ShellAlbert/PoFDualCAM/1-POF-PSU-C2/Schematic/SCH-PSU-C2.pdf

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
Here Vnormal=3.3V, Vcutoff=1.8V, t=10 seconds, I=100mA. C=[(Vnormal+Vcutoff)*I*t] / [(Vnormal^2-Vcutoff^2)] C=[(3.3+1.8)*0.1*10] / [3.3^2-1.8^2]=0.667F

## Farad Capacitor

The output voltage can be adjusted between 1.6V and 5.25V. Vout=1.004V*(R1/R2+1)=1.004V*(1M/270K+1)=4.72V

### LTC3105 400mA Step-Up DC/DC Converter Auxiliary 6mA LDO Regulator

Photovoltaic Cell

Photovoltaic Cell

VIN PIN
When used with high impedance sources such as photovoltaic cells, this pin should have a 10uF or larger decoupling capacitor.

MPPC PIN
Connect a resistor from MPPC to GND to program the activation point for MPPC loop. To disable the MPPC circuit, connect MPPC directly to GND.
VMPPC=10uA*RMPPC
=10uA*200K
=0.01mA*200K
=0.01A*200
=2V

THIS RESISTOR IS USED TO BYPASS AMP.

P5V0

### Vout=1.2V*(1+R2/R1) =1.2V*(1+1M/309K)

=5.08V

LTC3539
2A 1MHz Synchronous Step-Up DC/DC Converters VIN=0.7V~5V

## GAIN=1

ADA4051-1
1.8V,Micropower,Zero-Drift,
Rail-to-Rail Input/Output Op Amps 1/2Vcc | Input Independance >> 1M 1/3Vcc ADJ

## VCMP

# Open-Drain

## VCMP

OR

## OR Y=A|B

## AND Y=A&B

BIAS

Make sure IO is in tri-state during power up.

### MODE = High: Burst Mode operation at light loads, >=0.88V MODE = Low: Fixed frequency PWM Mode, <0.3V

CAUTION: No Polarity Protection Circuit Designed ! DIODES OR MOSFETS WILL CAUSE VOLTAGE DROP.

# IVC AMP

# BYPASS NOT

# CMP

LDO 2.2V/6mA
LDO22-1: UNIT GAIN AMP, HYSTERESIS VOLTAGE COMPARATOR, AND GATE LDO22-2: HYSTERESIS VOLTAGE COMPARATOR+OR GATE, OR GATE

OR

### AND

LED turns on at
I=(5.0-2.2)/56K=50uA

Vin_rise=Vref*(R1+R2)/R2
=1.0V*(160+300)/300
=1.53V

Vin_fall=(Vref*(R1+R2+Rpullup)-Vsupply*R1)/(R2+Rpullup) =(1.0v*(160+300+10000)-(2.2V*160))/(300+10000) =0.98

Since there's a 1/3 voltage divider before input,
the realistic action voltage are as follow ing Vin_rise=1.53V*3=4.59V
Vin_fall=0.98V*3=2.94V

Vin_rise=Vref*(R1+R2)/R2
=1.0V*(1000+5100)/5100
=1.2V

Vin_fall=(Vref*(R1+R2+Rpullup)-Vsupply*R1)/(R2+Rpullup) =(1.0v*(1000+5100+20000)-(2.2V*1000))/(5100+20000) =0.95V

Since there's a 1/2 voltage divider before input,
the realistic action voltage as follow ing Vin_rise=1.2V*2=2.4V
Vin_fall=0.95V*2=1.9V

# 1.9V(FALL) 2.4V(RISE)

# 2.94V(FALL) 4.59V(RISE)

L=Vout*(1-D)*T/(CR*Iout)
=5.0*(1-50%)*1uS/(30%*200mA) =4.2uH

Vfd=1.23V

Ve

R2

R1

R4

R3

Re

Rin

Appropriate Parameters
Case 1: R1=R2=R3=510, R4=560, Re=51, Rin=5.1K Case 2: R1=R2=R3=1K, R4=1.2K, Re=62, Rin=8.2K

CDONE,
Open-drain Output Configuration Done output. With weak pullup resistor to VCCIO_X.

# 1.8V IO

# SPI PROGRAMMING INTERFACE

# sysCONFIG Port / Pins

Horizontal-Short to Program Flash Vertical-Short to Program iCE

# OPEN-DRAIN PULL-UP

The sysCONFIG pins are dual function,
meaning they can be recovered as user I/O after configuration is complete.

# BUFFERING Octal RAM

2.0V

# ECL DRIVER

# CONNECT TO TMR/DPU POWER TO DPU

# RECEIVE: IVC->AMP->CMP->NOT

# OFFSET=1/2VCC

# NOT

VTH SETTING

The maximum source/sink current of IOs are 4mA.

## (1.8V IO)

## (1.8V IO)

## (1.8V IO)

EXCLUSIVE
LD_PWR_EN FOR TMR
LD_PWR_EN_EXT FOR DPU

EXCLUSIVE
PSU_UART_TX FOR TMR
DPU_UART_TX FOR DPU

EXCLUSIVE
PSU_UART_RX FOR TMR
DPU_UART_RX FOR DPU

TMR SENSOR NEEDS 3.3 V POWER SUPPLY. DROP DOWN TO 2.8V IF IT'S COMPATIBLE.

Inductor peak current automatic adjusting to maximize efficiency 100mA at light load, 500mA at heavy load,
100mA to 500mA at intermediate loads.
This function is overridden by MPPC function.
Theoretically, maximum power output of photovoltaic cell is 250mW.
If we set VMPPC to maintain 2V, the peak inductor current is 250mW/2=125mA.

The MPPC circuit dynamically regulates the average inductor current to prevent the input voltage from dropping below the MPPC threshold. When Vin is greater than the MPPC voltage, the inductor current is increased until Vin is pulled down to the MPPC set point.
If Vin is less than the MPPC voltage, the inductor current is reduced until Vin rises to the MPPC set point.

LC LOW PASS FILTER
f-cutoff=1/(2*pi*sqrt(L*C)) =1/(2*3.1415*sqrt(10uH*22uF)=1073Hz

0R

0R

Jumpers used to cut off power supply of FPGA if it’s useless in realistic application.

# LTC3539 BOOST

P5V0

# MAX38650 BUCK

P1V8

# LTC3542 BUCK

# LTC3542 BUCK

# LASER DIODE TX&RX (ADJ)

# SENSOR(5V0) TMR(3V3) ULTRASONIC(3V3)

# iCE40UP5K FPGA

P2V8

# MAX38650 BUCK

P2V8

P1V8

### CONNECT TO VCAP

TO GET HIGHER EFFICIENCY.

P1V2

Estimate the maximum output current is 30mA, and the ripple current is 0.4*30mA=12mA, then L=Vout/(f*Delta IL)*(1-Vout/Vin(max))=2.8/(2.25*0.012)*(1-2.8/5)=45.6uH
L=Vout/(f*Delta IL)*(1-Vout/Vin(max))=3.3/(2.25*0.012)*(1-3.3/5)=41.6uH

## Vfd=2.2V

P5033

LED turns on at
I=(2.8-2.2)/12K=50uA

Vout=0.6V*(1+R2/R1)
=0.6V*(1+150K/33.2K)
=3.3V

# MAX38650 BUCK

P1V2

# P2V9ADJ

Vout=0.6V*(1+R2/R1)
=0.6V*(1+150K/39K)
=2.9V

LTC3542 Maximum Output Current is 500mA
A reasonable starting point for setting ripple current is Deal_IL=0.4*Iout(Max)=0.4*500=200mA The largest ripple current occurs at the maximum input voltage.
L=Vout/(f*Delta IL)*(1-Vout/Vin(max))
=1.8/(2.25*0.2)*(1-1.8/5)
=2.56uH
Actually we estimate the maximum output current is 30mA, and the ripple current is 0.4*30mA=12mA, then L=Vout/(f*Delta IL)*(1-Vout/Vin(max)) =1.8/(2.25*0.012)*(1-1.8/5)
=42.6uH RUN PIN
>1.5V: Enabled.
<0.3V: Disabled.

Enable Bypass Resistor to distribute P5V0.

P5033

# P2V9ADJ

# LOAD SWITCH

VFD=0.37V@20mA

RATING POWER OF DIFFERENT FOOTPRINTS 0402 : 1/16W (0.0625w)
0603 : 1/10W (0.1W)
0805 : 1/8W (0.125W)

H/C Type
Compatible
2F/5.5V

H/C Type
Compatible
2F/5.5V

### REMOVE R17 TO CUT OFF

ICE40 POWER SUPPLY.

# FRONT PANEL LED

UV_SHDN determines how low voltage the Farad capacitor can discharge. In heavy load application like cameras, slow down trigger voltage threshold. Present State:
UV_SHDN=1, Vin_rise=1.2V, Magnification Factor=2, 1.2V*2=2.4V, Vin>2.4V UV_SHDN=0, Vin_fall=0.95V, Magnification Factor=2, 0.95V*2=1.9V, Vin<1.9V Optimization:
My motivation is to slow down magnification factor from 2 to 1.1
Change Magnification Factor=1.1
Vin_rise=1.2V, 1.2V*1.1=1.32V
Vin_fall=0.95V, 0.95V*1.1=1.04V
For magnification factor=2, ½, R2/(R1+R2)=1/2, we choose R1=R2=1M-OHMS. For magnification factor=1.1, 1/1.1, R2/(R1+R2)=1.1, we choose R2=1M, get R1=? 1M/(R1+1M)=1.1, 1M/1.1=R1+1M, R1+1M=909090.90, R1=-90909.10
R1 is negative value !!!!!!
So the only way is to replace ADCMP380-1(1.0V VREF) with ADCMP3890-2(0.5V VREF). Vin_rise=Vref*(R1+R2)/R2=0.5V*(1000+5100)/5100=0.6V Vin_fall=(Vref*(R1+R2+Rpullup)-Vsupply*R1)/(R2+Rpullup) =(0.5*(1000+5100+20000)-(2.2*1000))/(5100+20000)
=0.432V
If the magnification factor of front stage is still 2, the trigger voltages are Vin_rise_action=0.6V*2=1.2V
Vin_fall_action=0.432V*2=0.864V
But the second boost converter LTC3539 can only work over 0.7V, this should grab our attention.

# CHARGING INDICATOR

# ADCMP380-1ACBZ-RL7, VRef=1.0V ADCMP380-2ACBZ-RL7, VRef=0.5V

LDO22-1

LDO22-2 VCAP

LDO22-2 VCAP

LDO22-2

LDO22-2

LDO22-2

LDO22-2 | LDO22-1
LDO22-1 | P1V8_RX

P1V8_RX

P1V8_RX

P1V8_RX

P1V8_RX

LDO22-1

VCAP

P1V20 | SPI_VCCIO1 P1V80 | P1V80 P1V20 | P1V80 P2V8 | P1V80 P1V80 VCCIO_0 P1V80 | P1V80 VCCIO_2 | P1V80 P1V80 | P1V80 | P1V80 P5V0

P2V8

P5V0 | P5V0 | P5033
P1V8 | P1V80 P1V2 | P1V20 P1V20
LDO22-1 | P¹V⁸_RX

P1V8_RX

P5V0

VCAP1 VCAP2 | P5V0 | P2V8 P1V8 P5V0 P5V0 P5V0 | P1V2 | P5033 P5V0 | P5033_PRE
P5V0 | P2V9ADJ P1V8ADJ_PRE

P2V9ADJ

P1V8 P2V9ADJ | P1V8_RX

VCAP

P5V0 VCAP

LDO22-2 | Title Size | Document Number | Rev Date: | Sheet | of PoF TINY DUAL CAMERA PROJECT | C2 PART ONE - POWER SUPPLY UNIT SCHEMATIC
A2 | Thursday, June 12, 2025 | 1 | 1 Title Size | Document Number | Rev Date: | Sheet | of PoF TINY DUAL CAMERA PROJECT | C2 PART ONE - POWER SUPPLY UNIT SCHEMATIC
A2 | Thursday, June 12, 2025 | 1 | 1 Title Size | Document Number | Rev Date: | Sheet | of PoF TINY DUAL CAMERA PROJECT | C2 PART ONE - POWER SUPPLY UNIT SCHEMATIC
A2 | Thursday, June 12, 2025 | 1 | 1
R116 10K C59 | 0.1uF | R⁵ 20K

R119 0

R88

0

R1
20K

C52

10uF U15 LTC3105EDD#PBF

FB

1

LDO

### 2 FBLDO

### 3 SHDN

### 4 MPPC

# 5 VIN

### 6 SW

### 7 PGOOD

### 8 VOUT

### 9 AUX

10 | 11 GND | R¹²⁶ 0
R6 | 1K R54 | 1K | R19 | DNP
R76 DNI | TP8

L8

2.2uH

C73

22uF | R¹² 6.8K

C30

10uF

# J1 CONN-1X8

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
### 9 U3 APS25608N-OBR-BD

RST A4 | CE
A3 | | | | | | | | | CLK
B2 | A/DQ0 D3 | A/DQ1 D2 | A/DQ2 C4 | A/DQ3 D4 | A/DQ4 D5 | A/DQ5 E3 | A/DQ6 E2 | A/DQ7 E1 | DQS/SM
C3 | VDD
D1 VSS | C1 VDD

# E4 VSS

E5 NC.A2 | A2 NC.A5 | A5 NC.B1 | B1 NC.B3 | B3 NC.B4 | B4 NC.B5 | B5 RFU
C2 NC.C5 | C5 R118 DNP

C72

22uF

C68
0.1uF
L4 | 2.2uH/200mA | C76 | 0.1uF
D6 GREEN LED C130723 | R⁴ 20K

FB4 BLM15PX121SN1D

R63 | 0
R10 | 0 | R121 | 0 TP21
R18 | 10K
R109 | 0

R66 DNI C29

1uF | R¹⁴ 6.8K

C62

33pF C44

10uF | R³ 20K
R100 DNP | C35

0.1uF R113 DNP

L7 2.2uH

D5 GREEN LED

C130723

U22 | SN74LVC1G32DBVR

C10096 1 A

### 2 B

### 3 GND

### 4 Y

### 5 VCC

C51

0.1uF C43 0.1uF

C45

10nF C21

0.1uF | R41 100R
U8 | MAX38650AANT+ A²
IN | LX A1 | OUT B2 EN
B1 | RSEL | B3 A³ GND | R¹³ 6.8K
TP16 | R60
20K | R114 0

R38

200K

L2 | 2.2uH/200mA
C75 | DNP

TP20

U5 W25Q64JWSSIQ
CS
1 | DO(IO1) 2 | WP(IO2) 3 | GND
DI(IO0) | 4

### 5 CLK

6 | HLD/RST(IO3) 7 | VCC
8 R90 | 0 C64
10uFR72 | 160

SW1

1 2

D9 GREEN LED

C130723 | R2 | 0

C23

10uF

L6 | 10uH/1A C177242

C54

10uF R91 | 0 TP10 | R7 | 1K | C46

0.1uF

D7

1N5819WT | iCE40UP5K - SG48 | Bank1 Bank0 | Bank2

iCE40UP5K- SG48

U4

C2678152 | IOB_0A

46

IOB_2A

47
IOB_3B_G6

44

IOB_4A

48
IOB_5B

45

IOB_6A

2

IOB_8A

4
IOB_9B

# 3 CRESET_B

### 8 CDONE

7

IOB_13B

6

IOB_16A

9

IOB_18A

### 10 IOB_20A

11

IOB_22A

12
IOB_23B

21
IOB_24A

13
IOB_25B_G3

20
IOB_29B

19
IOB_31B

18

IOB_32A_SPI_SO

### 14 IOB_33B_SPI_SI 17 IOB_34A_SPI_SCK

### 15 IOB_35B_SPI_SS

### 16 VCCPLL

29

IOT_36B

### 25 IOT_37A

23

IOT_38B

### 27 IOT_39A

26

IOT_41A

28

IOT_42B

### 31 IOT_43A

32

IOT_44B

### 34 IOT_45A_G1

37

IOT_46B_G0

35

IOT_48B

### 36 IOT_49A

43

IOT_50B

### 38 IOT_51A

### 42 RGB0

### 39 RGB1 40 RGB2

# 41 GND 49 VCC

### 5 VCC

# 30 VCCIO_0

### 33 SPI_VCCIO1

# 22 VCCIO_2

### 1 VPP_2V5

24 U2 | MAX38650AANT+ A²
IN | LX A1 | OUT B2 EN
B1 | RSEL | B3 A³ GND
R42 | 1K | Q6 MMBT2222ALT1G

TP9

C8 0.47uF

R106 0 TP4

TP2

C39

0.1uF

R92 10K

C31

10uF

R35
510
R59 | 0
R25 | DNP
R67 | 3.3K R79

300

R15 | DNP
D8 | GREEN LED C130723
R95 | 2K C5 CEN5R5205HF-ZG

1 2

3 4

C57
0.1uF R32

51

C32

1uF | C56
0.1uF | R¹⁷ 0 R87 DNI C28

22pF

C71 0.1uF

R39
1M

REF

+

- U16 | ADCMP380-(1/2)ACBZ-RL7 A¹ VCC GND A² B1 EN | GND B²

IN

C1 | OUT C2 C42 | 2.2uF | R97 | 0

C22

0.1uF R56
1M

L12 0R

R16 DNI

R82
10K
R89 DNI | U21 LTC3539EDCB-2#TRPBF SW

### 1 PGND

### 2 GND

# 3 VIN

### 4 SHDN

### 5 FB

### 6 MODE

### 7 VOUT

### 8 EPAD

9

R93 | 10K | R29

510

C6 CEN5R5205HF-ZG

1 2

3 4

U12 OPA320AIDBVROUT

### 1 V⁻ 2

IN+

3

IN- 4 V⁺

5

Q7 MMBT2222ALT1G

R52
5.1K | C49 | 22pF R36

39K

C2710uF | R80 | 150K

TP22

C24

10nF R44

2M

D4GREEN LED

## FB1BLM¹⁵PX¹²¹SN¹D

C65
0.1uF

TP14 Solar Cell V-

U10

LMV7291MGX/NOPB VOUT

1 | V⁻ 2 | +IN

3

| | -IN

### 4 V⁺

5

C3

10uF

LD1 LaserDiode
LD+

1
LD- 2 | PD- | 3 PD+

4

C67

22uF | C63

0.1uF

TP12 Solar Cell V+ | C40.1uF R61
200K | R¹⁰⁸ DNI
R70 | 0
R75 | 12K R73 | 0 | D3GREEN LED
C1 | 0.1uF | C58
10uF | D2GREEN LED
R71 | 3.3K

TP6

C9

10nF

C70 0.1uF CONN-24P J3

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
0.1uF

## FB2BLM¹⁵PX¹²¹SN¹D

U13 | ADA4051-2ARMZ C160715

### 1 OUT A -IN A

2 +IN A
3

### 4 V-8 V+ OUT B 7

-IN B

6 +IN B

5 | C55 | 0.1uF | R123 | DNP
TP18 | R⁹⁶
| 0
L11 47uH/100mA | R⁵⁷ 4.7K
R22 | 0 CONN-24P J2

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
### 13 R⁵⁵ 4.7K

TP3

# TP1 R⁶⁸ 10K

R31
510

C33

22pF

L1 47uH/200mA

C25

0.1uF C61

0.1uF

REF

+

- U18 | ADCMP380-(1/2)ACBZ-RL7 A¹ VCC GND A² B1 EN | GND B²

IN

C1 | OUT C2 C48 | 2.2uF | R101 DNP

C10

0.1uF

# J4 CONN-1X8

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
### 9 C16

47uF U1
LTC3542ES6 VIN

### 1 GND

### 2 VFB

### 3 RUN

### 4 MODE/SYNC

### 5 SW

### 6 TP19

L10 | 4.7uH/200mA

TP11 Solar Cell V-

Q1

BFR93AWH6327 | B1

### 3 C

2E

## C120.1uF

R48
1M

R128 1K

R62
270K

R104 6.8K

U17

SN74LVC1G32DBVR 1 | C10096 A

### 2 B

### 3 GND

### 4 Y

### 5 VCC

R117 | DNP | R⁴⁵ 10K | R111 | 10K R33

510

R58 40.2K

R124 DNP

C26

10nF

C69

0.1uF

C53

22uF

R53 | 100K | C17
| | 47uF

TP15

FB3

BLM15PX121SN1D C6010uF | U6 | MAX38650AANT+ A²
IN | LX A1 | OUT B2 EN
B1 | RSEL | B3 A³ GND
R84 | 20K

C18

10uF

Q2

BFR93AWH6327 1B

### 3 C

2E

R120 100K | R²⁷ DNP

C11
0.1uF
C37 | 0.1uF | R⁷⁷ 10K

C34

22uF R⁴⁶ DNI | R115 DNP
R86 | 2.2K R83 | 100K
L3 | 2.2uH/200mA

U9 SN74LVC1G14DBVR
NC

### 1 A 2 GND 3 Y

### 4 VCC

5

R49
270K

R11
51
R112 11.8K R37 | 150K | Q5 | MMBT2222ALT1G

R103
100K

R64 DNP

## PD1Photodiode

1 2

R127 20K

U19
LTC3542ES6 VIN

### 1 GND

### 2 VFB

### 3 RUN

### 4 MODE/SYNC

### 5 SW

6

L5 | 10uH/1A C177242 | C50
0.1uF | C41

0.1uF U14 LTC3105EDD#PBF

FB

1

LDO

### 2 FBLDO

### 3 SHDN

### 4 MPPC

# 5 VIN

### 6 SW

### 7 PGOOD

### 8 VOUT

### 9 AUX

10 11 GND

R8 | 1K
R78 | 0 TP13 Solar Cell V+ | R⁵¹ 10K
R102 1K | C66 | 1.5pF

## FB5BLM¹⁵PX¹²¹SN¹D

C19 | 22pF
L9 | 2.2uH
Q4 | MMBT2222ALT1G
R47 | 0 | C70.1uF | R122 DNP R34 | 0 R³⁰ DNI
C4710uF R¹²⁵ 0 | R107 0 | C13

0.1uF

R65 | 0 | C36

10nF

R26 | 0 | Q3 MMBT2222ALT1G

C14

47uF | R24 | DNP R23 | DNP

R69 0 R74 0 R43

1M

R81

33.2K C38 | 0.1uF
R50 | 510

R9
20K

U7 TPS22995HQDDCRQ1 VIN

### 2 VBIAS 1 ON 3 GND

RT 4

### 6 VOUT

### 5 C15

0.1uF

C20

10uF | R99 | 0 | R²⁰ DNP

D1 GREEN LED

C130723 | U11 OPA320AIDBVR OUT

### 1 V⁻ 2

IN+

3

IN- 4 V⁺

### 5 TP7 R98

309K

TP5

R105

1M

C40

10nF

R28 | DNP R21 | 0

TP17 U20

SN74AUP1G08DBVR

C139409 VCC

### 5 GND

### 3 A

### 1 B

### 2 Y

### 4 R40

1M

R85 | DNP | C74
47uF R94 | DNP | R110 10K

UV_SHDN

CHG_FULL | 1ST_EN

IO_P5V0_SHDN

LOCK_EN

FP2_SO | FL2_MOSI FL2_MISO | FP2_SI FF2_SS | FF2_SS
FF2_SCK | | FF2_SCK
FP2_SI | FL2_MOSI FP2_SO | FL2_MISO
| | FL2_WP
FP2_RST | | FL2_RST
FP2_DONE

IO3 SPI1_NSS

IO2 SPI2_NSS

IO7
IO1 | DONE2_LED
IO4
IO_P5V0_SHDN
IAM_ALIVE
SPI2_MISO | PSU_UART_RX
FP2_SI SPI1_MISO

FF2_SS

SPI2_SCK

FF2_SCK

SPI1_SCK

FP2_SO

IO6 SPI1_MOSI RAM_RST

IO5 RAM_ADQ1 | | | | PSU_UART_TX LD_PWR_EN
RAM_ADQ2 | RAM_ADQ6 RAM_DQS | RAM_ADQ3 SPI2_MOSI | RAM_ADQ5 RAM_CLK | RAM_ADQ4 RAM_ADQ0 RAM_ADQ7

LED0
LED1
LED2 | RAM_RST RAM_CE RAM_CLK RAM_ADQ0 RAM_ADQ1 RAM_ADQ2 RAM_ADQ3 RAM_ADQ4 RAM_ADQ5 RAM_ADQ6 RAM_ADQ7 RAM_DQS

LED0

LED1

LED2

DPU_UART_RX | IO5 DPU_UART_TX | IO6 SPI2_MOSI | SPI1_MOSI SPI2_SCK | SPI1_SCK
SPI2_MISO | SPI1_MISO
SPI2_NSS | SPI1_NSS
IO1
IO2 | IO3 LD_PWR_EN_EXT
IO_P5V0_SHDN_EXT | IAM_ALIVE_EXT

IAM_ALIVE

IAM_ALIVE_EXT | SIG_ALIVE

RAM_CE

IO_P5V0_SHDN_EXT

FP2_RST

FF2_SS
FP2_SI

PSU_UART_TX DPU_UART_TX

PSU_UART_RX DPU_UART_RX

LD_PWR_EN

LD_PWR_EN_EXT | RX_PWR_EN

RX_PWR_EN

IO4

IO7

1ST_EN
LOCK_EN

LED1
LED0
