ShellAlbert/PoFDualCAM/IR_VL_UV_Image_Sensor/IR_Communication_Protocol_Desc.docx

本设备工作于半双工模式，采用串行通信协议，周期性的上传图像和测温数据。由于本设备需要充满电才能触发工作一次，所以两次数据上传间隔不低于2分钟。

通信双方按照以下规约进行数据接收：

波特率为4Mbps，起始位（1 bit），数据位（8bits），奇偶校验无，停止位（1 bit）。

单行数据格式：

每一行数据包括引导头和数据区，其中引导头固定是16个字节，数据区域分为像素区域和温度区域，都是256*2=512字节。单行数据共计1040个字节。从引导头可以判断出当前数据属于哪一行。像素数据格式为YCbCr，亮度Y为8bits的灰度值，色度Cb和Cr都为8bits。对于温度区，Temp[7:0]表示温度数据的低8位，Temp[15:8]表示温度数据的高8位，温度的有效数据位为低14位，高两位补0。

| 标识 | 数据内容 | 占用字节数
第x行引导头 | EAV | FF XX XX XX | 4
| SAV | FF XX XX XX | 4
| EAV | FF 00 00 9D | 4
| SAV | FF 00 00 80 | 4
第x行数据区 | 像素区域 | Cb Y Cr Y | 256*2
| 温度区域 | Temp [7:0]+Temp[15:8] | 256*2

单帧数据格式：

整个红外图像的分辨率是256*192，每一个像素点同时对应一个温度值，数据输出采用逐行扫描的方式。单帧数据包括192行和CRC32校验值。单帧数据的总数据量是192*1024+4=196612字节。

注意只有第0行（帧开始）的引导头是特殊的，固定为 FF 00 00 B6 FF 00 00 AB FF 00 00 9D FF 00 00 00 80，这是因为FPGA匹配到了图像传感器输出数据的序列。从第1行开始，引导头的第一个4 字节固定为FF FF FF FF，第二个4字节固定为00 00 00 01，这里的01表示这是第1行，第三个4 字节固定为FF 00 00 9D，最后一个4字节固定为FF 00 00 80。

行序号 | 数据 | 字节数 | 说明
第0行引导头 | FF 00 00 B6 FF 00 00 AB FF 00 00 9D FF 00 00 80 | 16 | 标识新的一帧数据的开始。
第0行数据区 | xx xx xx xx .. .. .. .. xx xx xx xx | 1024 | 前256*2是像素数据， 后256*2是温度数据。
第1行引导头 | FF FF FF FF 00 00 00 01 FF 00 00 9D FF 00 00 80 | 16 | 其中 00 00 00 01 表示这是第1行数据。
第1行数据区 | xx xx xx xx .. .. .. .. xx xx xx xx | 1024 | 前256*2是像素数据， 后256*2是温度数据。
第2行引导头 第2行数据区 … … … … 第190行引导头 第190行数据区 | … | … | …
第191行引导头 | FF FF FF FF 00 00 00 BF FF 00 00 9D FF 00 00 80 | 16 | 0xBF=191
第191行数据区 | xx xx xx xx .. .. .. .. xx xx xx xx | 1024 | 前256*2是像素数据， 后256*2是温度数据。
数据校验区 | XX XX XX XX | 4 | CRC32校验值，校验区域包括从第0行引导头到第191行数据区。
