ShellAlbert/PoFDualCAM/1310nm_Laser_Diode_Datasheet/IMG_20250507_083224.jpg

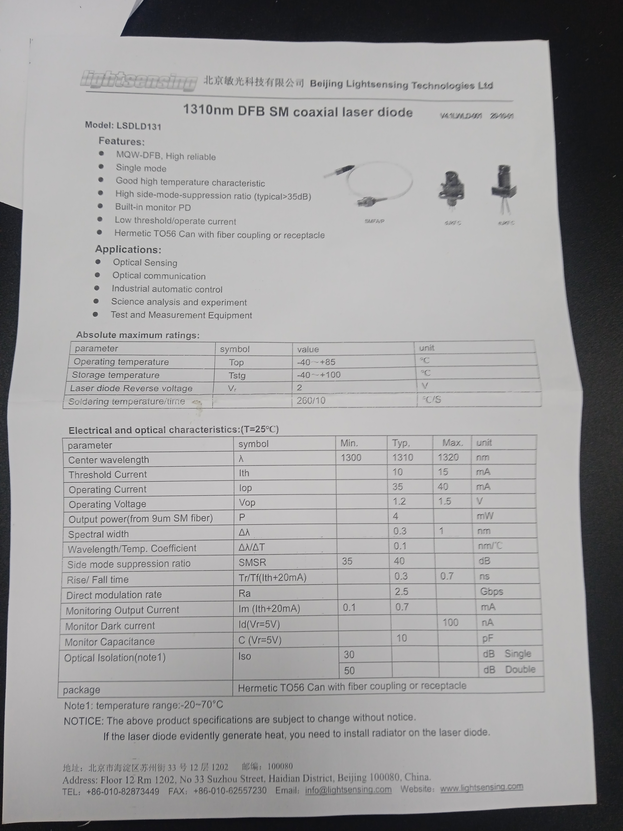
1310nm_Laser_Diode_Datasheet/IMG_20250507_083224.jpg
