ShellAlbert/PoFDualCAM/1310nm_Laser_Diode_Datasheet/IMG_20250507_083319_1.jpg

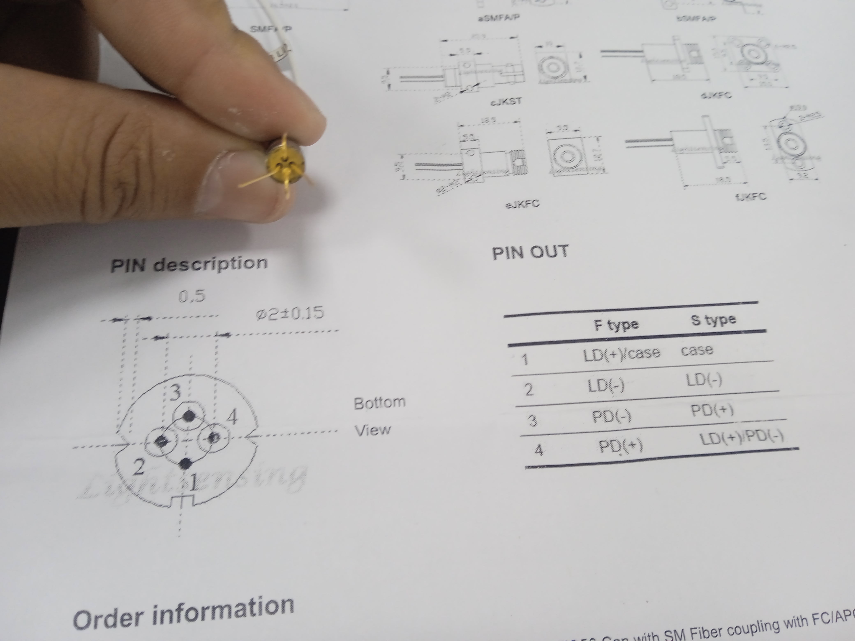
1310nm_Laser_Diode_Datasheet/IMG_20250507_083319_1.jpg
