ShellAlbert/PoFDualCAM/IR_VL_UV_Image_Sensor/1752816617756.jpg

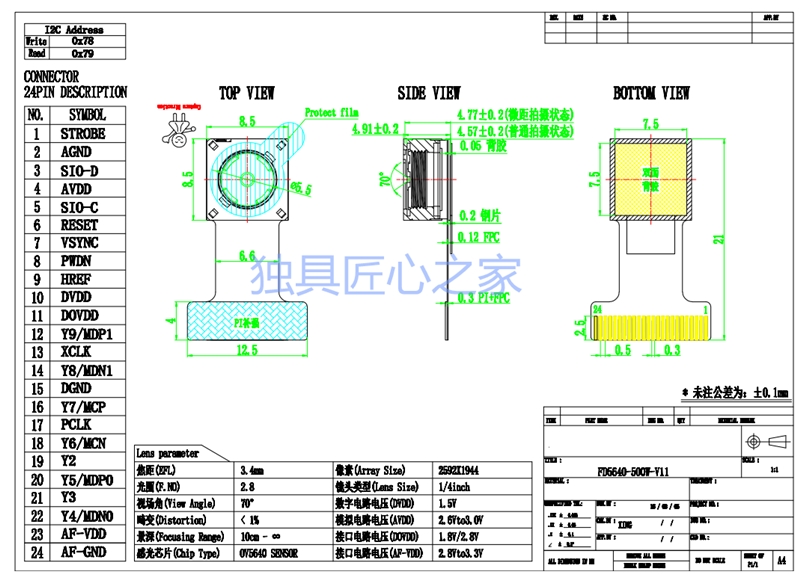
IR_VL_UV_Image_Sensor/1752816617756.jpg
