ShellAlbert/PoFDualCAM/IR_VL_UV_Image_Sensor/clock.jpg

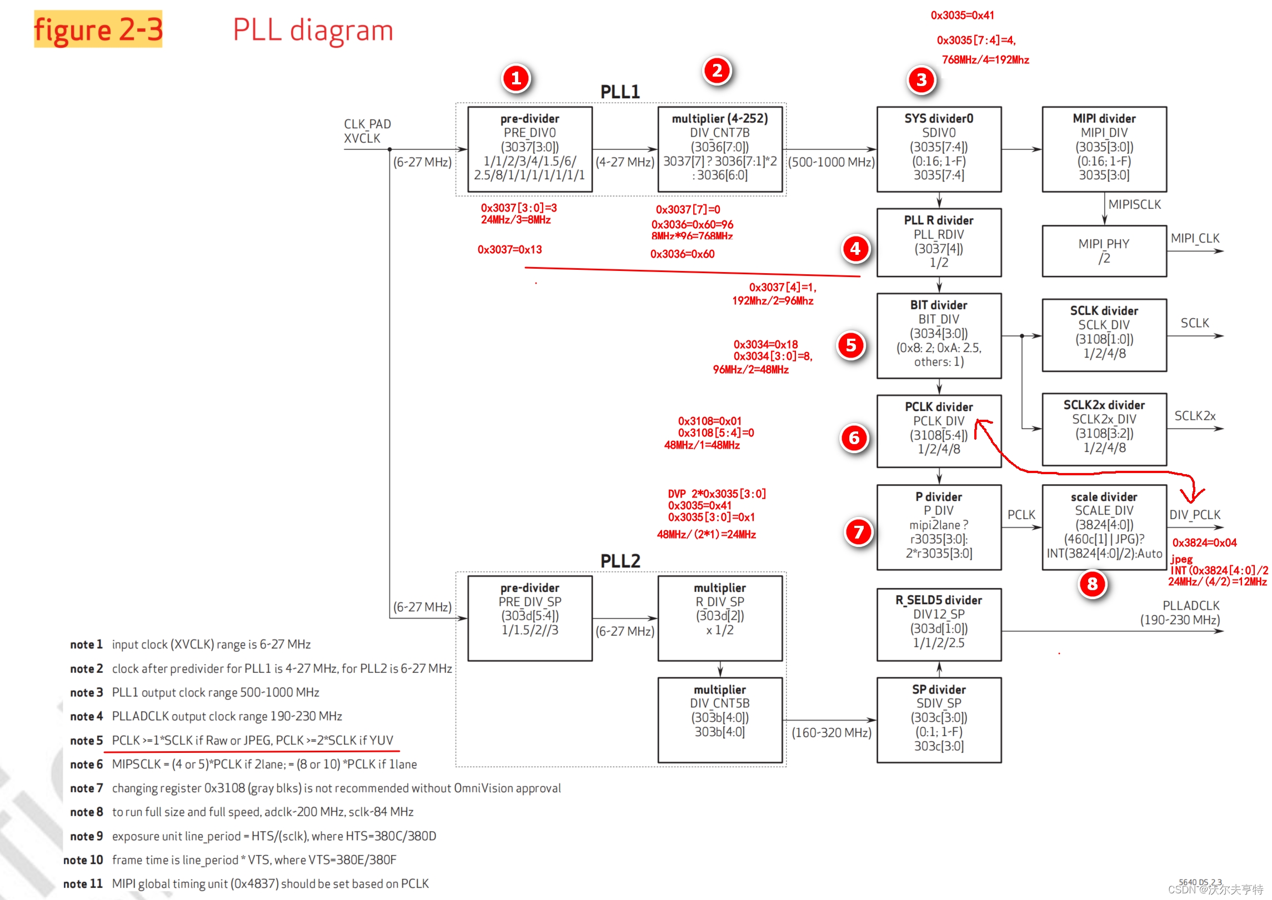
IR_VL_UV_Image_Sensor/clock.jpg
