ShellAlbert/PoFDualCAM/IR_VL_UV_Image_Sensor/OV5640_Pinout_Comparison.jpg

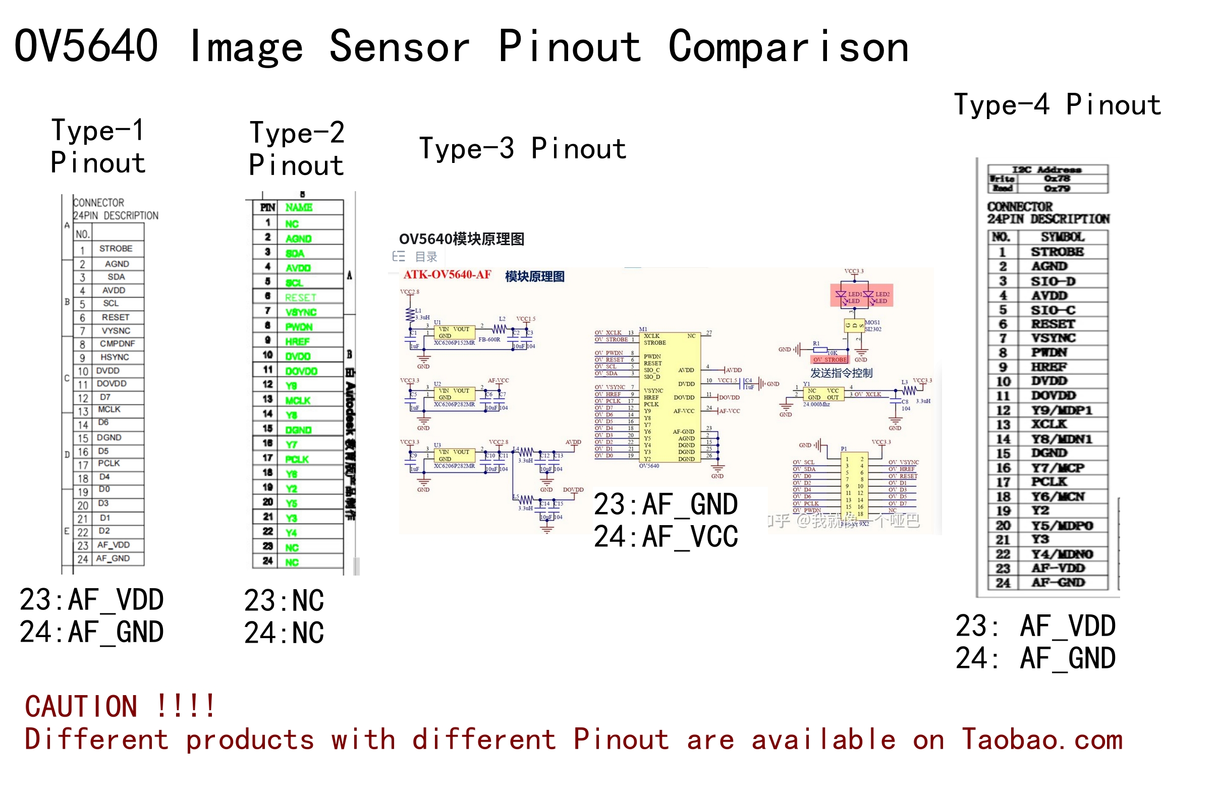
IR_VL_UV_Image_Sensor/OV5640_Pinout_Comparison.jpg
