ShellAlbert/PoFDualCAM/IR_VL_UV_Image_Sensor/sccb_read.png

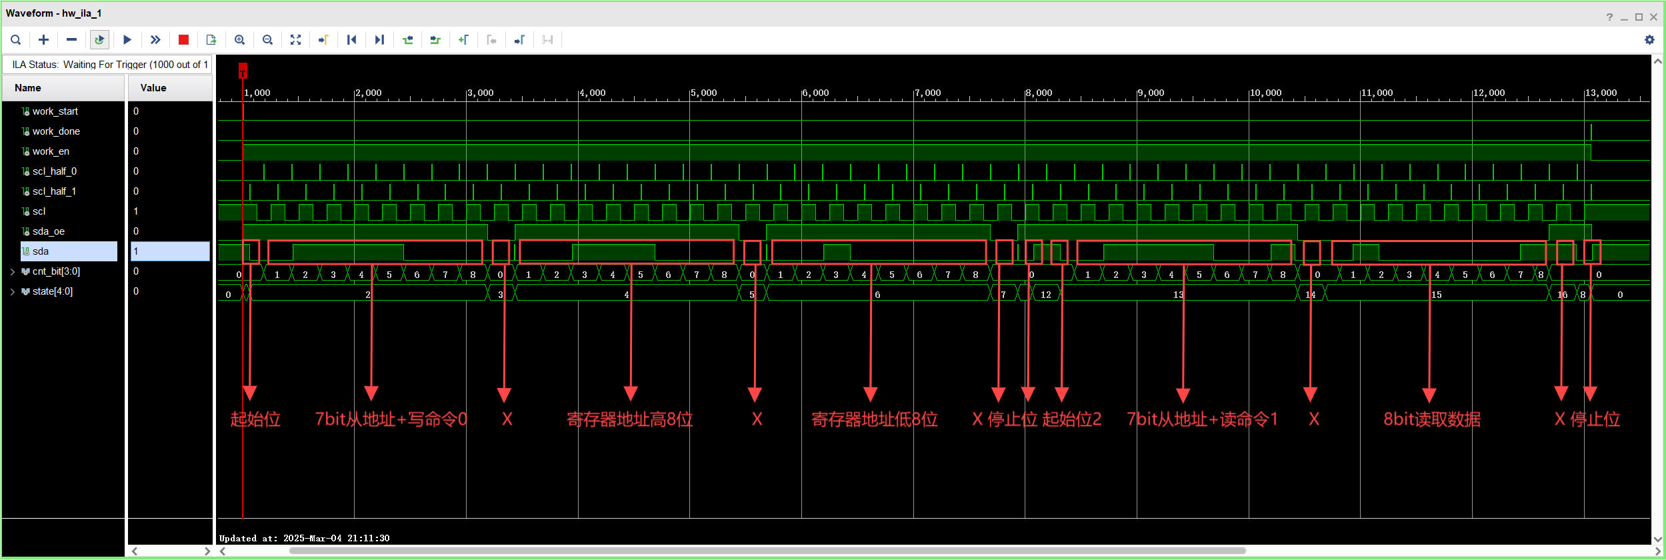
IR_VL_UV_Image_Sensor/sccb_read.png
