ShellAlbert/PoFDualCAM/IR_VL_UV_Image_Sensor/sccb_write.png

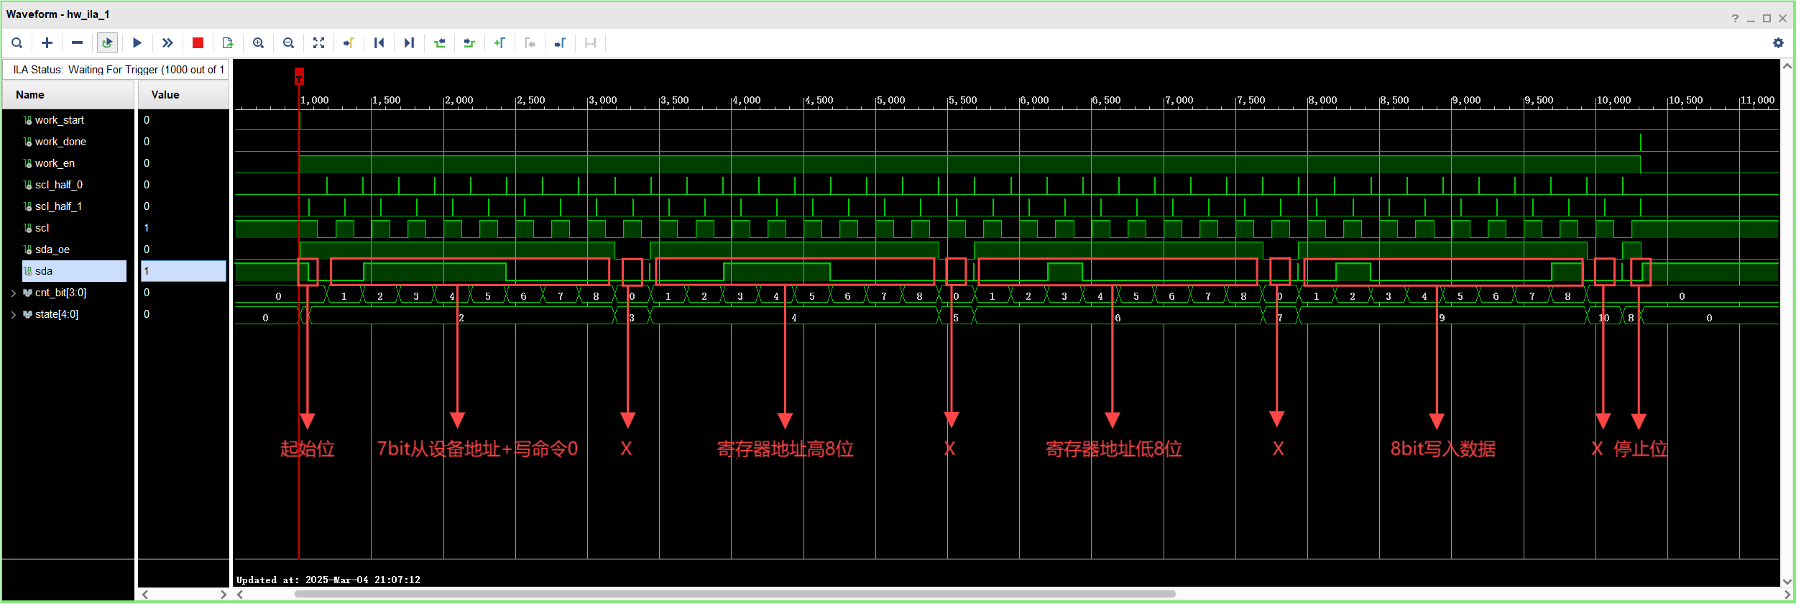
IR_VL_UV_Image_Sensor/sccb_write.png
