ShellAlbert/PoFDualCAM/2-DPU_HyperRAM_Version/Code/CAT25512_IP_MANUAL_V0.0.1.pdf

EEPROM CAT5512 IP Manual V0.0.1

### 1. Block Diagram & Pinout

iClk | IN | 100MHz Clock Input.
iRstN | IN | Acve Low.
iEn | IN | Keeps HIGH during operaon period unl oOpDone becomes HIGH.

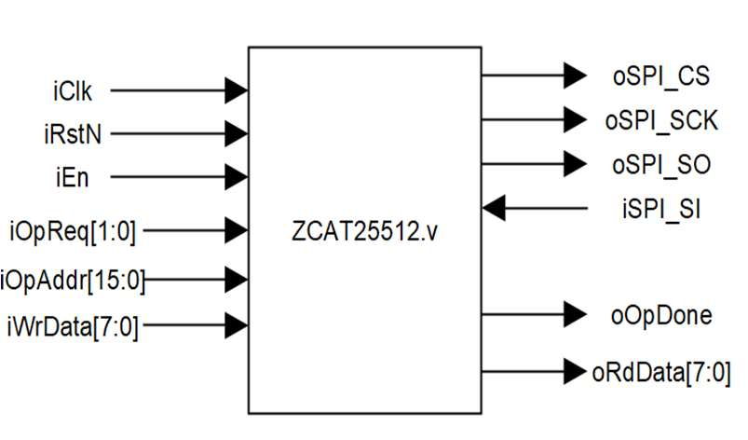
[picture p44: figure]

iOpReq[1:0] | IN | 2’b00: Write Request. 2’b01: Read Request.
iOpAddr[15:0] | IN | Write or read address, Range: 0x0~0xFFFF-1
iWrData[7:0] | IN | Data write into specific address.
oRdData[7:0] | OUT | Data read from specific address.
oOpDone | OUT | Operaon done signal.
oSPI_CS | OUT | Route to Top Layer, connect to physical IC.
oSPI_SCK | OUT
oSPI_SO | OUT
iSPI_SI | IN

### 2. Timing

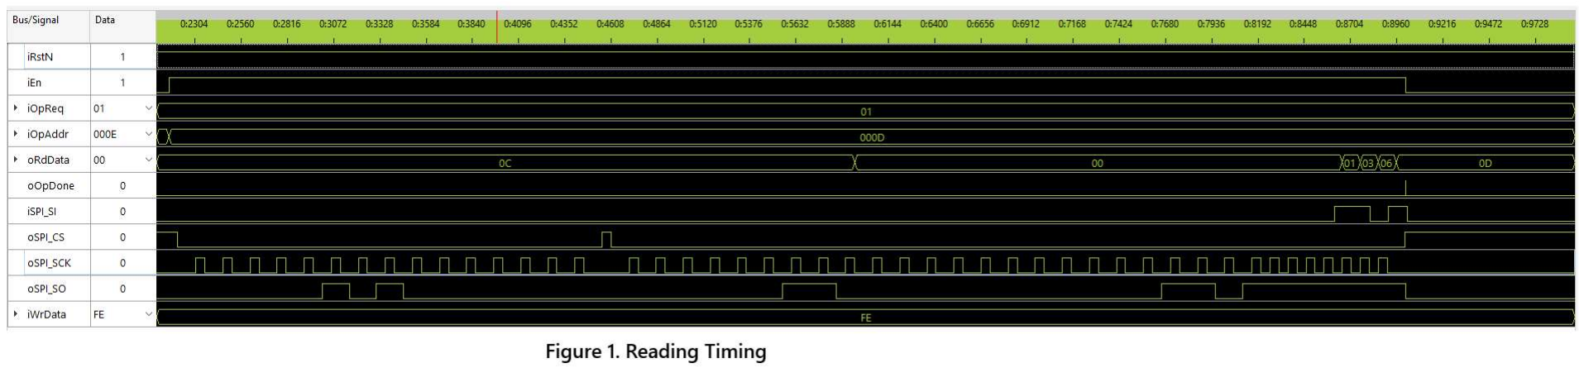
[picture p45: figure]
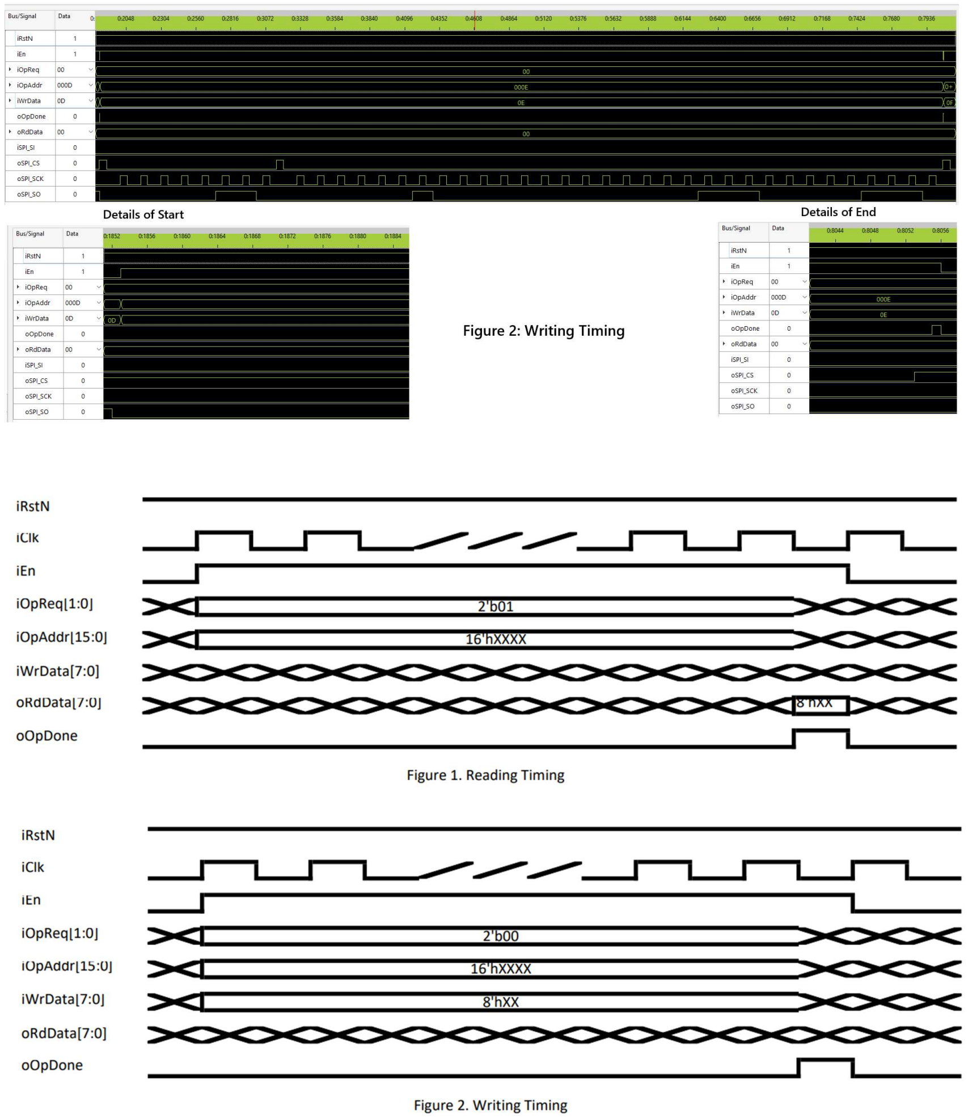
[picture p46: page 2]

### 3. Module Working Principle Brief Descripon

This module supports SPI compable EEPROM operang, includes reading and wring. All signals must meet the requirement in Timing diagram. iEn must stays in HIGH during operang period unl oOpDone becomes HIGH. Only byte read/write are supported in this version. Burst operaon will be provided in next upgrade. Make all input signals ready before pulling up iEn, and keeps them steady during operaon. Pull up iEn to start, oOpDone will be pulled up for only single pulse to indicate operaon finishes. Once oOpDone is HIGH, pull down iEn immediately.
Since the maximum clock frequency of SPI clock is 5MHz, this module divides the input clock by 50, the ulmate operaon frequency is 2MHz.

### 4. Pin Constraint Contents

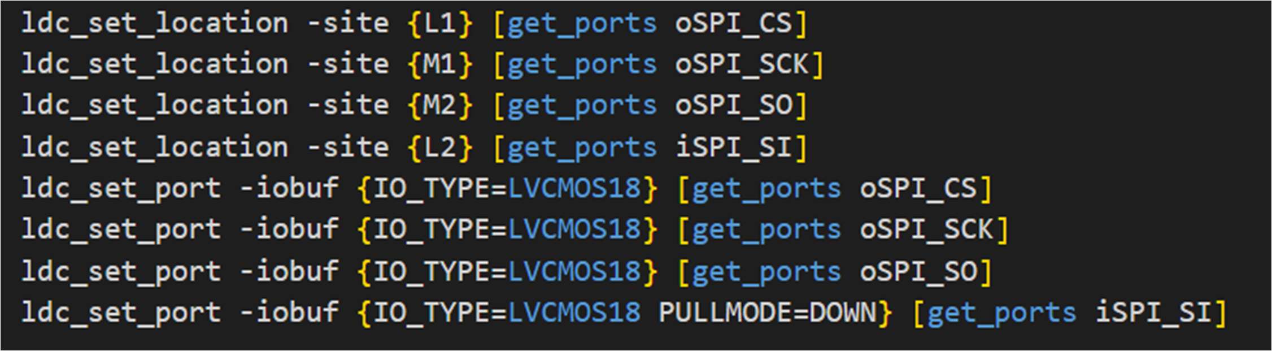
[picture p47: figure]

## CAUTION!!!

Official specificaon shows CAT25512 chip only has 1,000,000 Program/Erase Cycles !!! Connuously Wring the same address will cause cells damaged permanently !!! Balanced Wring Strategy can be used in top design to extend chips lifecycle.
