ShellAlbert/PoFDualCAM/PoE_W5500/PoE_Test_Snapshots/PoE-10_100BASE_T-snapshot-1.png

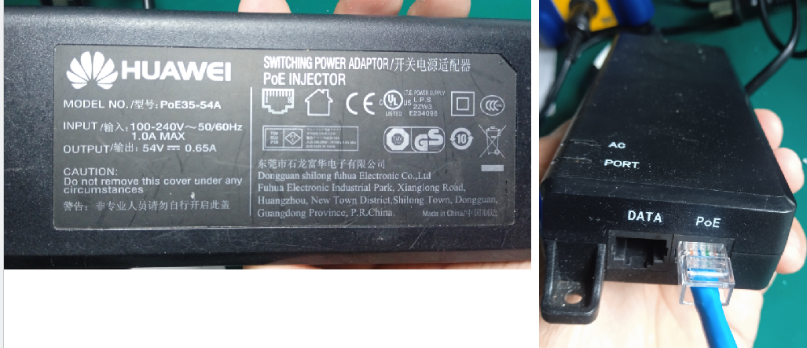
PoE_W5500/PoE_Test_Snapshots/PoE-10_100BASE_T-snapshot-1.png
