ShellAlbert/PoFDualCAM/PoE_W5500/PoE_Test_Snapshots/PoE-10_100BASE_T_snapshot-2.jpg

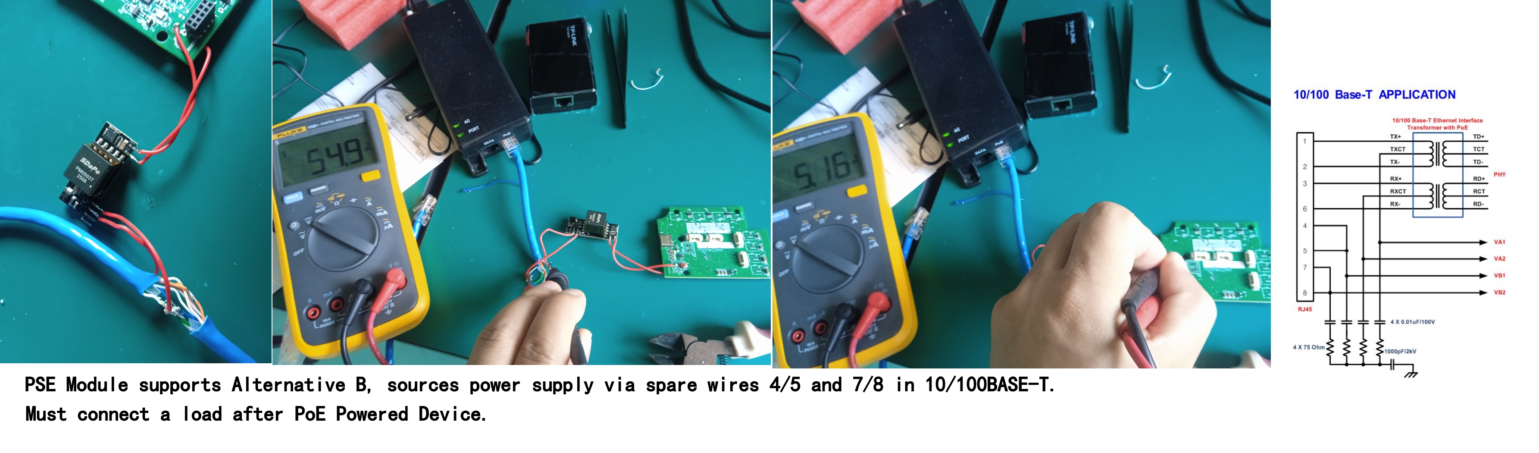
PoE_W5500/PoE_Test_Snapshots/PoE-10_100BASE_T_snapshot-2.jpg
