ShellAlbert/PoFDualCAM/PoE_W5500/PoE_Test_Snapshots/PoE_1000BASE_T_Snapshot.jpg

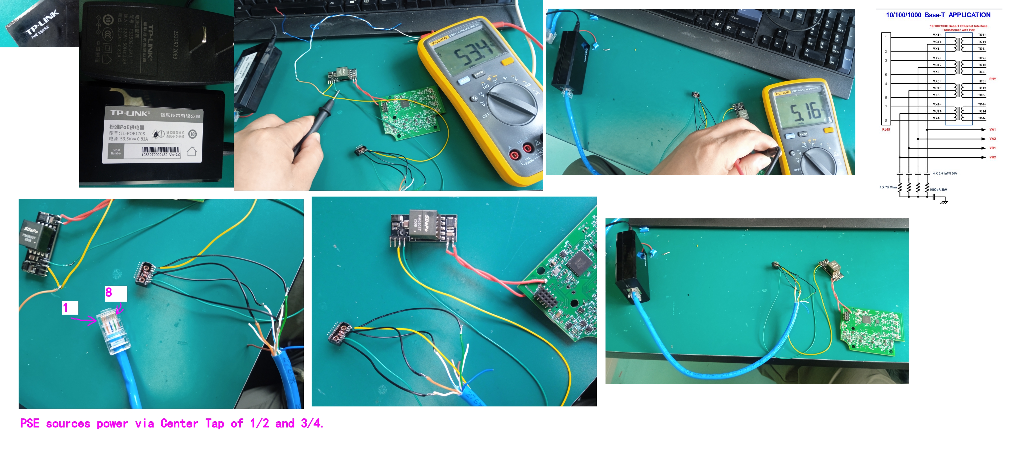
PoE_W5500/PoE_Test_Snapshots/PoE_1000BASE_T_Snapshot.jpg
