ShellAlbert/PoFDualCAM/PoE_W5500/PoE_Test_Snapshots/Read_Registers.jpg

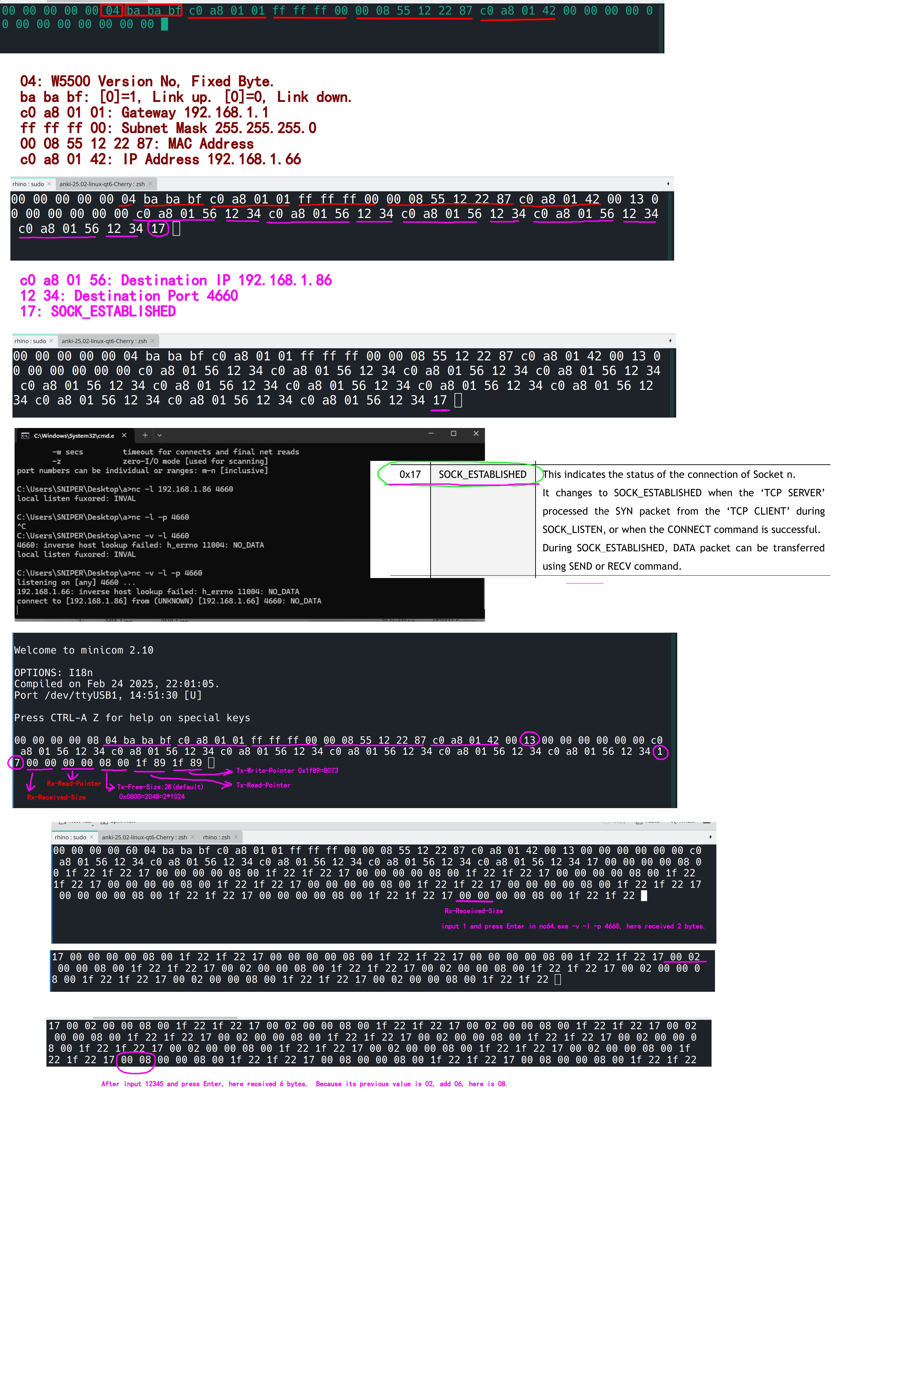
PoE_W5500/PoE_Test_Snapshots/Read_Registers.jpg
