ShellAlbert/PoFDualCAM/2-DPU_HyperRAM_Version/Debug_Documents/SubLVDS_1V8.pdf

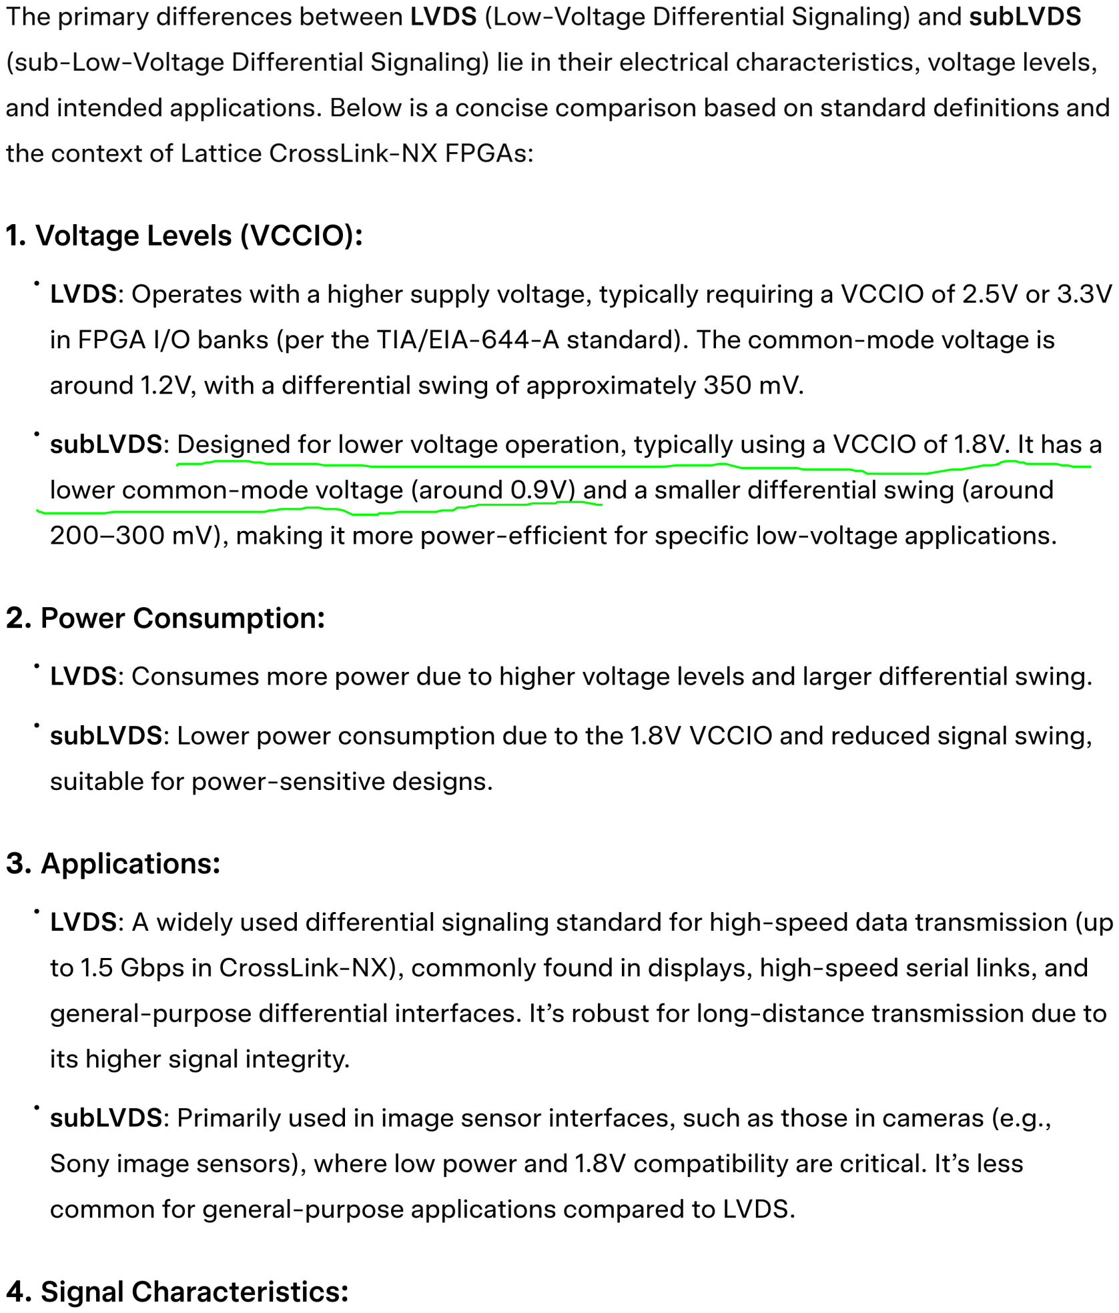
[picture p52: page 1]
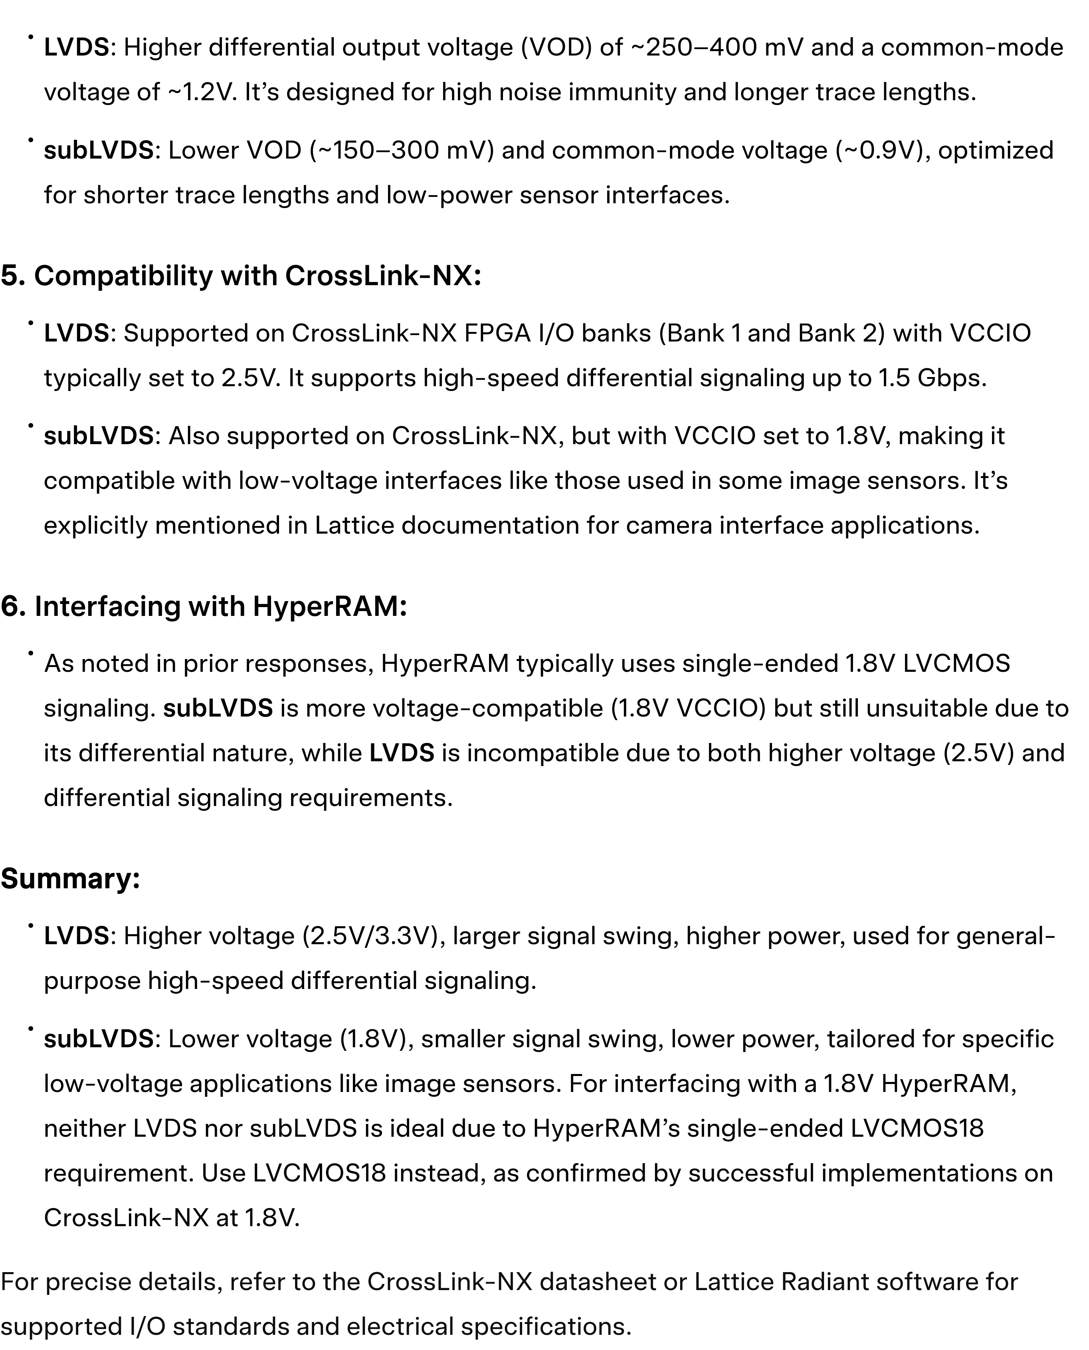
[picture p53: page 2]
