ShellAlbert/PoFDualCAM/2-DPU_HyperRAM_Version/Debug_Documents/SubLVDS_SubLVDS-Emulation.pdf

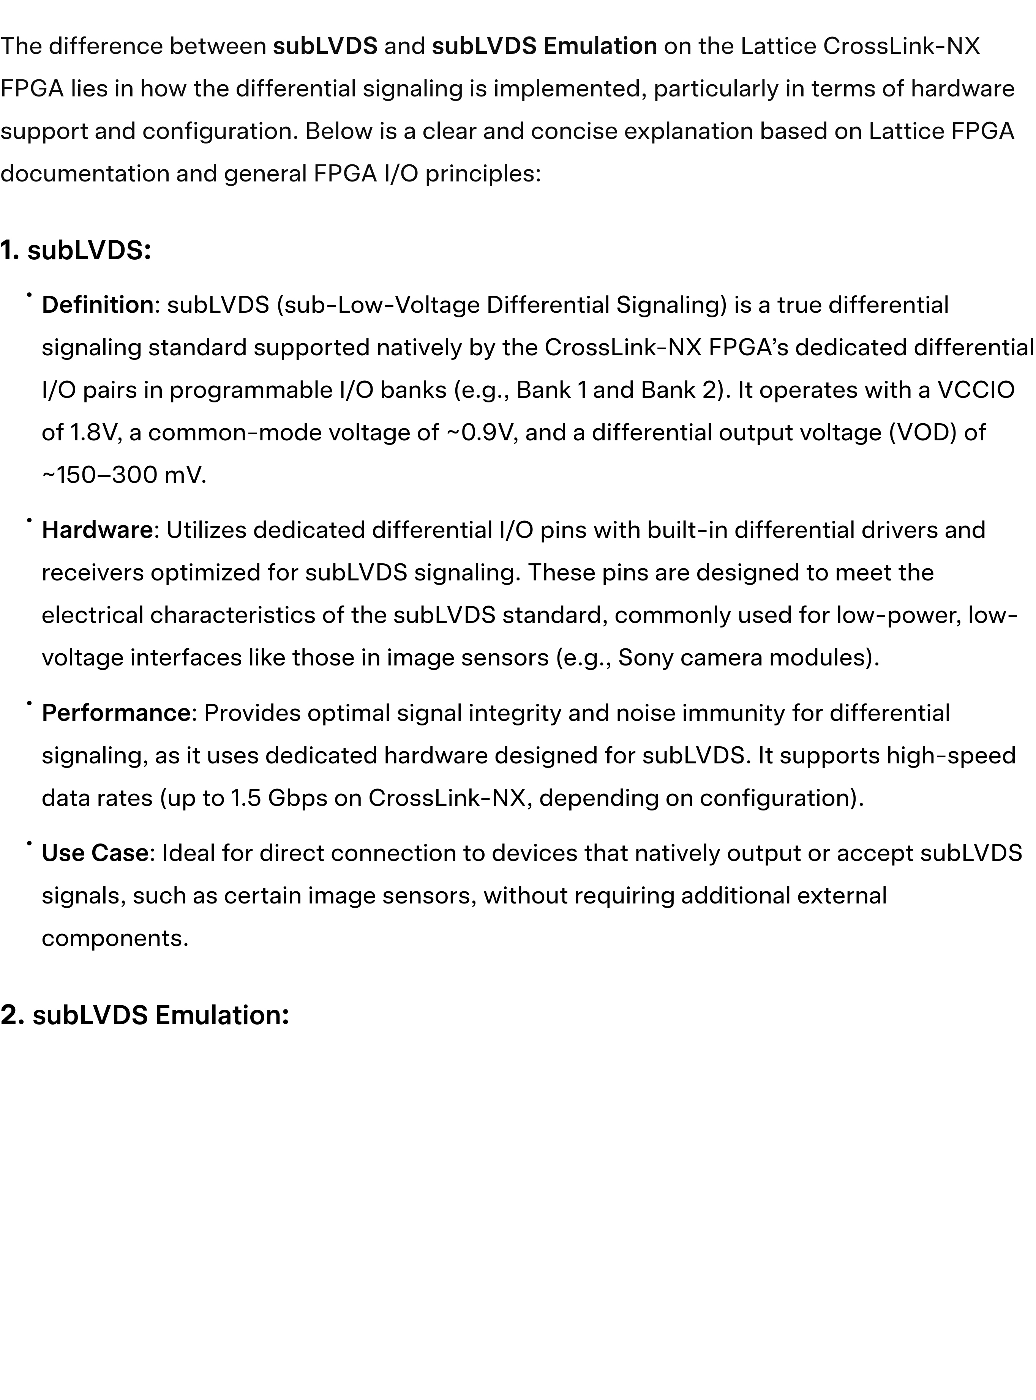
[picture p54: page 1]
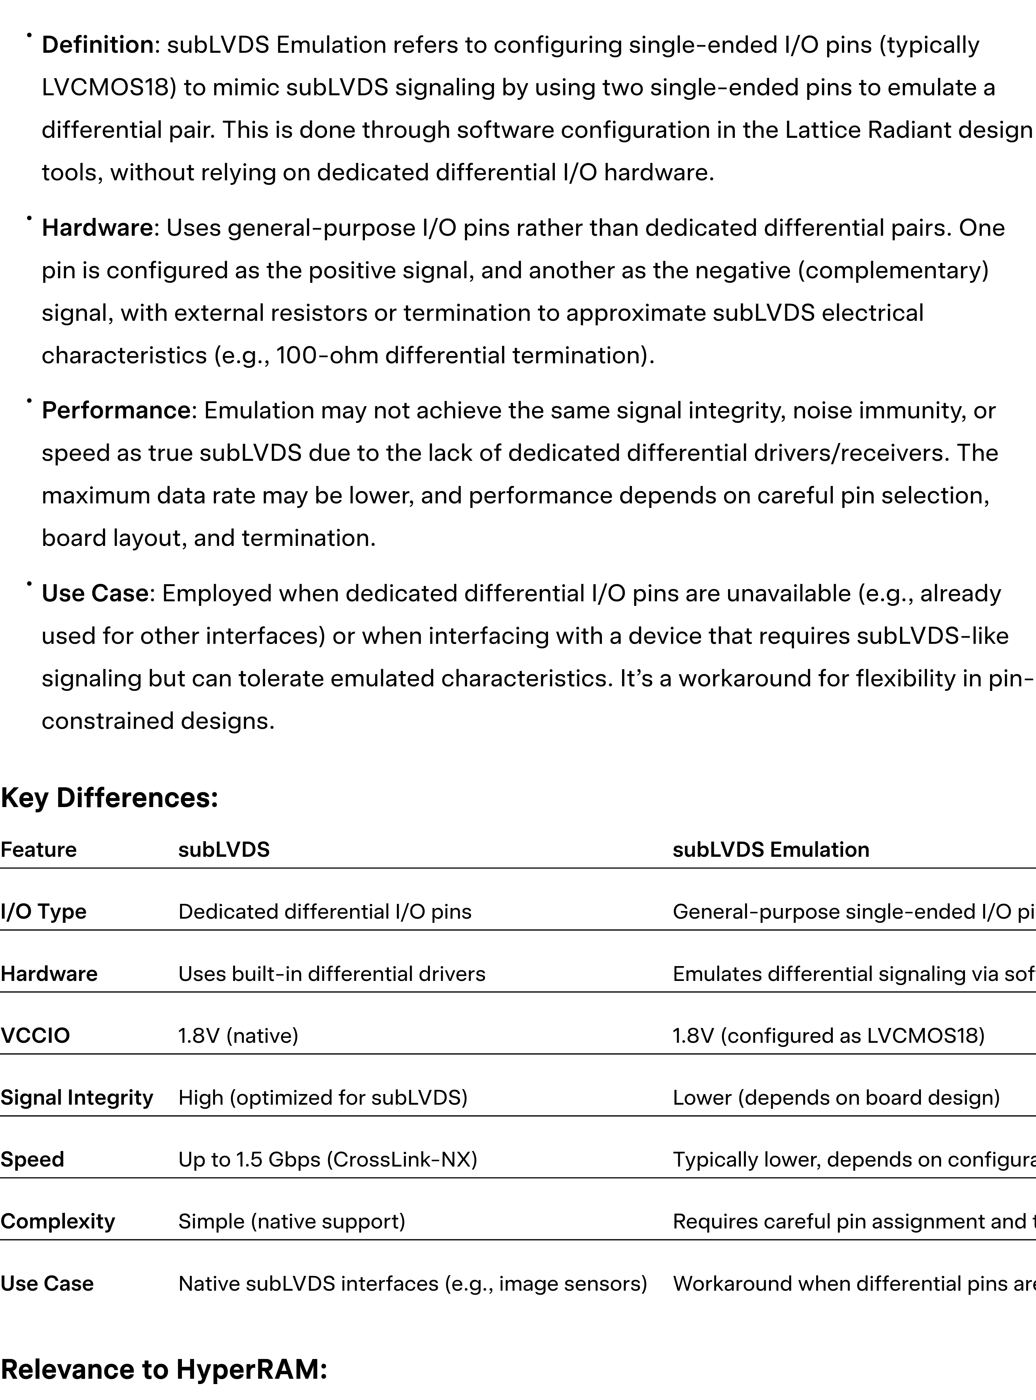
[picture p55: page 2]

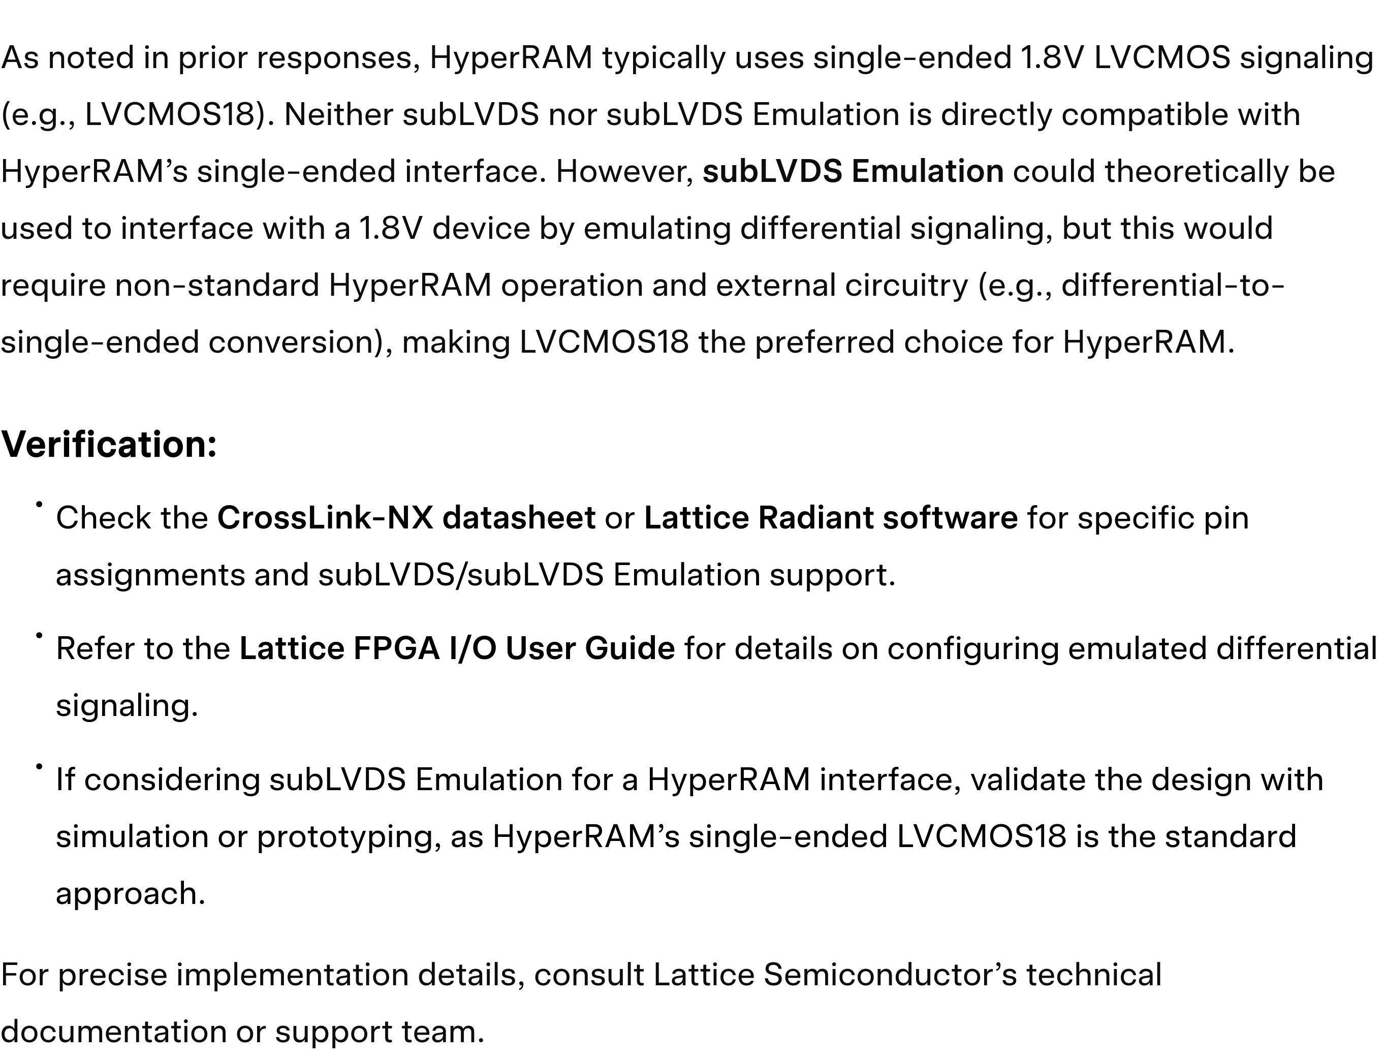
[picture p56: figure]
