ShellAlbert/PoFDualCAM/1-POF-PSU-C2/Debug_Record/CRAM_Programming_Configure/CRAM_Programming.png

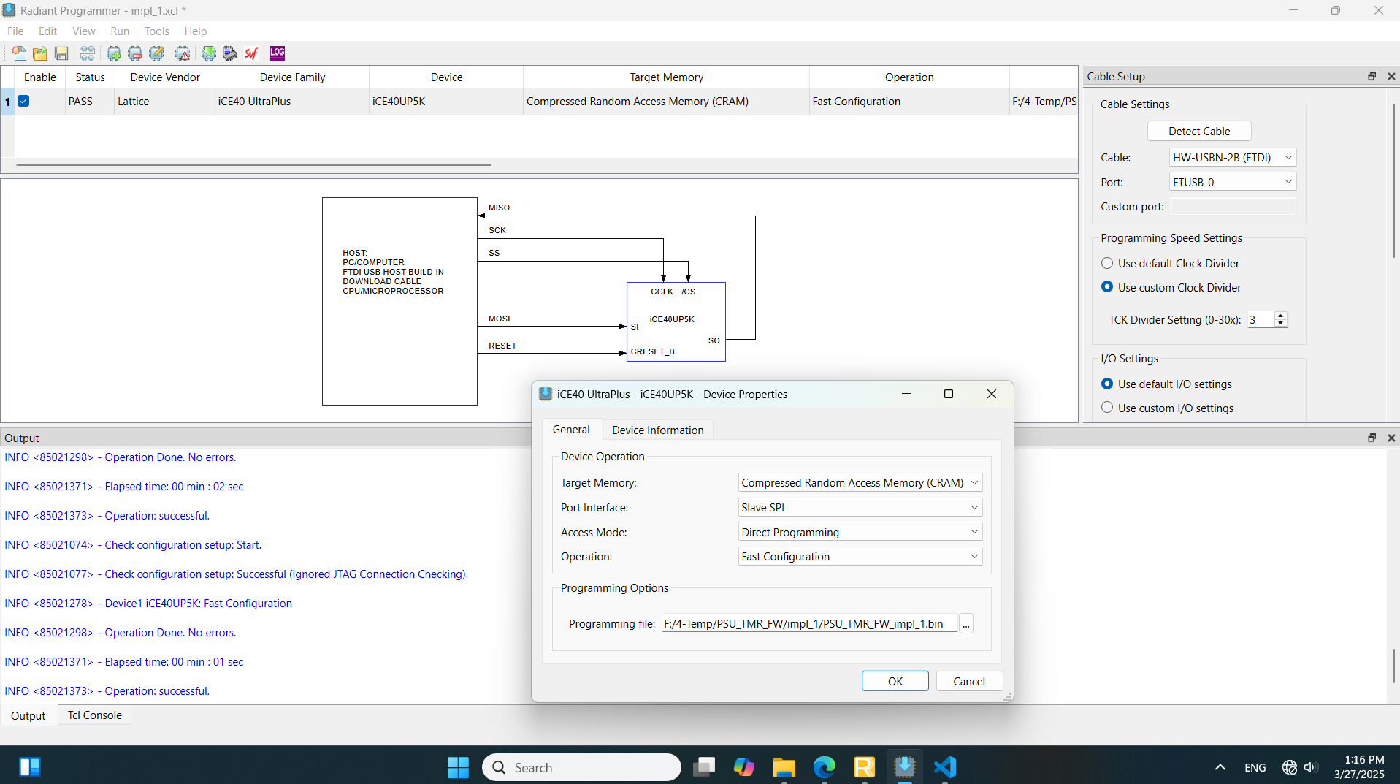
1-POF-PSU-C2/Debug_Record/CRAM_Programming_Configure/CRAM_Programming.png
