ShellAlbert/PoFDualCAM/1-POF-PSU-C2/Debug_Record/CRAM_Programming_Configure/IMG_20250327_131534_1.jpg

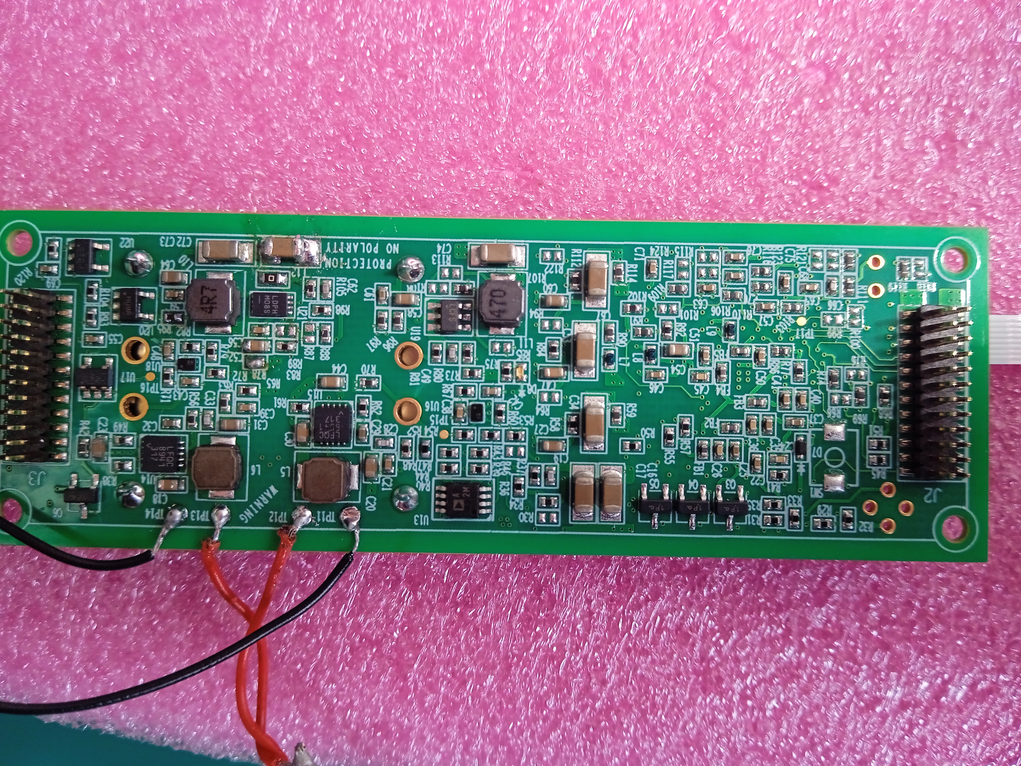
1-POF-PSU-C2/Debug_Record/CRAM_Programming_Configure/IMG_20250327_131534_1.jpg
