ShellAlbert/PoFDualCAM/1-POF-PSU-C2/Debug_Record/CRAM_Programming_Configure/IMG_20250327_132040.jpg

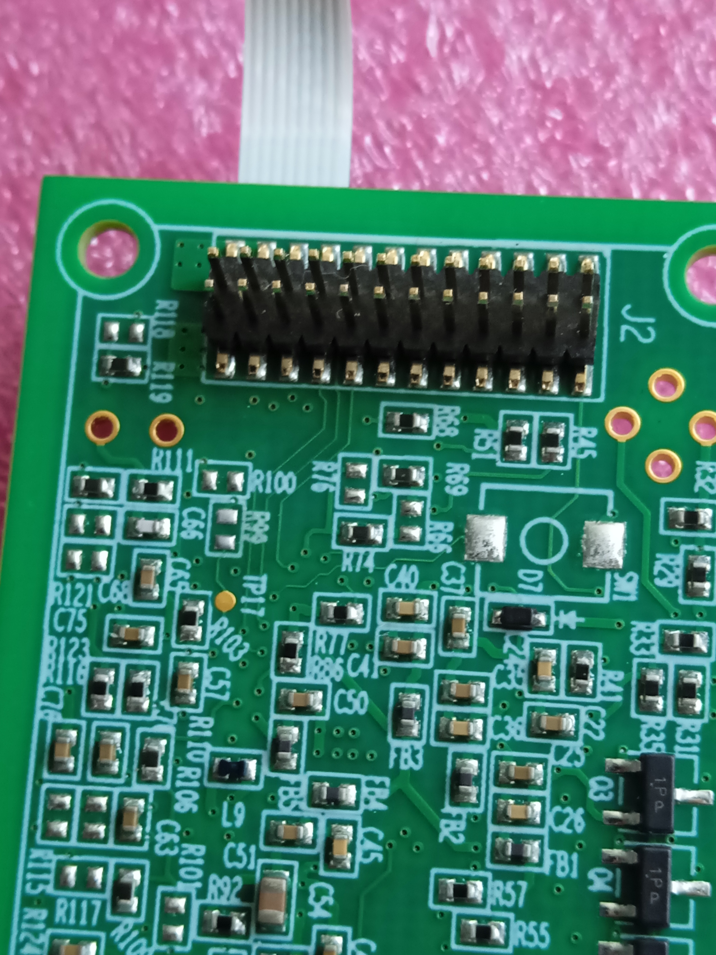
1-POF-PSU-C2/Debug_Record/CRAM_Programming_Configure/IMG_20250327_132040.jpg
