ShellAlbert/PoFDualCAM/1-POF-PSU-C2/Debug_Record/HW_Bug_Fixed/bug-1.png

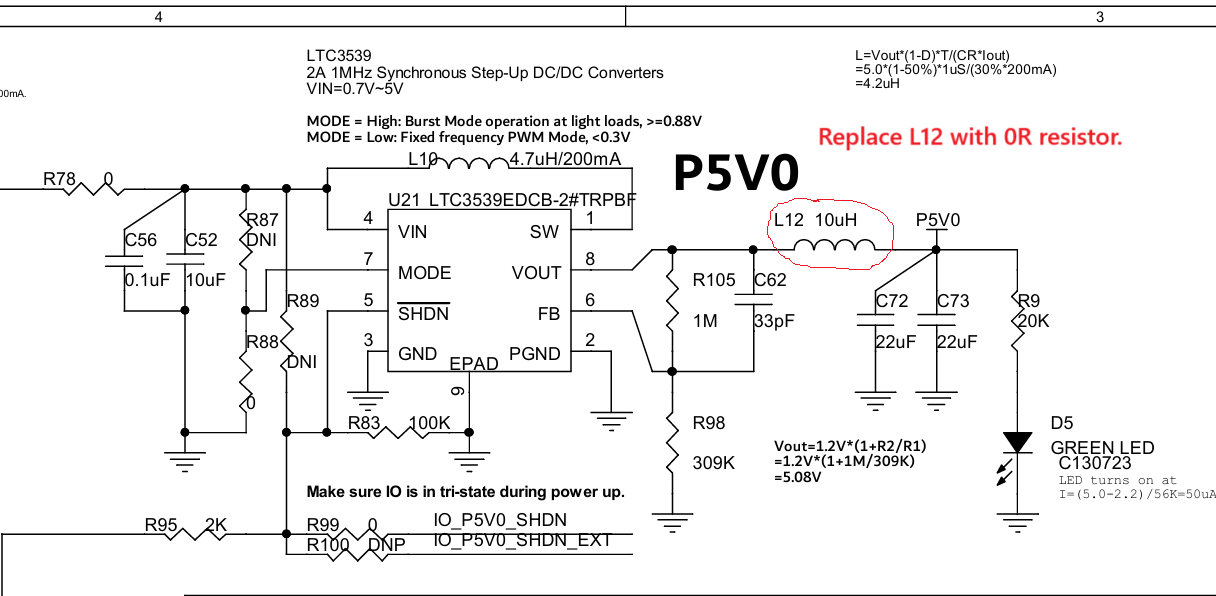
1-POF-PSU-C2/Debug_Record/HW_Bug_Fixed/bug-1.png
