ShellAlbert/PoFDualCAM/1-POF-PSU-C2/Debug_Record/SPI_Programming_Configure/IMG_20250327_142328_1.jpg

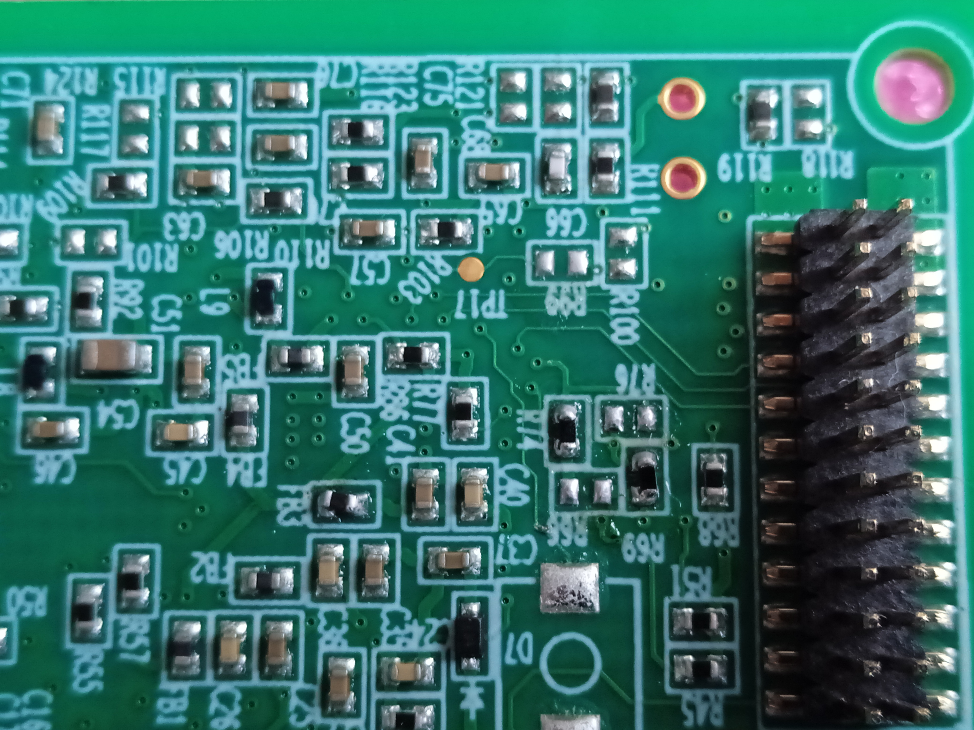
1-POF-PSU-C2/Debug_Record/SPI_Programming_Configure/IMG_20250327_142328_1.jpg
