ShellAlbert/PoFDualCAM/1-POF-PSU-C2/Debug_Record/SPI_Programming_Configure/Screenshot 2025-03-27 141418.png

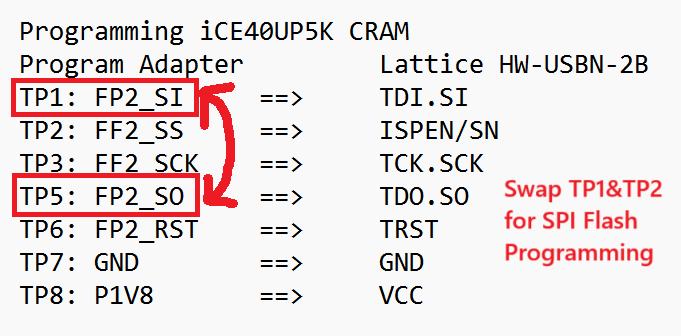
1-POF-PSU-C2/Debug_Record/SPI_Programming_Configure/Screenshot 2025-03-27 141418.png
