ShellAlbert/PoFDualCAM/1-PSU/Debug_Record/4Mbps_Success_4CH_Engineer_Li/IMG_20250507_180742.jpg

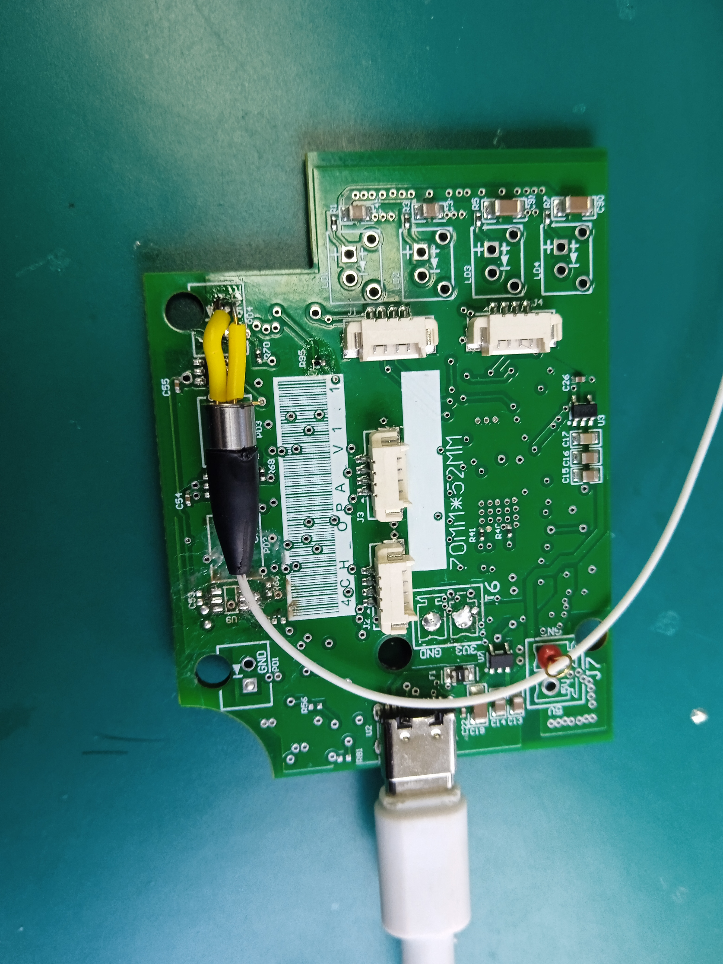
1-PSU/Debug_Record/4Mbps_Success_4CH_Engineer_Li/IMG_20250507_180742.jpg
