ShellAlbert/PoFDualCAM/1-PSU/Debug_Record/4Mbps_Success_4CH_Engineer_Li/Screenshot 2025-05-07 180137.png

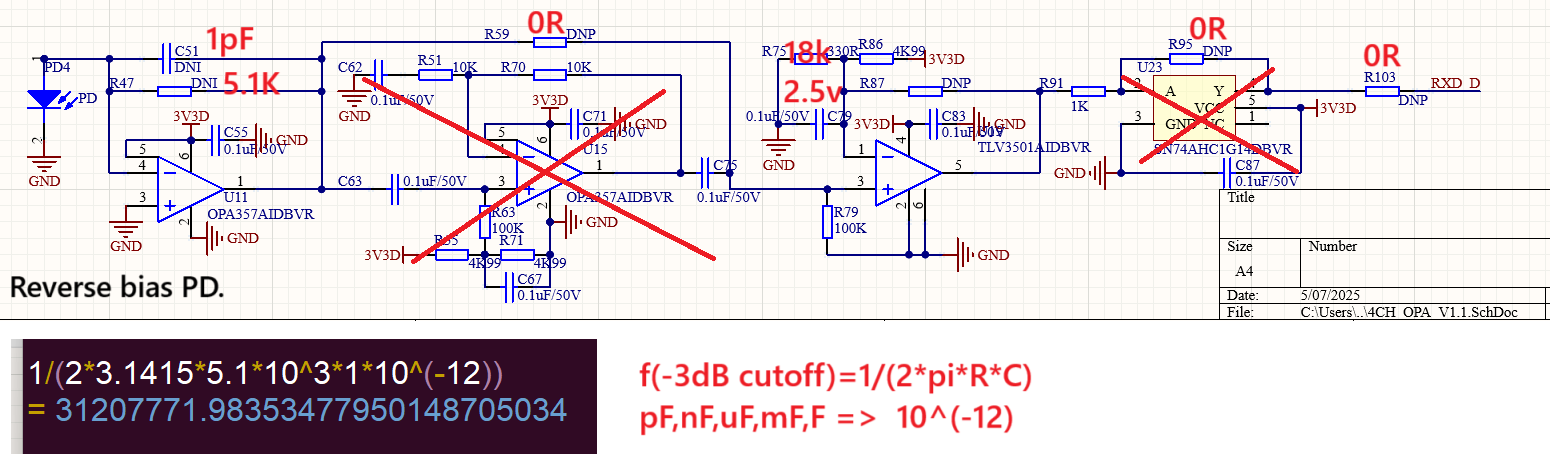
1-PSU/Debug_Record/4Mbps_Success_4CH_Engineer_Li/Screenshot 2025-05-07 180137.png
