ShellAlbert/PoFDualCAM/1-PSU/Debug_Record/ECL_Tx_4Mbps_Success/IMG_20250429_140056.jpg

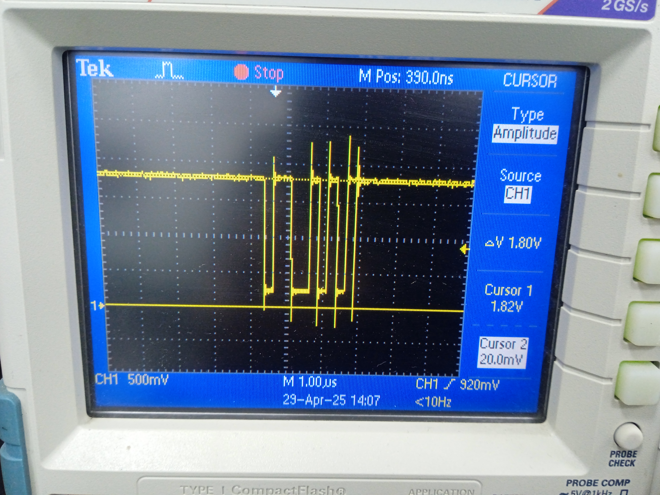
1-PSU/Debug_Record/ECL_Tx_4Mbps_Success/IMG_20250429_140056.jpg
