ShellAlbert/PoFDualCAM/1-PSU/Debug_Record/ECL_Tx_4Mbps_Success/IMG_20250430_110924_1.jpg

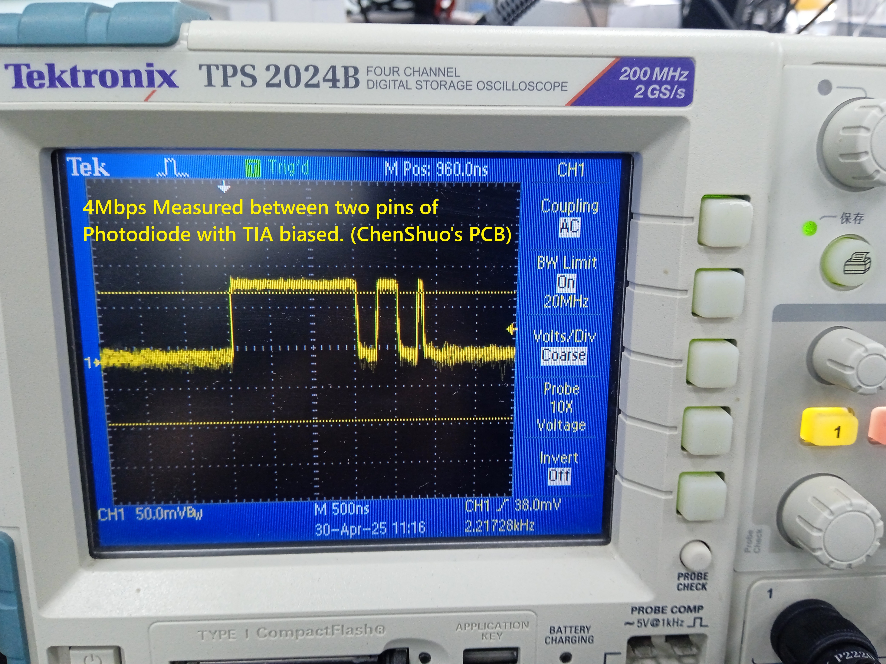
1-PSU/Debug_Record/ECL_Tx_4Mbps_Success/IMG_20250430_110924_1.jpg
