ShellAlbert/PoFDualCAM/1-PSU/Debug_Record/ECL_Tx_4Mbps_Success/PSU_UART_TXD.jpg

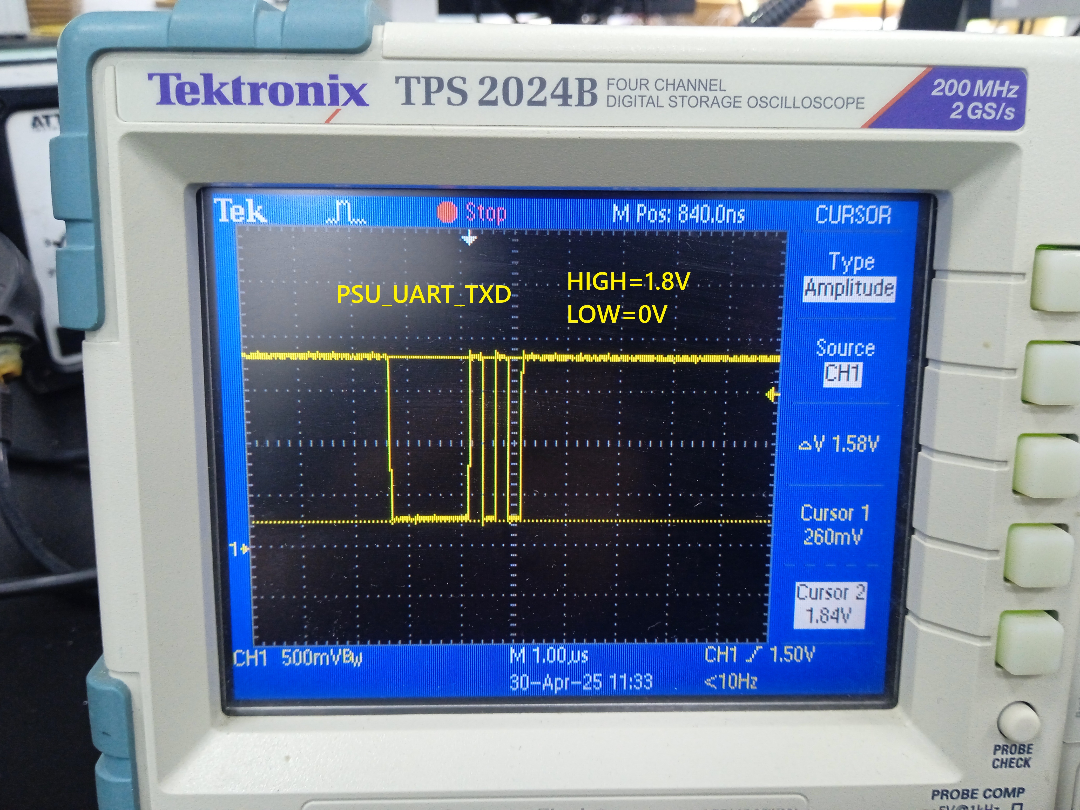
1-PSU/Debug_Record/ECL_Tx_4Mbps_Success/PSU_UART_TXD.jpg
