ShellAlbert/PoFDualCAM/1-PSU/Debug_Record/ECL_Tx_4Mbps_Success/Q1_Vb1.jpg

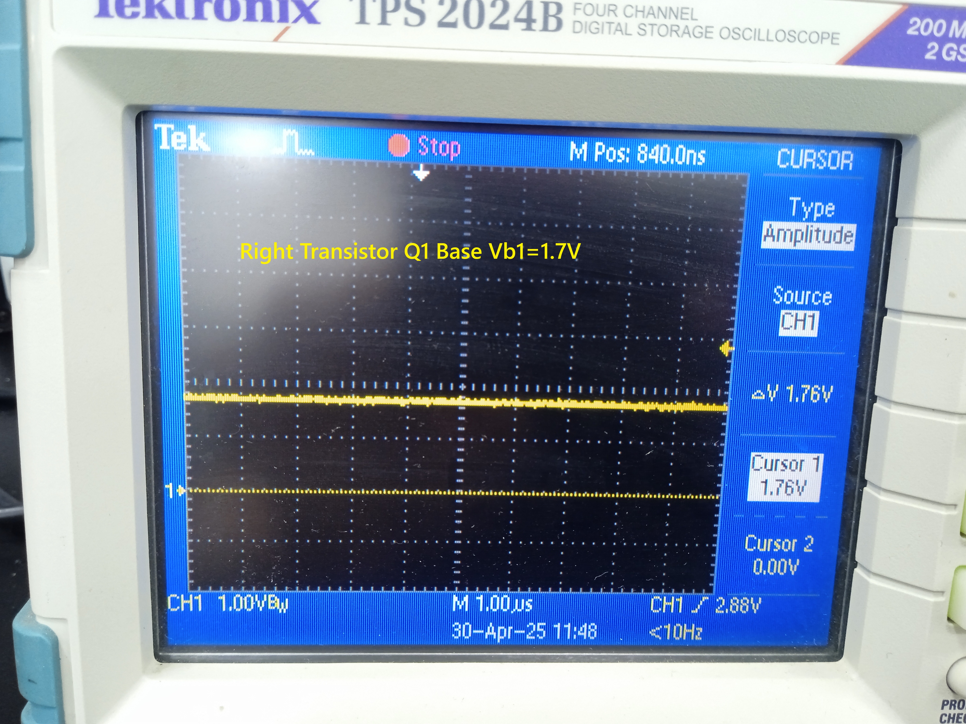
1-PSU/Debug_Record/ECL_Tx_4Mbps_Success/Q1_Vb1.jpg
