ShellAlbert/PoFDualCAM/1-PSU/Debug_Record/ECL_Tx_4Mbps_Success/Q2_Vc_DC.jpg

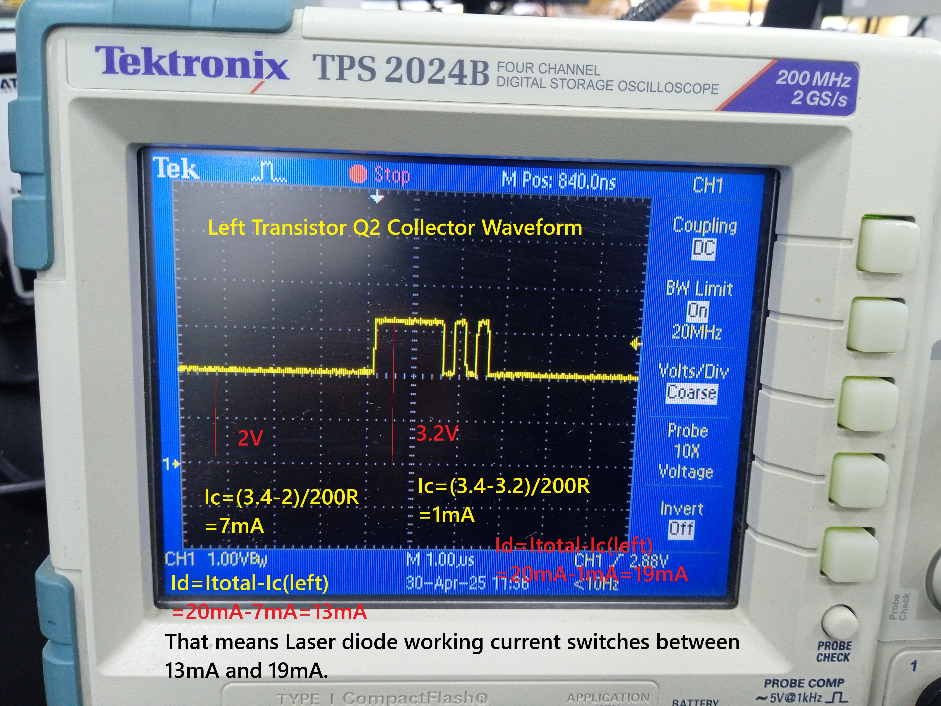
1-PSU/Debug_Record/ECL_Tx_4Mbps_Success/Q2_Vc_DC.jpg
