ShellAlbert/PoFDualCAM/1-PSU/Debug_Record/ECL_Tx_4Mbps_Success/Screenshot 2025-04-30 113334.png

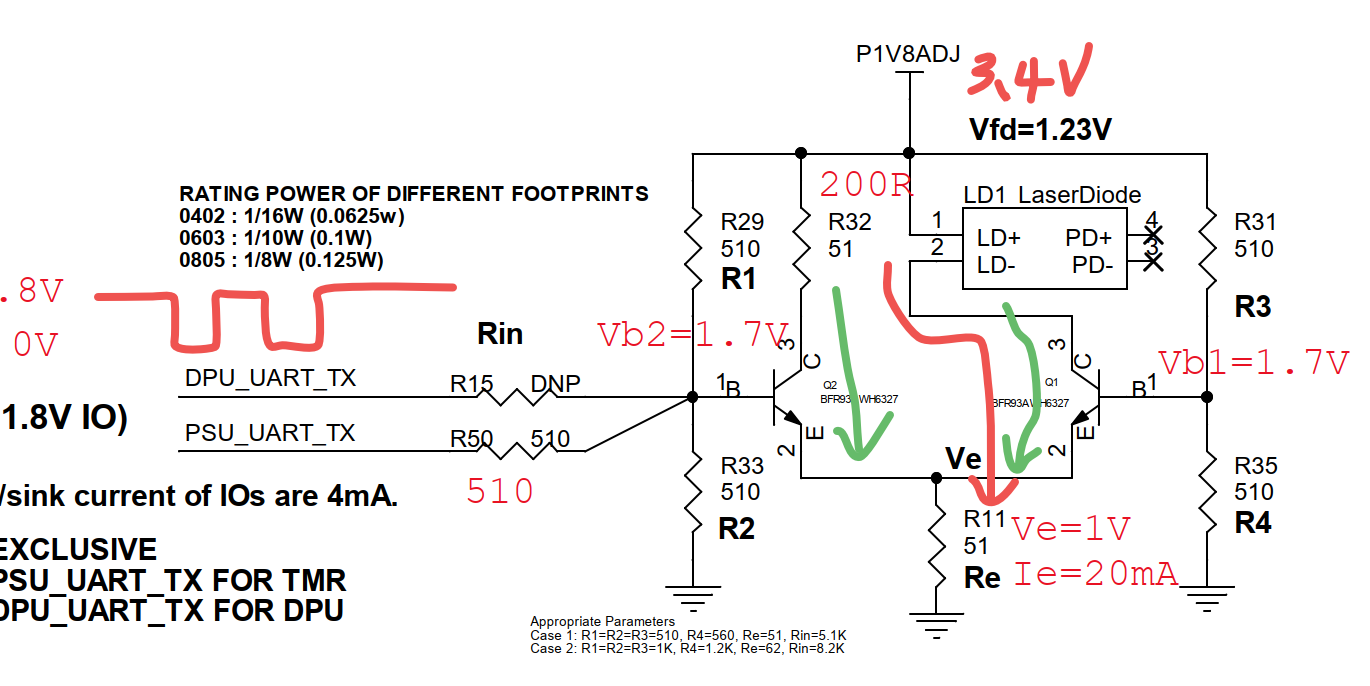
1-PSU/Debug_Record/ECL_Tx_4Mbps_Success/Screenshot 2025-04-30 113334.png
