ShellAlbert/PoFDualCAM/1-PSU/Debug_Record/ECL_Tx_4Mbps_Success/Ve_AC.jpg

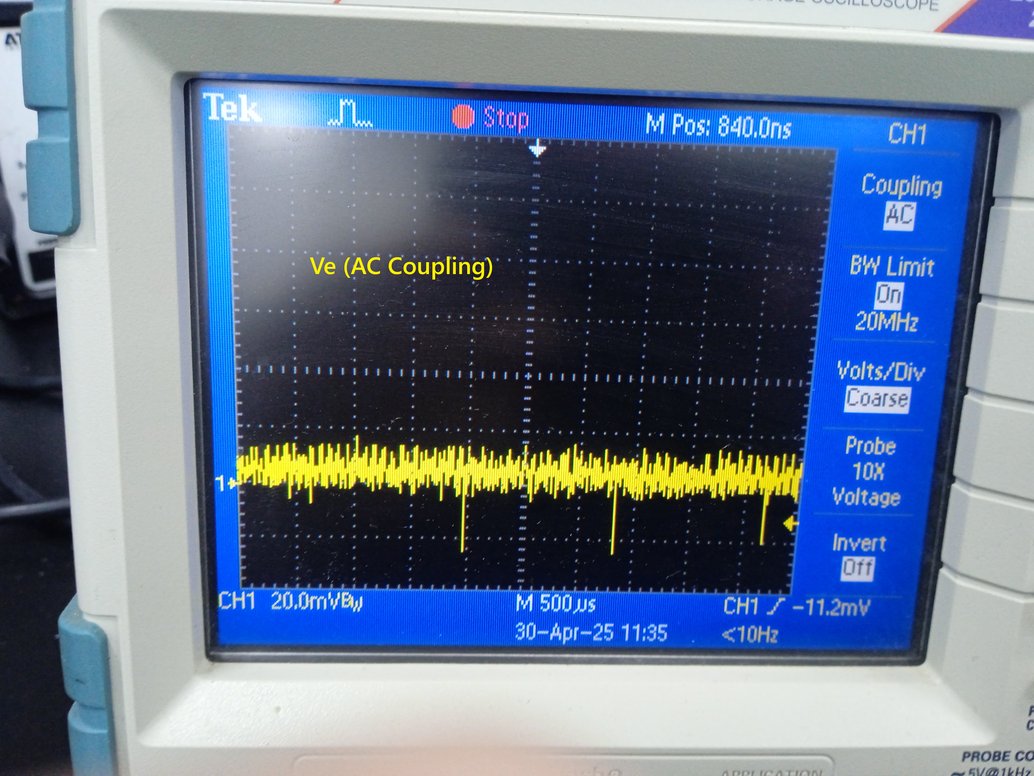
1-PSU/Debug_Record/ECL_Tx_4Mbps_Success/Ve_AC.jpg
