ShellAlbert/PoFDualCAM/2-DPU_HyperRAM_Version/Debug_Documents/Radiant_LVDS.png

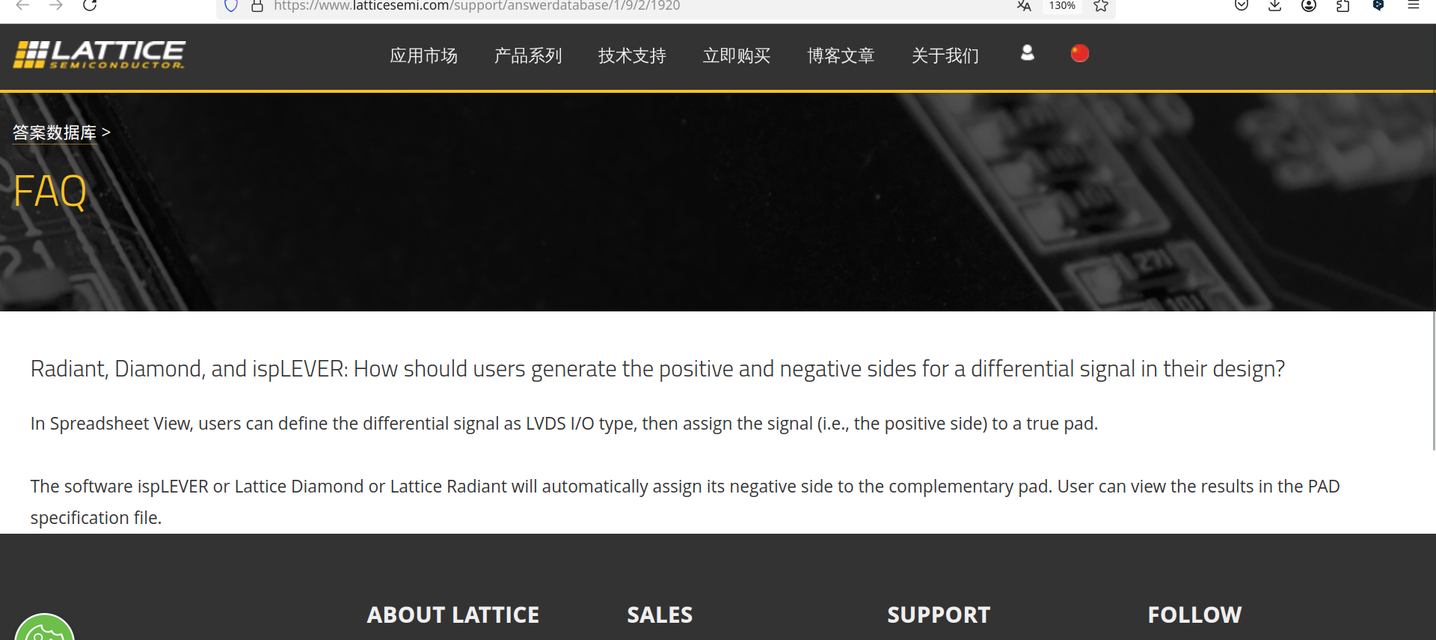
2-DPU_HyperRAM_Version/Debug_Documents/Radiant_LVDS.png
