ShellAlbert/PoFDualCAM/2-DPU_HyperRAM_Version/Debug_Documents/Screenshot_20250626_220256.png

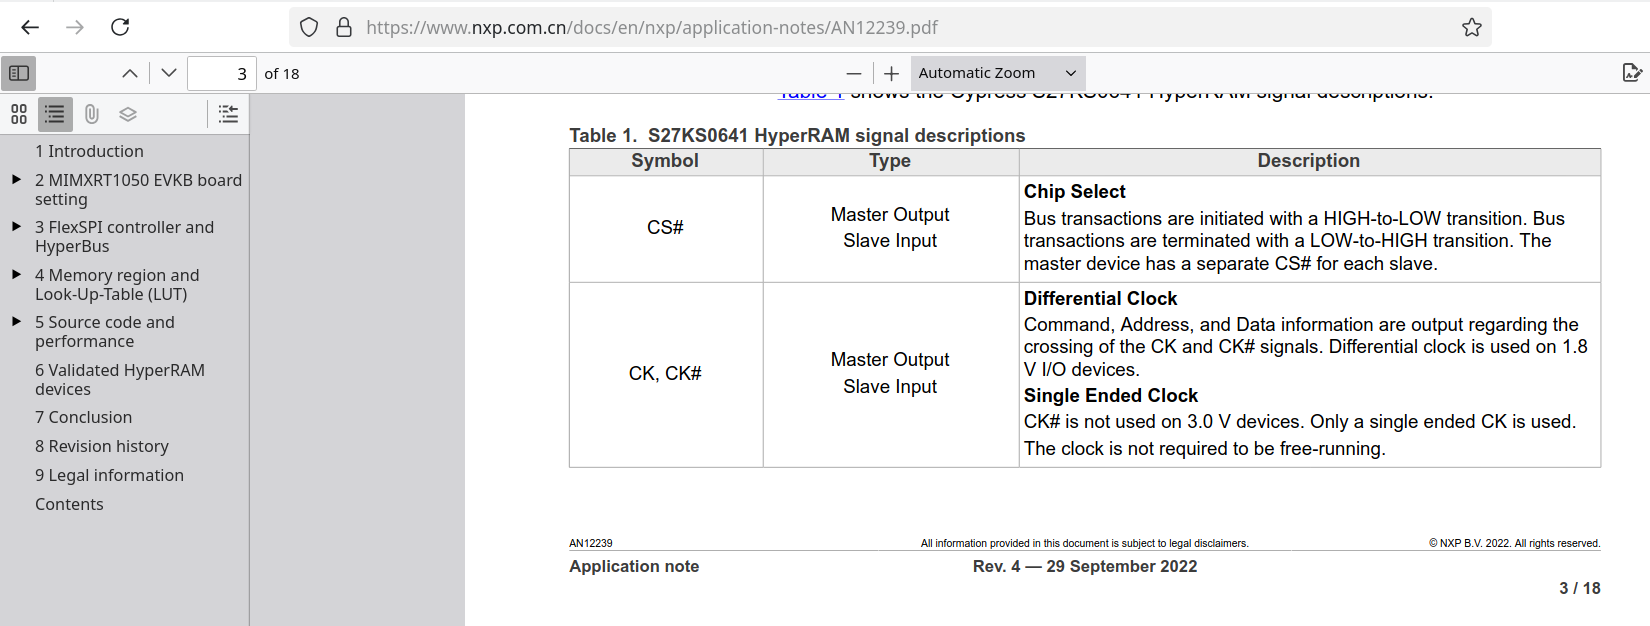
2-DPU_HyperRAM_Version/Debug_Documents/Screenshot_20250626_220256.png
