ShellAlbert/PoFDualCAM/LIFCL-40-7BG256I_REF_Documents/Reference_Schematic/FPGA_Core_FX3_schematic.pdf

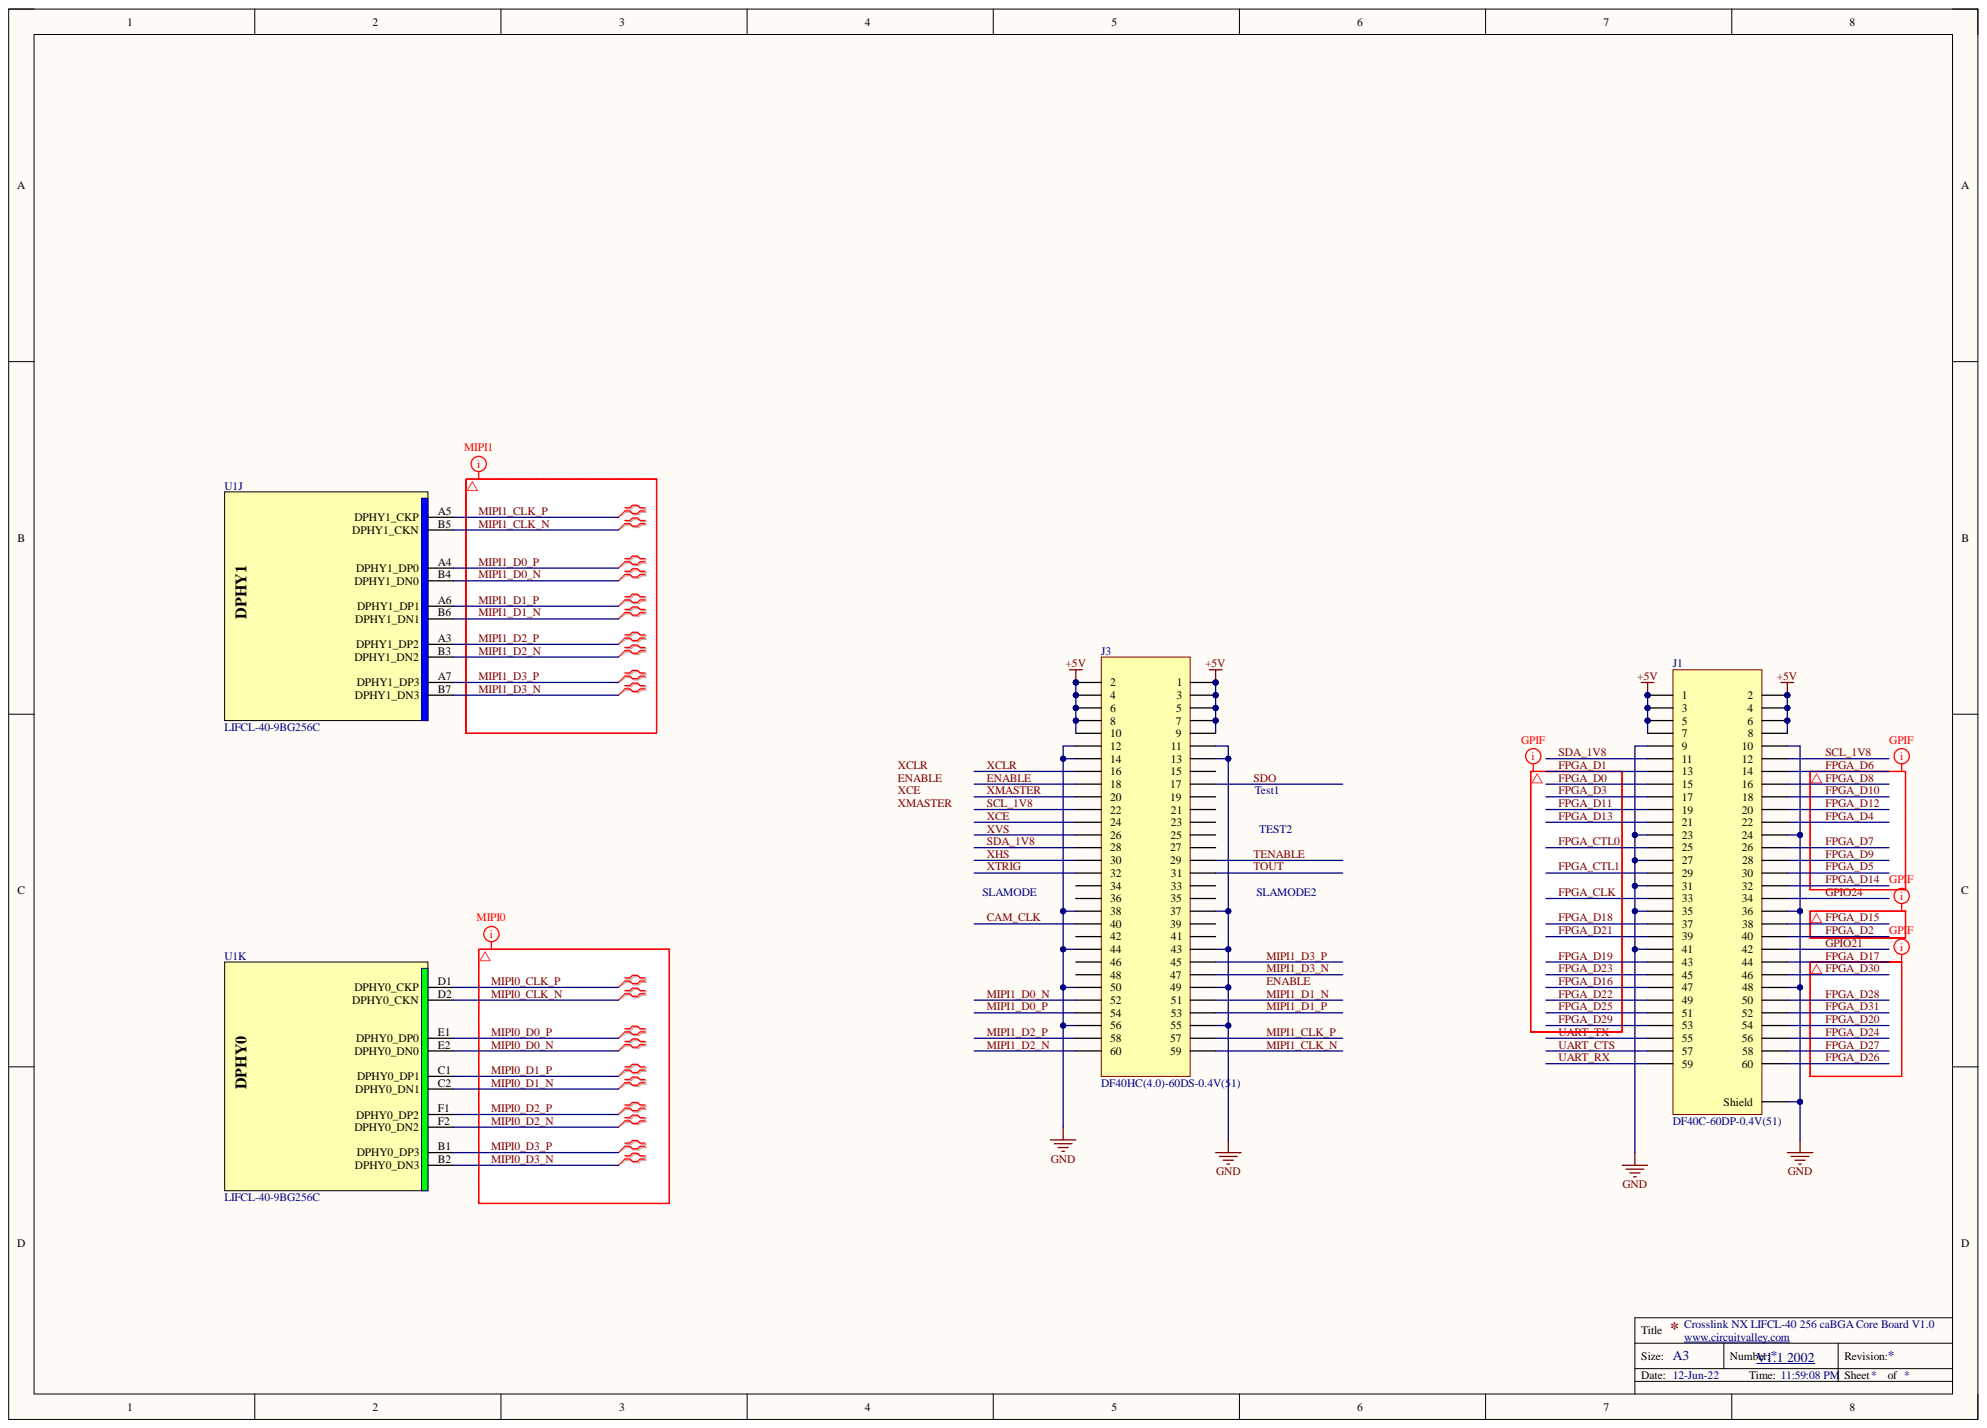
[picture p93: page 1]

Si ze: A | Number: V 1.1 2 | Rev isi on:

Date: 12-Jun-22 T i me: 11:59:08 PM | | Shee t * o f

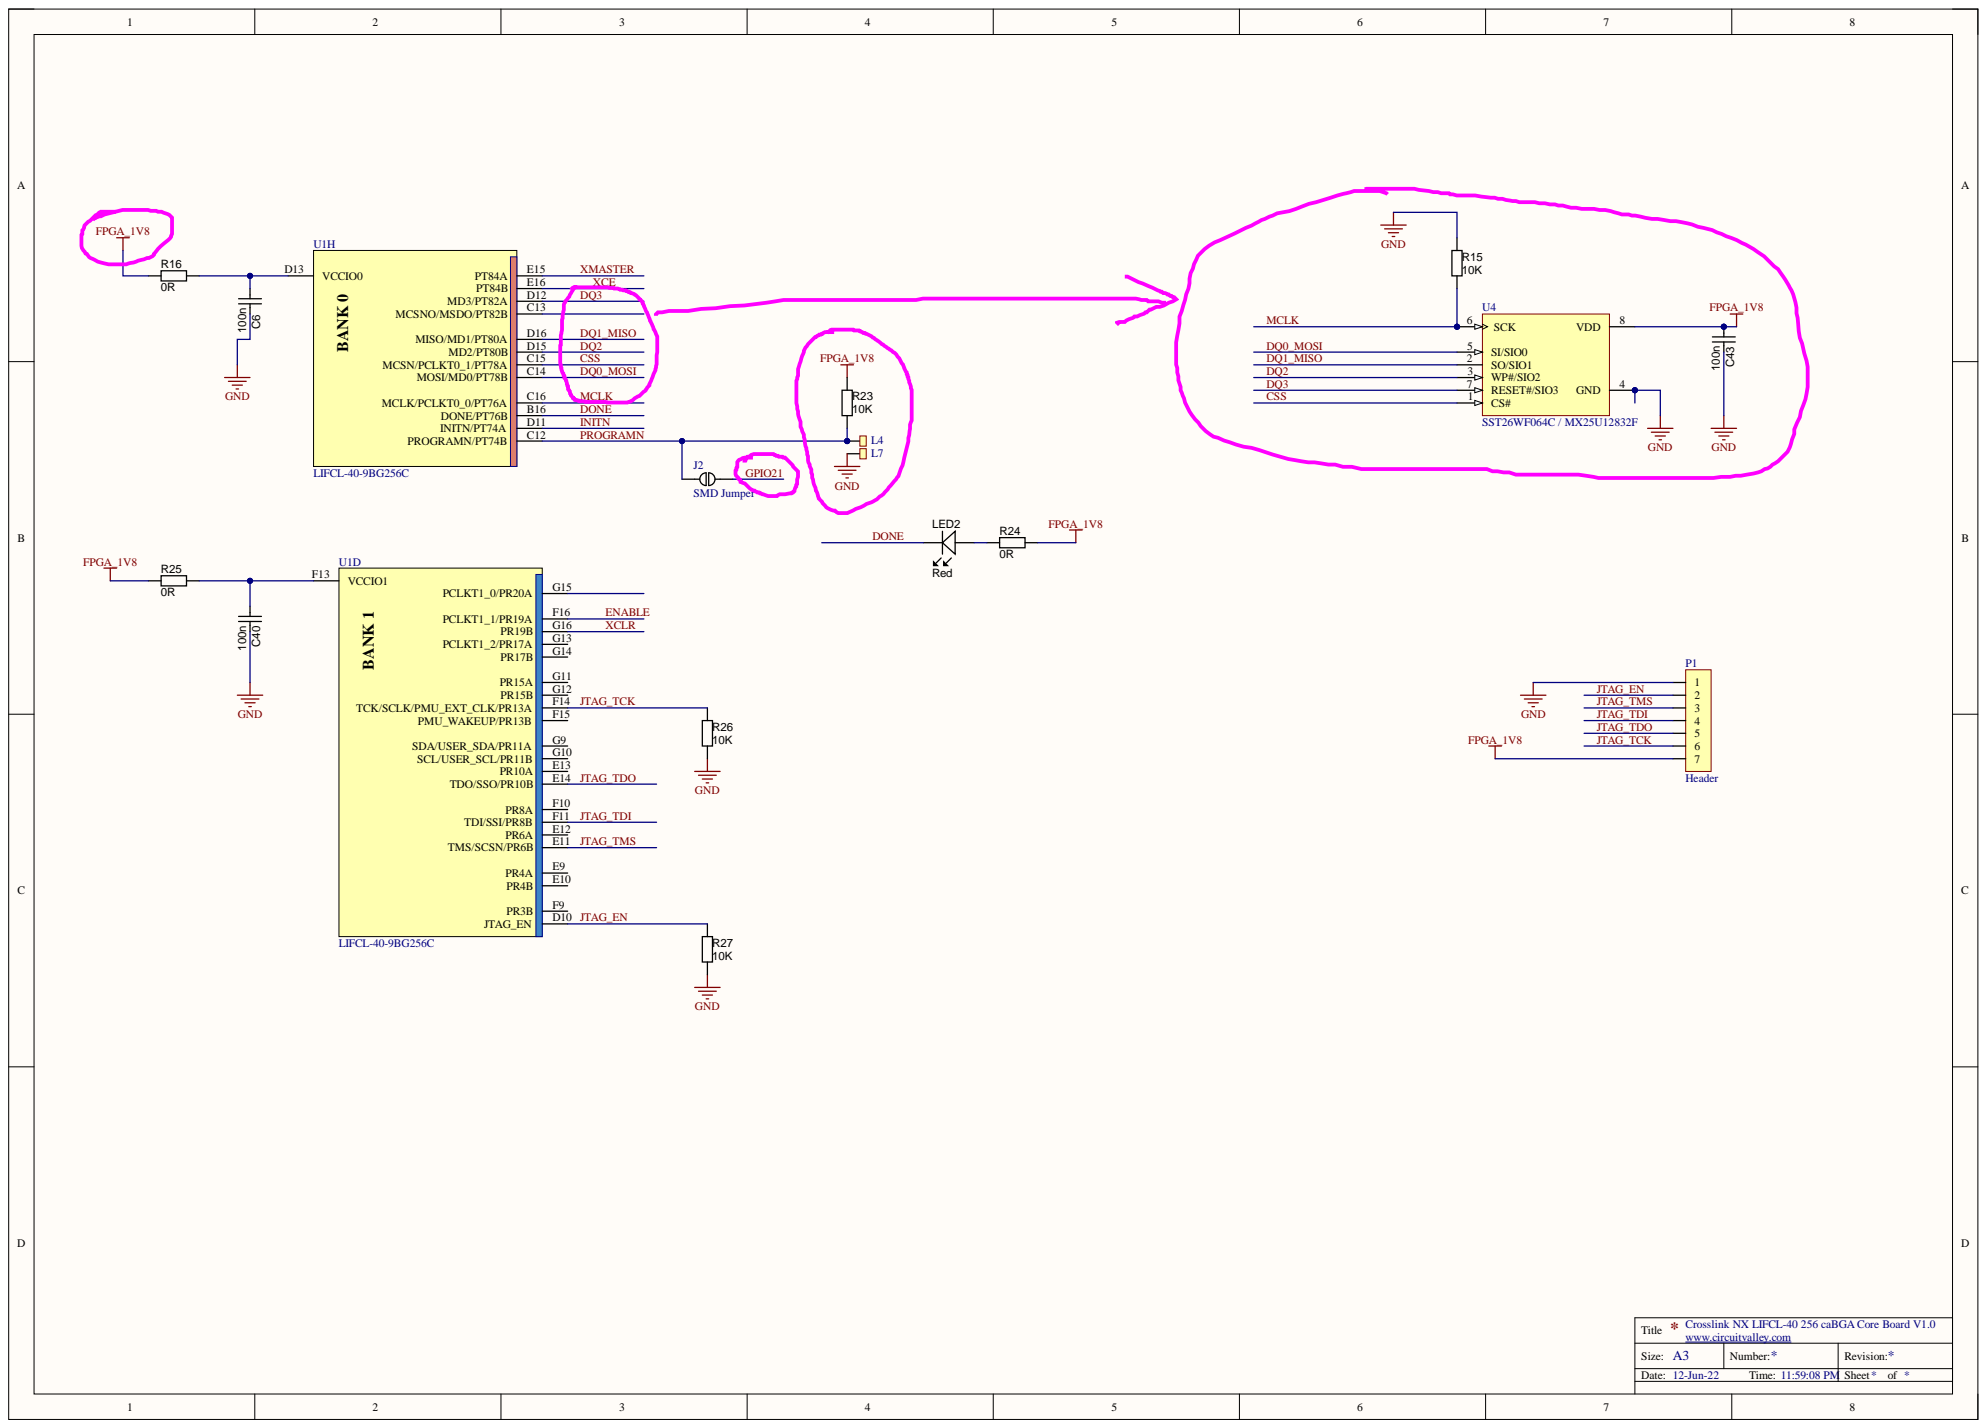
[picture p94: page 2]

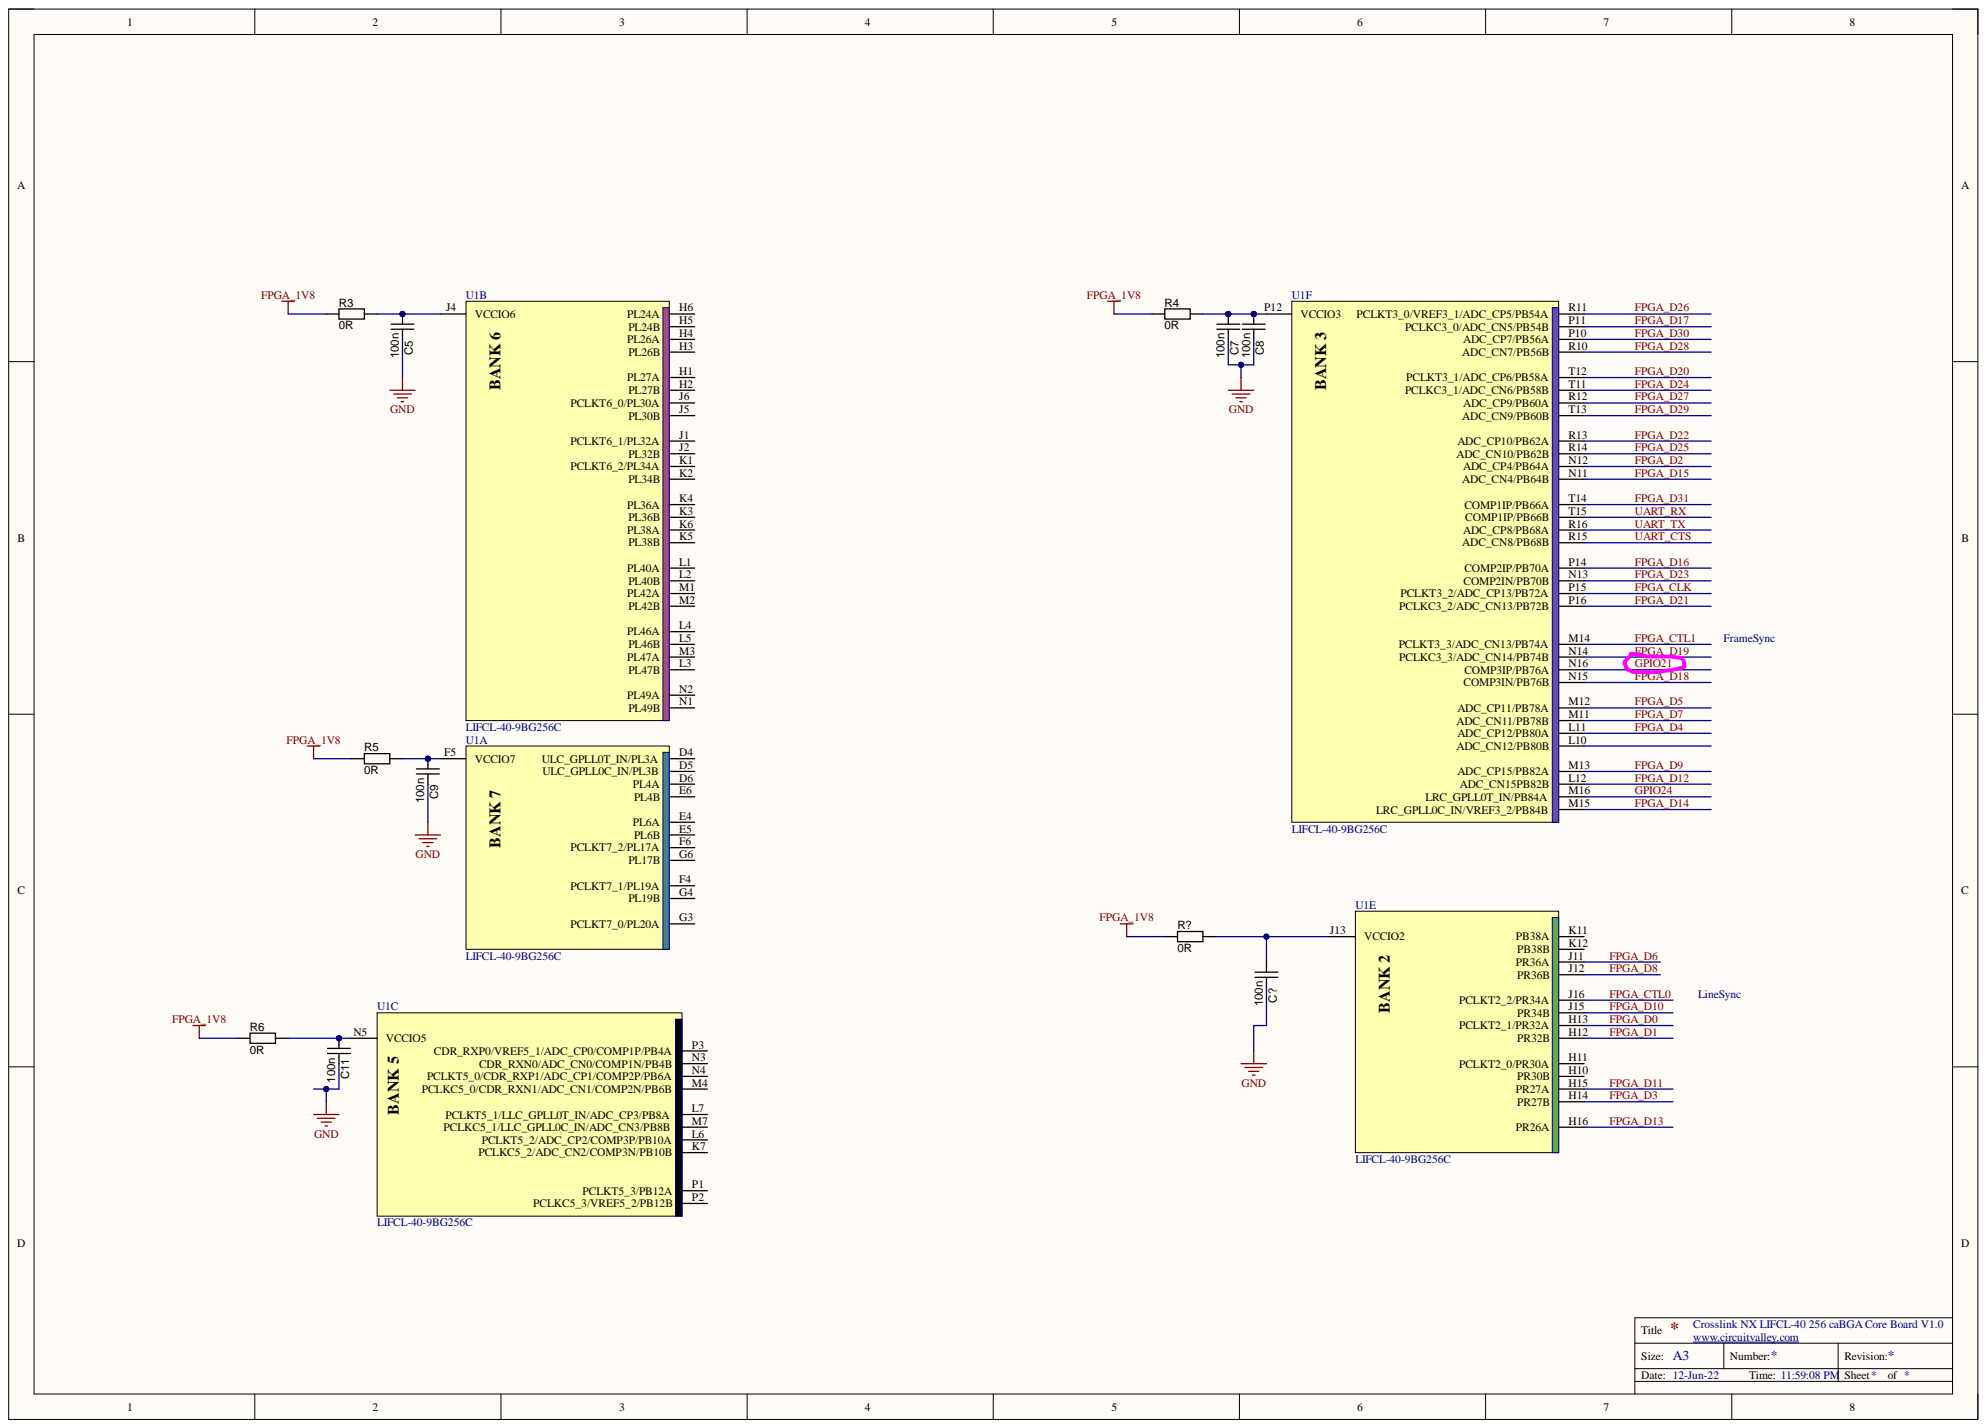
[picture p95: page 3]

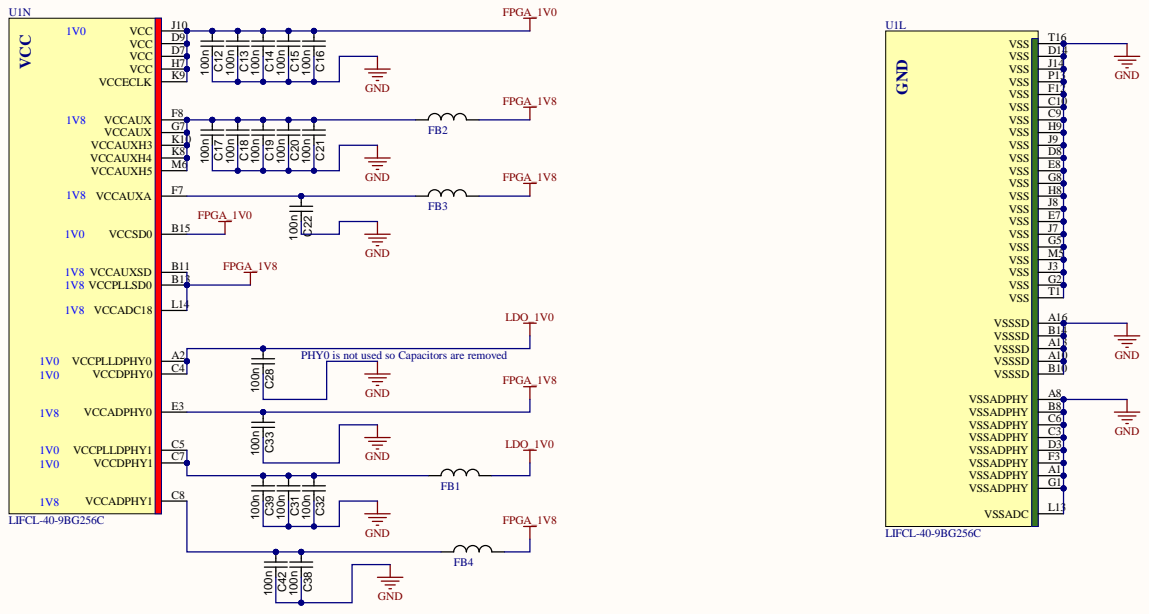
[picture p96: page 4]

PHY0 is not used so Capacitors are removed

Crosslink NX LIFCL-40 256 caBGA Core Board V1.0
Title

Size: A3 | Number: * | Revision: *

12-Jun-22 Time: 11:59:08 PM | | Sheet * of *

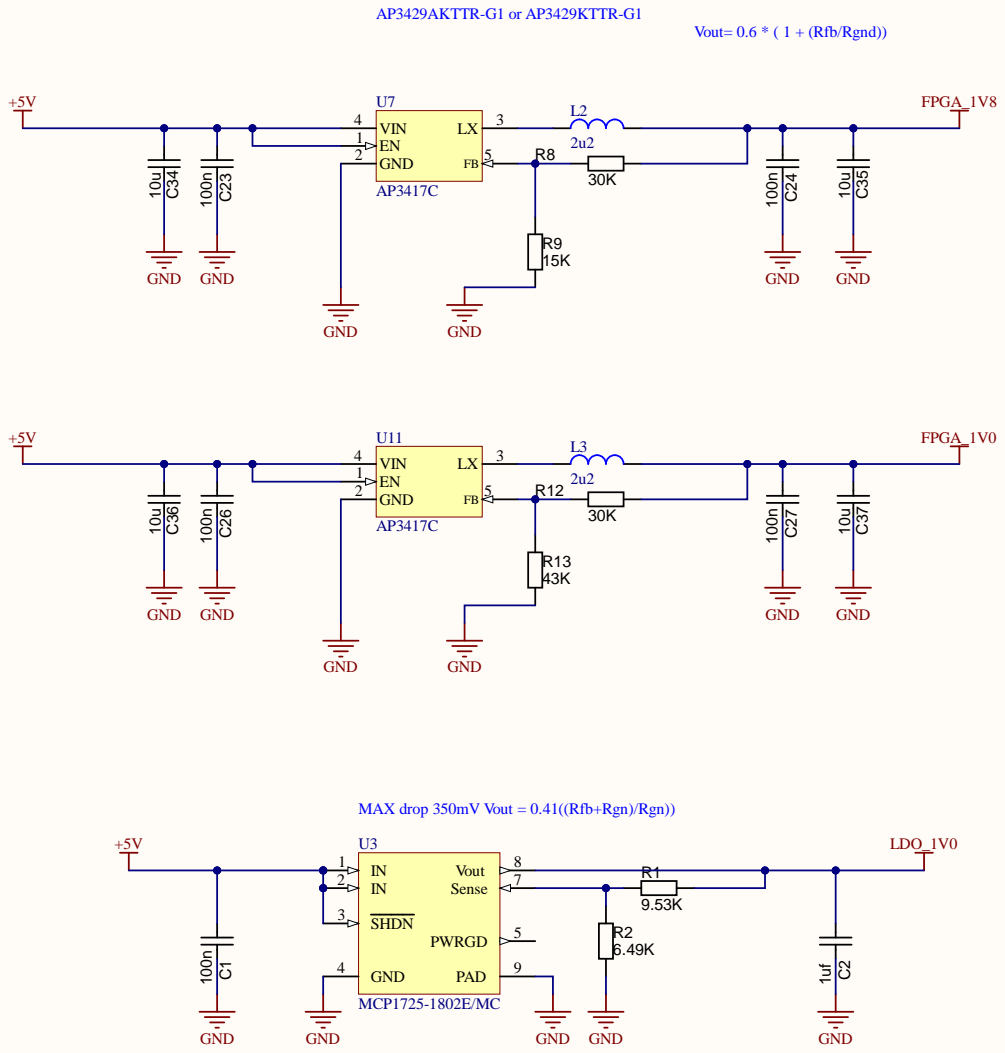
[picture p97: page 5]

MAX drop 350mV Vout = 0.41((Rfb+Rgn)/Rgn))

Crosslink NX LIFCL-40 256 caBGA Core Board V1.0
Title

Size: A3 | Number: * | Revision: *

12-Jun-22 Time: 11:59:08 PM | | Sheet * of *

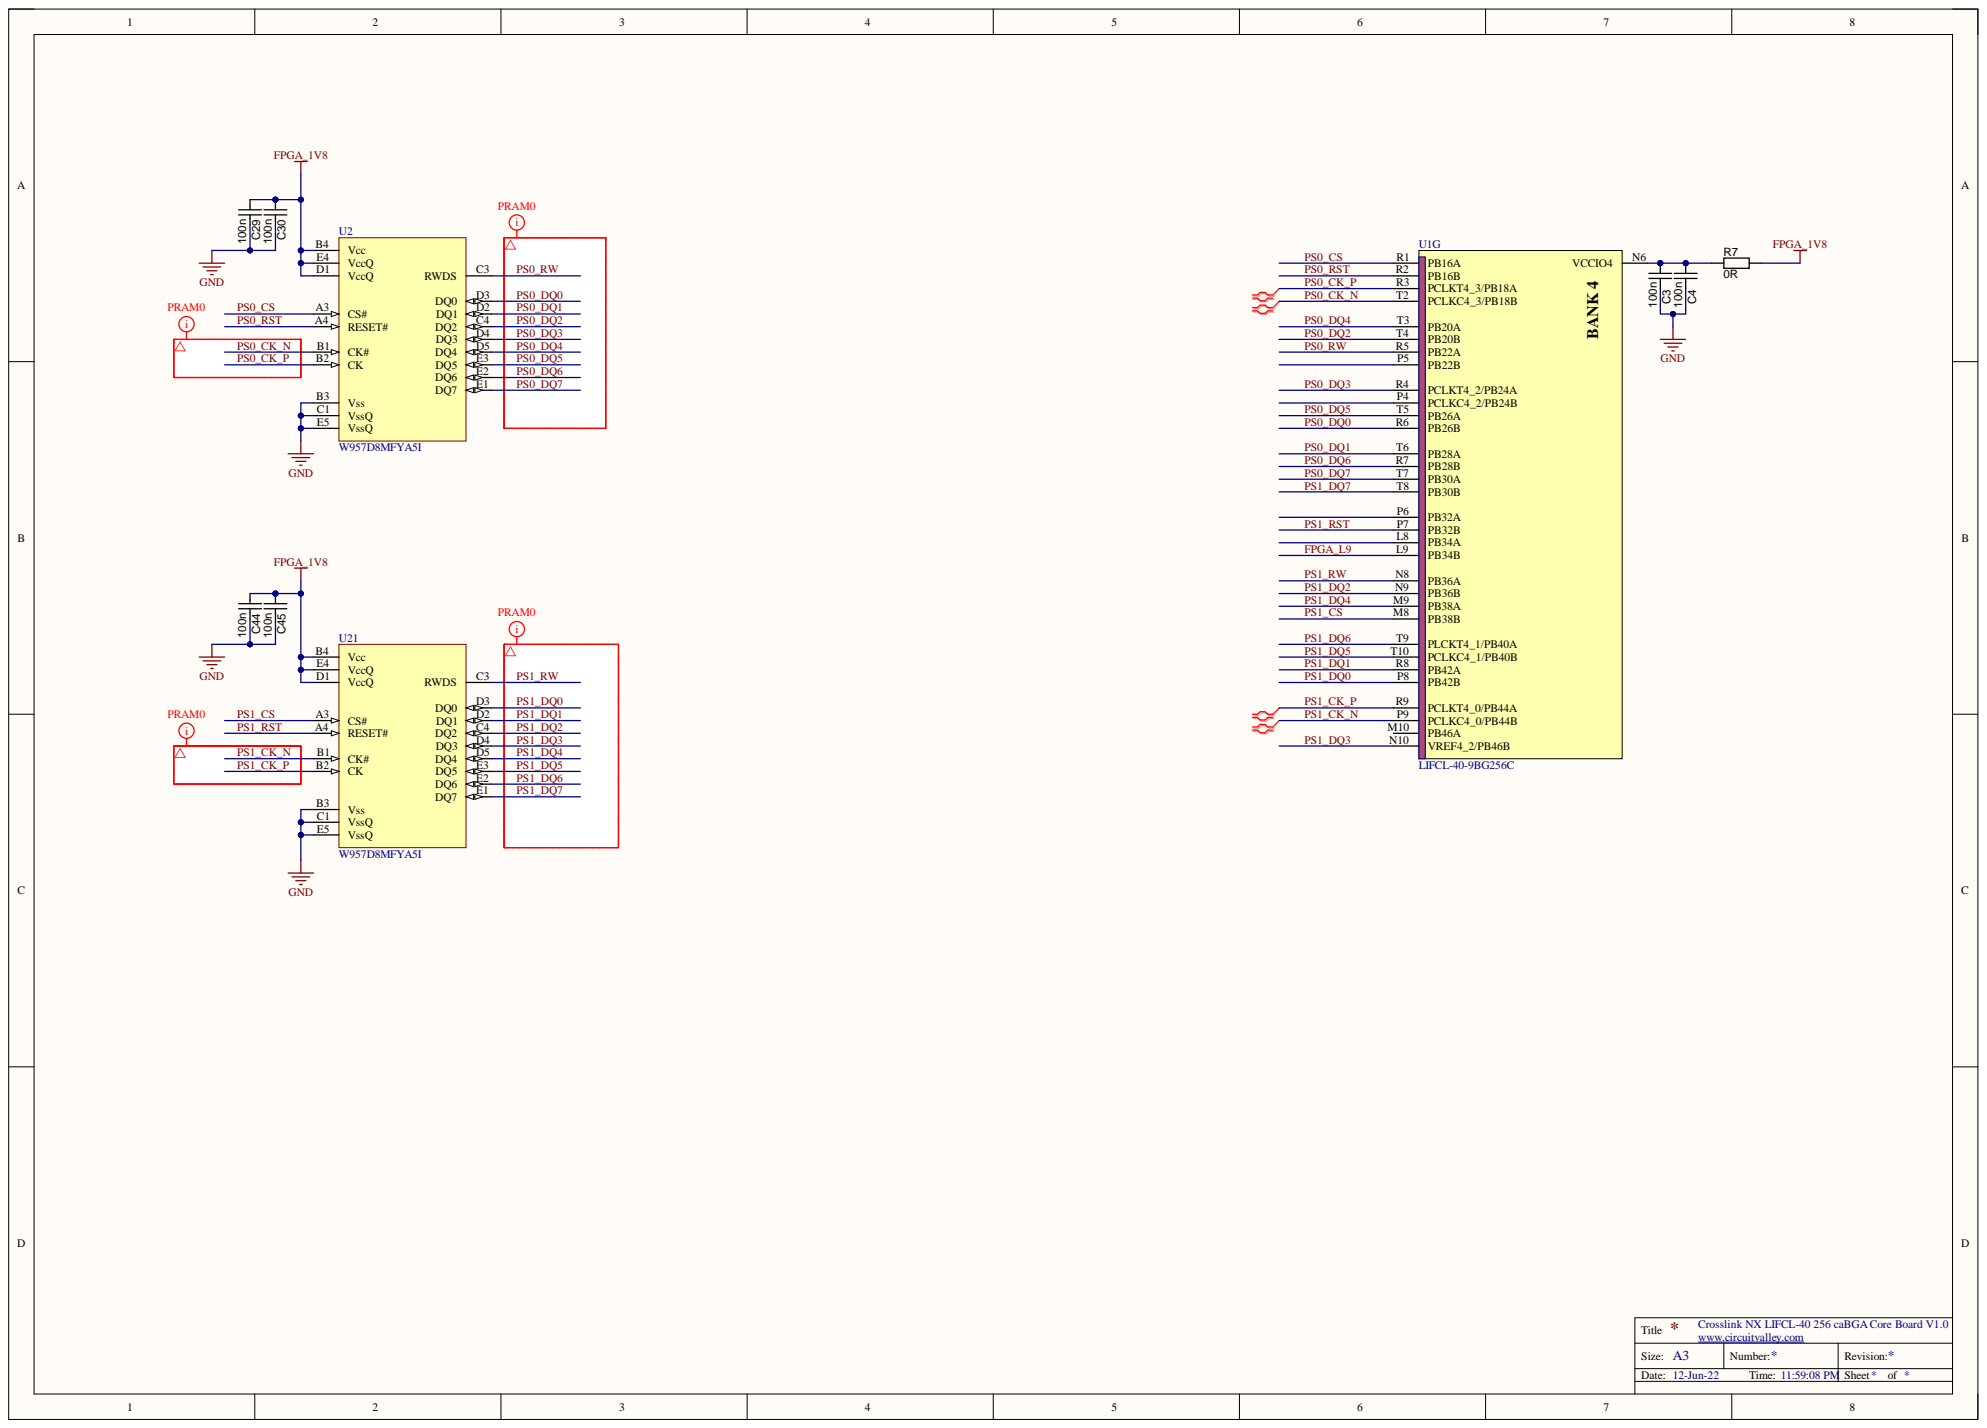
[picture p98: page 6]

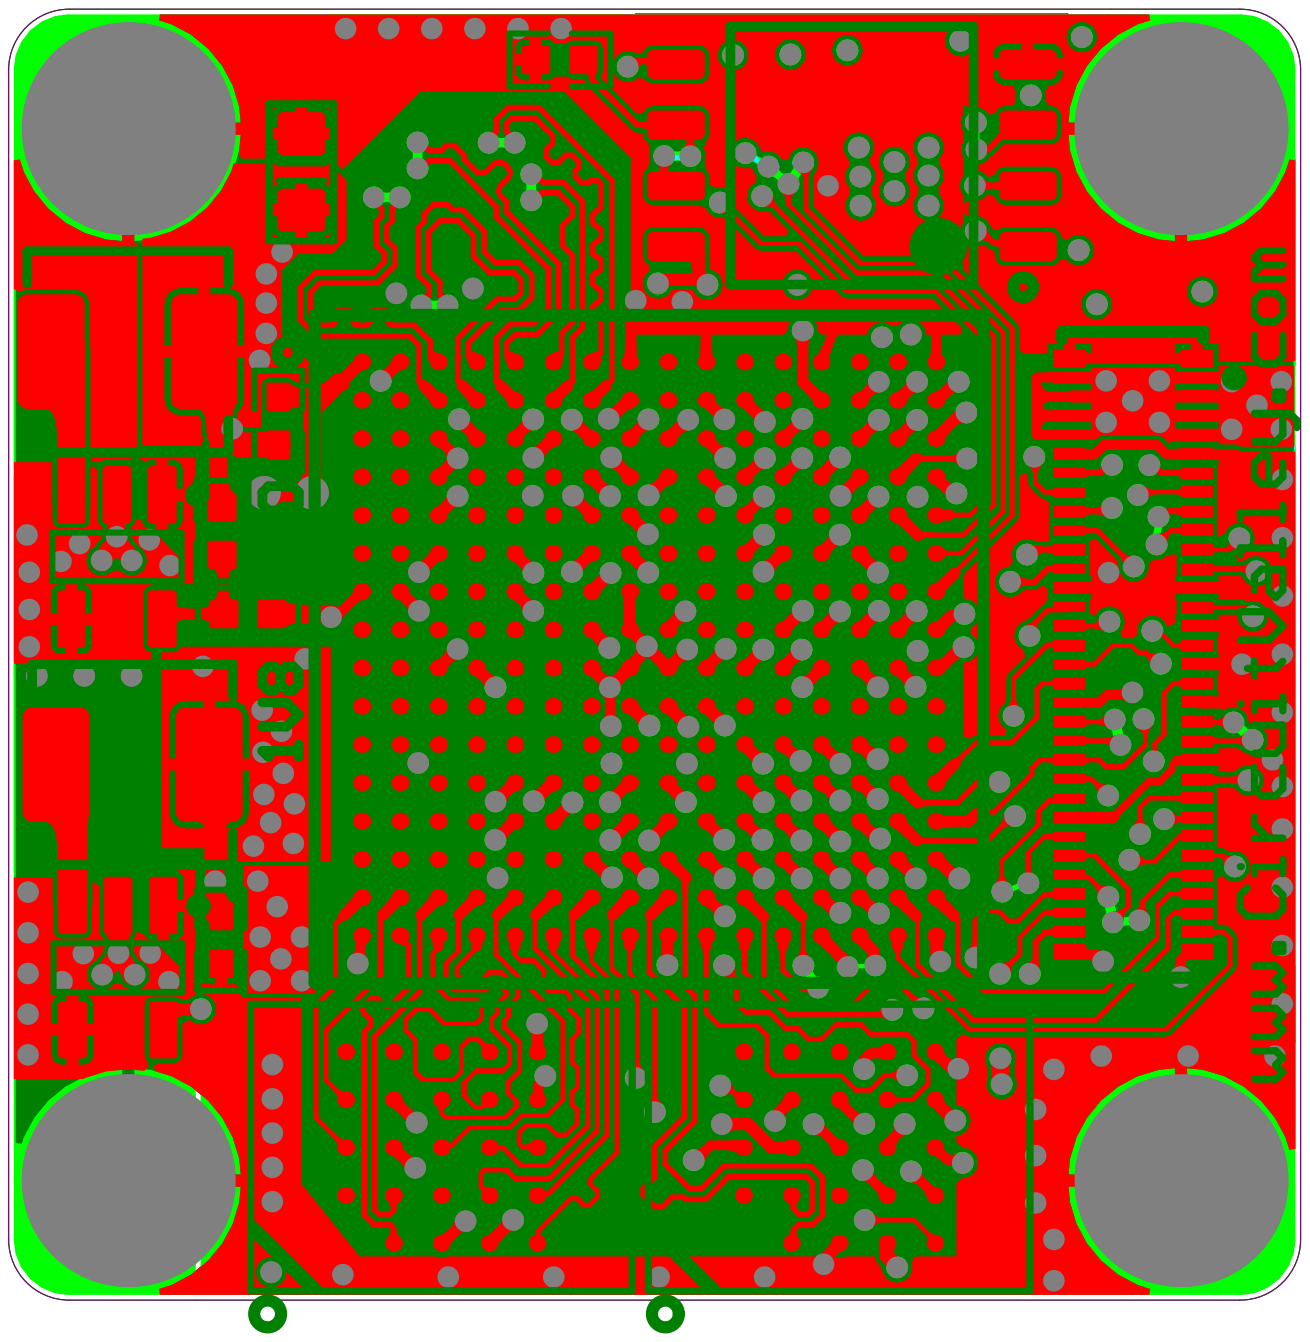
[picture p99: page 7]
