ShellAlbert/PoFDualCAM/1-PSU/Schematic/SCH-PSU-C1.pdf

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

## Farad Capacitor

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

### LTC3105 400mA Step-Up DC/DC Converter Auxiliary 6mA LDO Regulator

Photovoltaic Cell

Photovoltaic Cell

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

THIS RESISTOR IS USED TO BYPASS AMP.

P5V0

### Vout=1.2V*(1+R2/R1) =1.2V*(1+1M/309K)

=5.08V

LTC3539
2A 1MHz Synchronous Step-Up DC/DC Converters VIN=0.7V~5V

## GAIN=1

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

## VCMP

# Open-Drain

## VCMP

OR

## OR Y=A|B

## AND Y=A&B

BIAS

Make sure IO is in tri-state during power up.

### MODE = High: Burst Mode operation at light loads, >=0.88V MODE = Low: Fixed frequency PWM Mode, <0.3V

CAUTION: No Polarity Protection Circuit Designed ! DIODES OR MOSFETS WILL CAUSE VOLTAGE DROP.

# IVC AMP

# BYPASS NOT

# CMP

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

OR

### AND

LED turns on at
I=(5.0-2.2)/56K=50uA

Vin_rise=Vref*(R1+R2)/R2
=1.0V*(160+300)/300
=1.53V

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

Vin_rise=Vref*(R1+R2)/R2
=1.0V*(1000+5100)/5100
=1.2V

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

# 1.9V(FALL) 2.4V(RISE)

# 2.94V(FALL) 4.59V(RISE)

L=Vout*(1-D)*T/(CR*Iout)
=5.0*(1-50%)*1uS/(30%*200mA) =4.2uH

Vfd=1.23V

Ve

R2

R1

R4

R3

Re

Rin

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

CDONE,
Open-drain Output Configuration Done output. With weak pullup resistor to VCCIO_X.

# 1.8V IO

# SPI PROGRAMMING INTERFACE

# sysCONFIG Port / Pins

Horizontal-Short to Program Flash Vertical-Short to Program iCE

# OPEN-DRAIN PULL-UP

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

# BUFFERING Octal RAM

2.0V

# ECL DRIVER POWER TO DPU CONNECT TO TMR/DPU

# RECEIVE: IVC->AMP->CMP->NOT

# OFFSET=1/2VCC

# NOT

VTH SETTING

The maximum source/sink current of IOs are 4mA.

## (1.8V IO)

## (1.8V IO)

## (1.8V IO)

EXCLUSIVE
LD_PWR_EN FOR TMR
LD_PWR_EN_EXT FOR DPU

EXCLUSIVE
PSU_UART_TX FOR TMR
DPU_UART_TX FOR DPU

EXCLUSIVE
PSU_UART_RX FOR TMR
DPU_UART_RX FOR DPU

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

0R

0R

Jumpers used to cut off power supply of FPGA if it’s useless in realistic application.

# LTC3539 BOOST

P5V0

# MAX38650 BUCK

P1V8

# LTC3542 BUCK

# LTC3542 BUCK

# LASER DIODE TX&RX (ADJ)

# SENSOR(5V0) TMR(3V3) ULTRASONIC(3V3)

# iCE40UP5K FPGA

P2V8

# MAX38650 BUCK

P2V8

P1V8

### CONNECT TO VCAP

TO GET HIGHER EFFICIENCY.

P1V2

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

## Vfd=2.2V

P5033

LED turns on at
I=(2.8-2.2)/12K=50uA

Vout=0.6V*(1+R2/R1)
=0.6V*(1+150K/33.2K)
=3.3V

# MAX38650 BUCK

P1V2

# P1V8ADJ

Vout=0.6V*(1+R2/R1)
=0.6V*(1+150K/75K)
=1.8V

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

Enable Bypass Resistor to distribute P5V0.

P5033

# P1V8ADJ

# LOAD SWITCH

VFD=0.37V@20mA

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

H/C Type
Compatible
2F/5.5V

H/C Type
Compatible
2F/5.5V

LDO22-1

LDO22-2 VCAP

LDO22-2 VCAP

LDO22-2

LDO22-2

LDO22-2

LDO22-2 | LDO22-1
LDO22-1 | P1V8_RX

P1V8_RX

P1V8_RX

P1V8_RX

P1V8_RX

LDO22-1

VCAP

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

P2V8

P5V0 | P5V0 | P5033
P1V8 | P1V80 P1V2 | P1V20 P1V20
LDO22-1 | P¹V⁸_RX

P1V8_RX

P5V0

VCAP1 VCAP2 | P5V0 | P2V8 P1V8 P5V0 P5V0 P5V0 | P1V2 | P5033 P5V0 | P5033_PRE
P5V0 | P1V8ADJ P1V8ADJ_PRE

P1V8ADJ

P1V8 P1V8ADJ | P1V8_RX
Title Size | Document Number | Rev Date: | Sheet | of PoF TINY DUAL CAMERA PROJECT | C1 PART ONE - POWER SUPPLY UNIT SCHEMATIC
A2 | Tuesday, February 25, 2025 | 1 | 1 Title Size | Document Number | Rev Date: | Sheet | of PoF TINY DUAL CAMERA PROJECT | C1 PART ONE - POWER SUPPLY UNIT SCHEMATIC
A2 | Tuesday, February 25, 2025 | 1 | 1 Title Size | Document Number | Rev Date: | Sheet | of PoF TINY DUAL CAMERA PROJECT | C1 PART ONE - POWER SUPPLY UNIT SCHEMATIC
A2 | Tuesday, February 25, 2025 | 1 | 1

C73

22uF

L8

2.2uH

TP8 R76 DNI

R19 | DNP
R54 | 1K | R6 | 1K

U15 LTC3105EDD#PBF

FB

1

LDO

### 2 FBLDO

### 3 SHDN

### 4 MPPC

# 5 VIN

### 6 SW

### 7 PGOOD

### 8 VOUT

### 9 AUX

10 11 GND

C52

10uF

R1
20K

R88

0

R119 0 | R⁵
C59 | 0.1uF | 20K | R116 10K

R66 DNI

R109 | 0
R18 | 10K
R121 | 0 R10 | 0
R63 | 0 | FB4 BLM15PX121SN1D D6 GREEN LED C130723 | R⁴ 20K | C76 | 0.1uF
L4 | 2.2uH/200mA | C68

0.1uF

C72

22uF

R118 DNP | U3 APS25608N-OBR-BD
RST A4 | CE
A3 | | | | | | | | | CLK
B2 | A/DQ0 D3 | A/DQ1 D2 | A/DQ2 C4 | A/DQ3 D4 | A/DQ4 D5 | A/DQ5 E3 | A/DQ6 E2 | A/DQ7 E1 | DQS/SM
C3 | VDD
D1 VSS | C1 VDD

# E4 VSS

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

# J1 CONN-1X8

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
### 9 C30

10uF | R¹² 6.8K
C43 | 0.1uF

C51

0.1uF

U22 | SN74LVC1G32DBVR

C10096 1 A

### 2 B

### 3 GND

### 4 Y

### 5 VCC

D5 GREEN LED

C130723

L7 2.2uH

R113 DNP

C35

0.1uF R100 DNP | R³ 20K

C44

10uF | C62
33pF | R¹⁴ 6.8K

C29

# 1uF R38

200K | R60
20K | R114 0 TP16 | R¹³ 6.8K
U8 | MAX38650AANT+ A²
IN | LX A1 | OUT B2 EN
B1 | RSEL | B3 A³ GND

R41
100R

C21

0.1uF | C45

10nF

TP10 | R91 | 0 | C54
| | | 10uF
L6 | 10uH/1A C177242 | C23

10uF

R2 0

SW1

1 2

R72 160

C64

10uF | R90 | 0 | U5 W25Q64JWSSIQ
| | | CS
1 | DO(IO1) 2 | WP(IO2) 3 | GND
DI(IO0) | 4

### 5 CLK

6 | HLD/RST(IO3) 7 | VCC

8

C75 | DNP
L2 | 2.2uH/200mA C31

10uF

R92 10K

C39

0.1uF

TP2

TP4 | R106 0
C8 | 0.1uF

TP9 Q6 MMBT2222ALT1G

R42 | 1K
U2 | MAX38650AANT+ A²
IN | LX A1 | OUT B2 EN
B1 | RSEL | B3 A³ GND | iCE40UP5K - SG48 | Bank1 Bank0 | Bank2

iCE40UP5K- SG48

U4

C2678152 | IOB_0A

46

IOB_2A

47
IOB_3B_G6

44

IOB_4A

48
IOB_5B

45

IOB_6A

2

IOB_8A

4
IOB_9B

# 3 CRESET_B

### 8 CDONE

7

IOB_13B

6

IOB_16A

9

IOB_18A

### 10 IOB_20A

11

IOB_22A

12
IOB_23B

21
IOB_24A

13
IOB_25B_G3

20
IOB_29B

19
IOB_31B

18

IOB_32A_SPI_SO

### 14 IOB_33B_SPI_SI 17 IOB_34A_SPI_SCK

### 15 IOB_35B_SPI_SS

### 16 VCCPLL

29

IOT_36B

### 25 IOT_37A

23

IOT_38B

### 27 IOT_39A

26

IOT_41A

28

IOT_42B

### 31 IOT_43A

32

IOT_44B

### 34 IOT_45A_G1

37

IOT_46B_G0

35

IOT_48B

### 36 IOT_49A

43

IOT_50B

### 38 IOT_51A

### 42 RGB0

### 39 RGB1 40 RGB2

# 41 GND 49 VCC

### 5 VCC

# 30 VCCIO_0

### 33 SPI_VCCIO1

# 22 VCCIO_2

### 1 VPP_2V5

### 24 D7

1N5819WT | C46
0.1uF R7 | 1K R¹⁷ 0 C56

0.1uF C32

1uF

R32

### 51 C57

0.1uF

R95 2K C5 CEN5R5205HF-ZG

1 2

3 4

D8 | GREEN LED C130723
R15 | DNP

R79

300 | R67 | 3.3K
R25 | DNP
R59 | 0

R35
510

C6 CEN5R5205HF-ZG

1 2

3 4

R29

510 R93 10K

U21 LTC3539EDCB-2#TRPBF SW

### 1 PGND

### 2 GND

# 3 VIN

### 4 SHDN

### 5 FB

### 6 MODE

### 7 VOUT

### 8 EPAD

### 9 R89 DNI

R82
10K
R16 | DNI | L12 10uH
R56
1M

C22

0.1uF R97 | 0 C42 | 2.2uF

REF

+

- U16 | ADCMP380-1ACBZ-RL7 A¹ VCC GND A² B1 EN | GND B²

IN

C1 | OUT C2 R39
1M

C71 0.1uF

C28

22pF | R87 DNI

D4GREEN LED

R44
2M

C24

10nF R80 | 150K
C2710uF | R36
75K C49 | 22pF R52
5.1K | U12 OPA320AIDBVROUT

### 1 V⁻ 2

IN+

3

IN- 4 V⁺

5

D3GREEN LED R73 | 0R75 | 12K R¹⁰⁸ DNI
R70 | 0 R61
200K | C40.1uF

TP12 Solar Cell V+

C63
0.1uF

LD1 LaserDiode
LD+

1
LD- 2 | PD- | 3 PD+

4

C67

22uF C3

10uF | U10

LMV7291MGX/NOPB VOUT

1 | V⁻ 2 | +IN

3

| | -IN

### 4 V⁺

5

TP14 Solar Cell V-

C65
0.1uF

## FB1BLM¹⁵PX¹²¹SN¹D

CONN-24P J2

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
R22 | 0 | R⁵⁷ 4.7K

L11 47uH/100mA R⁹⁶

0 | R123 | DNP
U13 | ADA4051-2ARMZ C160715

### 1 OUT A -IN A

2 +IN A
3

### 4 V-8 V+ OUT B 7

-IN B

6 +IN B

5 | C55 | 0.1uF

## FB2BLM¹⁵PX¹²¹SN¹D

C2

0.1uF CONN-24P J3

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
C70 0.1uF

C9

10nF

TP6

R71 | 3.3K | C58
10uF | D2GREEN LED
C1 | 0.1uF

U17

SN74LVC1G32DBVR 1 | C10096 A

### 2 B

### 3 GND

### 4 Y

### 5 VCC

R104 6.8K

R62

270K R48
1M

## C120.1uF

TP11 Solar Cell V-

Q1

BFR93AWH6327 | B1

### 3 C

2E

L10 | 4.7uH/200mA

U1
LTC3542ES6 VIN

### 1 GND

### 2 VFB

### 3 RUN

### 4 MODE/SYNC

### 5 SW

### 6 C16

47uF

C10

0.1uF

R101 DNP

C48 2.2uF

REF

+

- U18 | ADCMP380-1ACBZ-RL7 A¹ VCC GND A² B1 EN | GND B²

IN

C1 | OUT C2 | C61
0.1uF | C25
| 0.1uF
L1 | 47uH/200mA

C33

22pF

R31

# 510 R⁶⁸ 10K

TP1
TP3 | R⁵⁵ 4.7K

## C6010uF

FB3

BLM15PX121SN1D

TP15 | C17
47uF R53 | 100K

C53

22uF

C69

0.1uF

C26

10nF

R124 DNP

R58 40.2K

R33
510
R111 | 10K R⁴⁵ 10K
R117 | DNP | R103
100K Q5 | MMBT2222ALT1G
R37 | 150K

R112 11.8K

R11
51

R49
270K

U9 SN74LVC1G14DBVR
NC

### 1 A 2 GND 3 Y

### 4 VCC

5

L3 | 2.2uH/200mA R83 | 100K | R86 | 2.2K

R115 DNP R⁴⁶ DNI

C34

22uF | R⁷⁷ 10K
C37 | 0.1uF

C11

0.1uF R120 100K | R²⁷ 0

C18

10uF

Q2

BFR93AWH6327 1B

### 3 C

# 2E R84 20K U6 MAX38650AANT+ A2

IN | LX A1 | OUT B2 EN
B1 | RSEL | B3 A³ GND R³⁰ DNI | R34 | 0
R122 DNP C70.1uF
R47 | 0 | Q4 | MMBT2222ALT1G
L9 | 2.2uH
C19 | 22pF

## FB5BLM¹⁵PX¹²¹SN¹D

R102 1K | C66 | 1.5pF R⁵¹ 10K
TP13 Solar Cell V+ | R78 | 0
R8 | 1K

U14 LTC3105EDD#PBF

FB

1

LDO

### 2 FBLDO

### 3 SHDN

### 4 MPPC

# 5 VIN

### 6 SW

### 7 PGOOD

### 8 VOUT

### 9 AUX

10 11 GND

C41

0.1uF C50

0.1uF

L5 | 10uH/1A C177242 | U19

LTC3542ES6 VIN

### 1 GND

### 2 VFB

### 3 RUN

### 4 MODE/SYNC

### 5 SW

### 6 PD1Photodiode

1 2

R64 | DNP C38 | 0.1uF | R81

33.2K R43
1M

R74 0 R69 0

R23 | DNP | C14
47uF | R24 | DNP Q3 MMBT2222ALT1G
R26 | 0

C36

10nF R65 0

C13

0.1uF R107 0

## C4710uF

R110 10K

R94 | DNP | C74
47uF R85 | DNP R40
1M

U20

SN74AUP1G08DBVR

C139409 VCC

### 5 GND

### 3 A

### 1 B

### 2 Y

4

TP17

R28 | DNP R21 | 0

C40

10nF R105

1M

TP5

R98

309K

TP7

U11 OPA320AIDBVR OUT

### 1 V⁻ 2

IN+

3

IN- 4 V⁺

### 5 R20 0

D1 GREEN LED

C130723

R99 0 C20

10uF

C15

0.1uF | U7 | TPS22995HQDDCRQ1 VIN

### 2 VBIAS 1 ON 3 GND

RT 4

### 6 VOUT

### 5 R50 510

R9
20K UV_SHDN
CHG_FULL | 1ST_EN

IO_P5V0_SHDN

FP2_SO | FL2_MOSI FL2_MISO | FP2_SI FF2_SS | FF2_SS
FF2_SCK | | FF2_SCK
FP2_SI | FL2_MOSI FP2_SO | FL2_MISO
| | FL2_WP
FP2_RST | | FL2_RST
FP2_DONE

IO3 SPI1_NSS

IO2 SPI2_NSS

IO7
IO1 | DONE2_LED
IO4
IO_P5V0_SHDN
IAM_ALIVE
SPI2_MISO | PSU_UART_RX
FP2_SI SPI1_MISO

FF2_SS

SPI2_SCK

FF2_SCK

SPI1_SCK

FP2_SO

IO6 SPI1_MOSI RAM_RST

IO5 RAM_ADQ1 | | | | PSU_UART_TX LD_PWR_EN
RAM_ADQ2 | RAM_ADQ6 RAM_DQS | RAM_ADQ3 SPI2_MOSI | RAM_ADQ5 RAM_CLK | RAM_ADQ4 RAM_ADQ0 RAM_ADQ7

LED0
LED1
LED2 | RAM_RST RAM_CE RAM_CLK RAM_ADQ0 RAM_ADQ1 RAM_ADQ2 RAM_ADQ3 RAM_ADQ4 RAM_ADQ5 RAM_ADQ6 RAM_ADQ7 RAM_DQS

LED0

LED1

LED2

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

IAM_ALIVE

IAM_ALIVE_EXT | SIG_ALIVE

RAM_CE

IO_P5V0_SHDN_EXT

FP2_RST

FF2_SS
FP2_SI

PSU_UART_TX DPU_UART_TX

PSU_UART_RX DPU_UART_RX

LD_PWR_EN

LD_PWR_EN_EXT | RX_PWR_EN

RX_PWR_EN

IO4

IO7

5

4

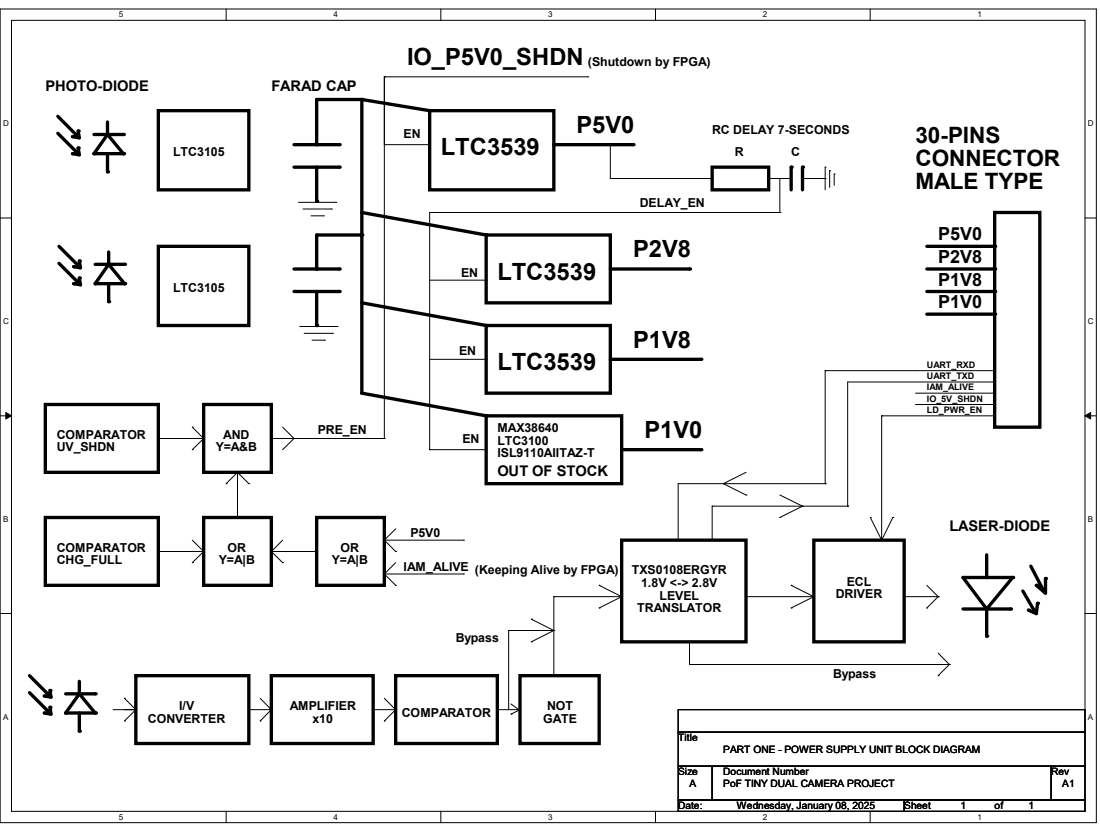
[picture p100: page 2]
LTC3539; MAX38640 LTC3100 ISL9110AIITAZ-T; OUT OF STOCK; DELAY_EN; LTC3105; COMPARATOR CHG_FULL; PRE_EN; IO_P5V0_SHDN; I/V CONVERTER; AMPLIFIER; COMPARATOR; NOT; GATE; ECL DRIVER; TXS0108ERGYR 1.8V <-> 2.8V LEVEL TRANSLATOR; IAM_ALIVE; COMPARATOR UV_SHDN; AND Y=A&B; PHOTO-DIODE; LASER-DIODE; FARAD CAP; Bypass; 30-PINS CONNECTOR MALE TYPE; UART_TXD; UART_RXD; IO_5V_SHDN; LD_PWR_EN; Title; Size; Document Number; Rev; Date:; Sheet; PoF TINY DUAL CAMERA PROJECT; Wednesday, January 08, 2025

(Shutdown by FPGA)

RC DELAY 7-SECONDS

(Keeping Alive by FPGA)

PART ONE - POWER SUPPLY UNIT BLOCK DIAGRAM
