ShellAlbert/PoFDualCAM/2-DPU/SCH-DPU-C1.pdf

# OV5640 DVP FPC-24

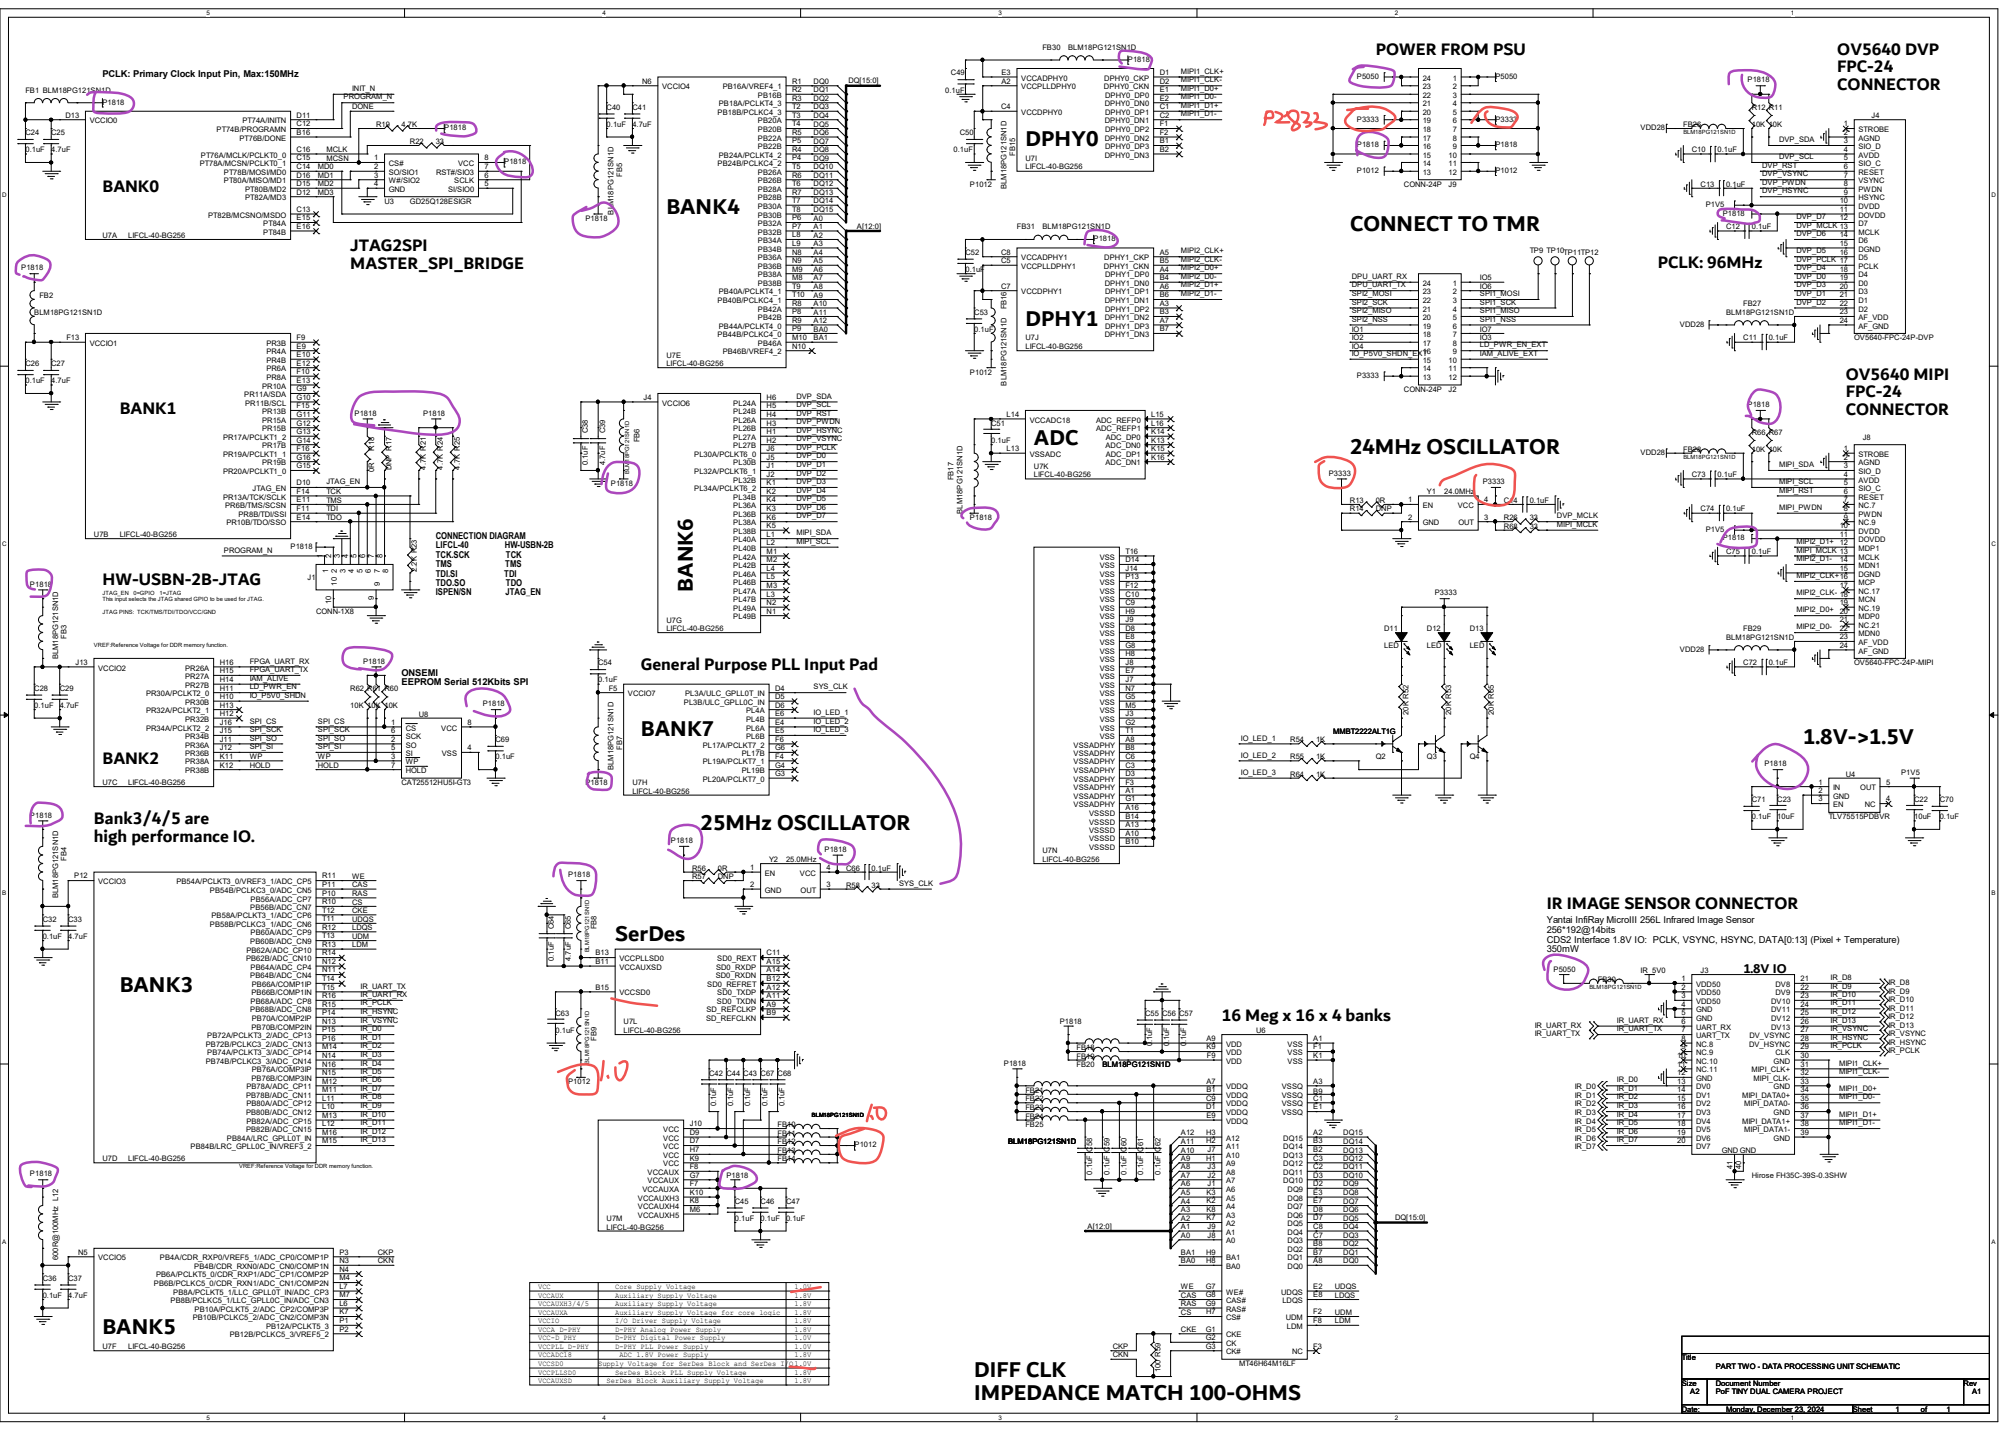
[picture p101: page 1]

PCLK: Primary Clock Input Pin, Max:150MHz

D10 PR13A/TCK/SCLK
F14 PR6B/TMS/SCSN
E11 PR8B/TDI/SSI F11 PR10B/TDO/SSO

JTAG_EN 0=GPIO 1=JTAG
This input selects the JTAG shared GPIO to be used for JTAG.

General Purpose PLL Input Pad ONSEMI

JTAG PINS: TCK/TMS/TDI/TDO/VCC/GND

VREF:Reference Voltage for DDR memory function.

T1 VSSADPHY
A8 VSSADPHY
B8 VSSADPHY C6 VSSADPHY C3 VSSADPHY D3 VSSADPHY

IR IMAGE SENSOR CONNECTOR

Yantai InfiRay MicroIII 256L Infrared Image Sensor
256*192@14bits
CDS2 Interface 1.8V IO: PCLK, VSYNC, HSYNC, DATA[0:13] (Pixel + Temperature)
