ShellAlbert/PoFDualCAM/1-POF-PSU-C2/Fabrication_History/PSU_C2_6Layers_90x30mm/SMT/ASSEMBLY_BOTTOM.pdf

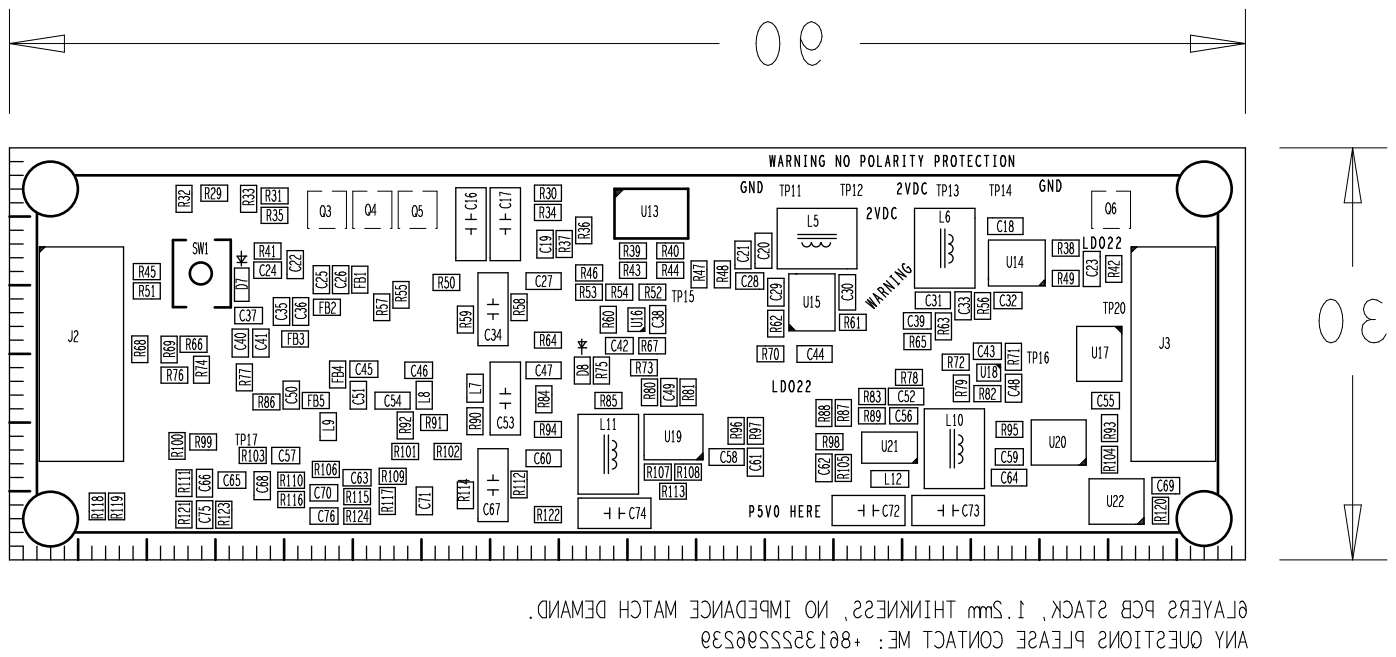
[picture p102: page 1]
