ShellAlbert/PoFDualCAM/1-POF-PSU-C2/Fabrication_History/PSU_C2_6Layers_90x30mm/SMT/ASSEMBLY_TOP.pdf

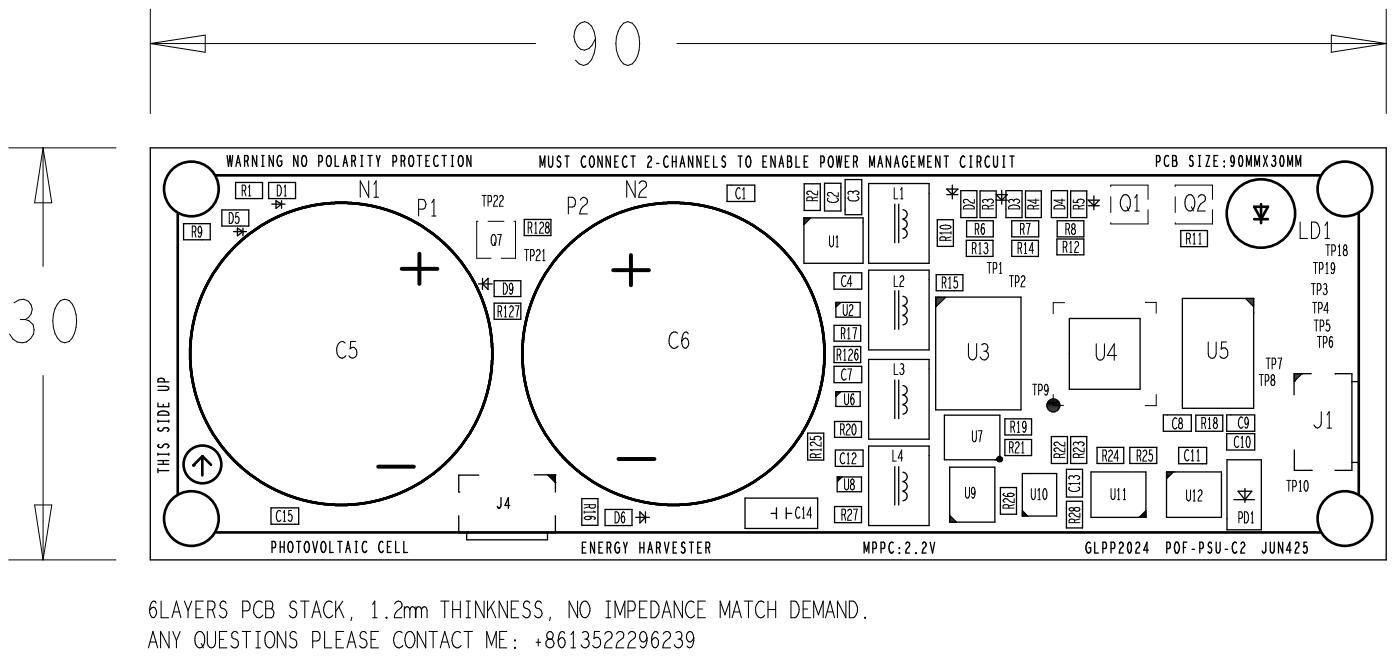
[picture p103: page 1]
