ShellAlbert/PoFDualCAM/2-DPU_HyperRAM_Version/Frame_Structure_Protocol/PoF_Frame_Structure_V0.1.pdf

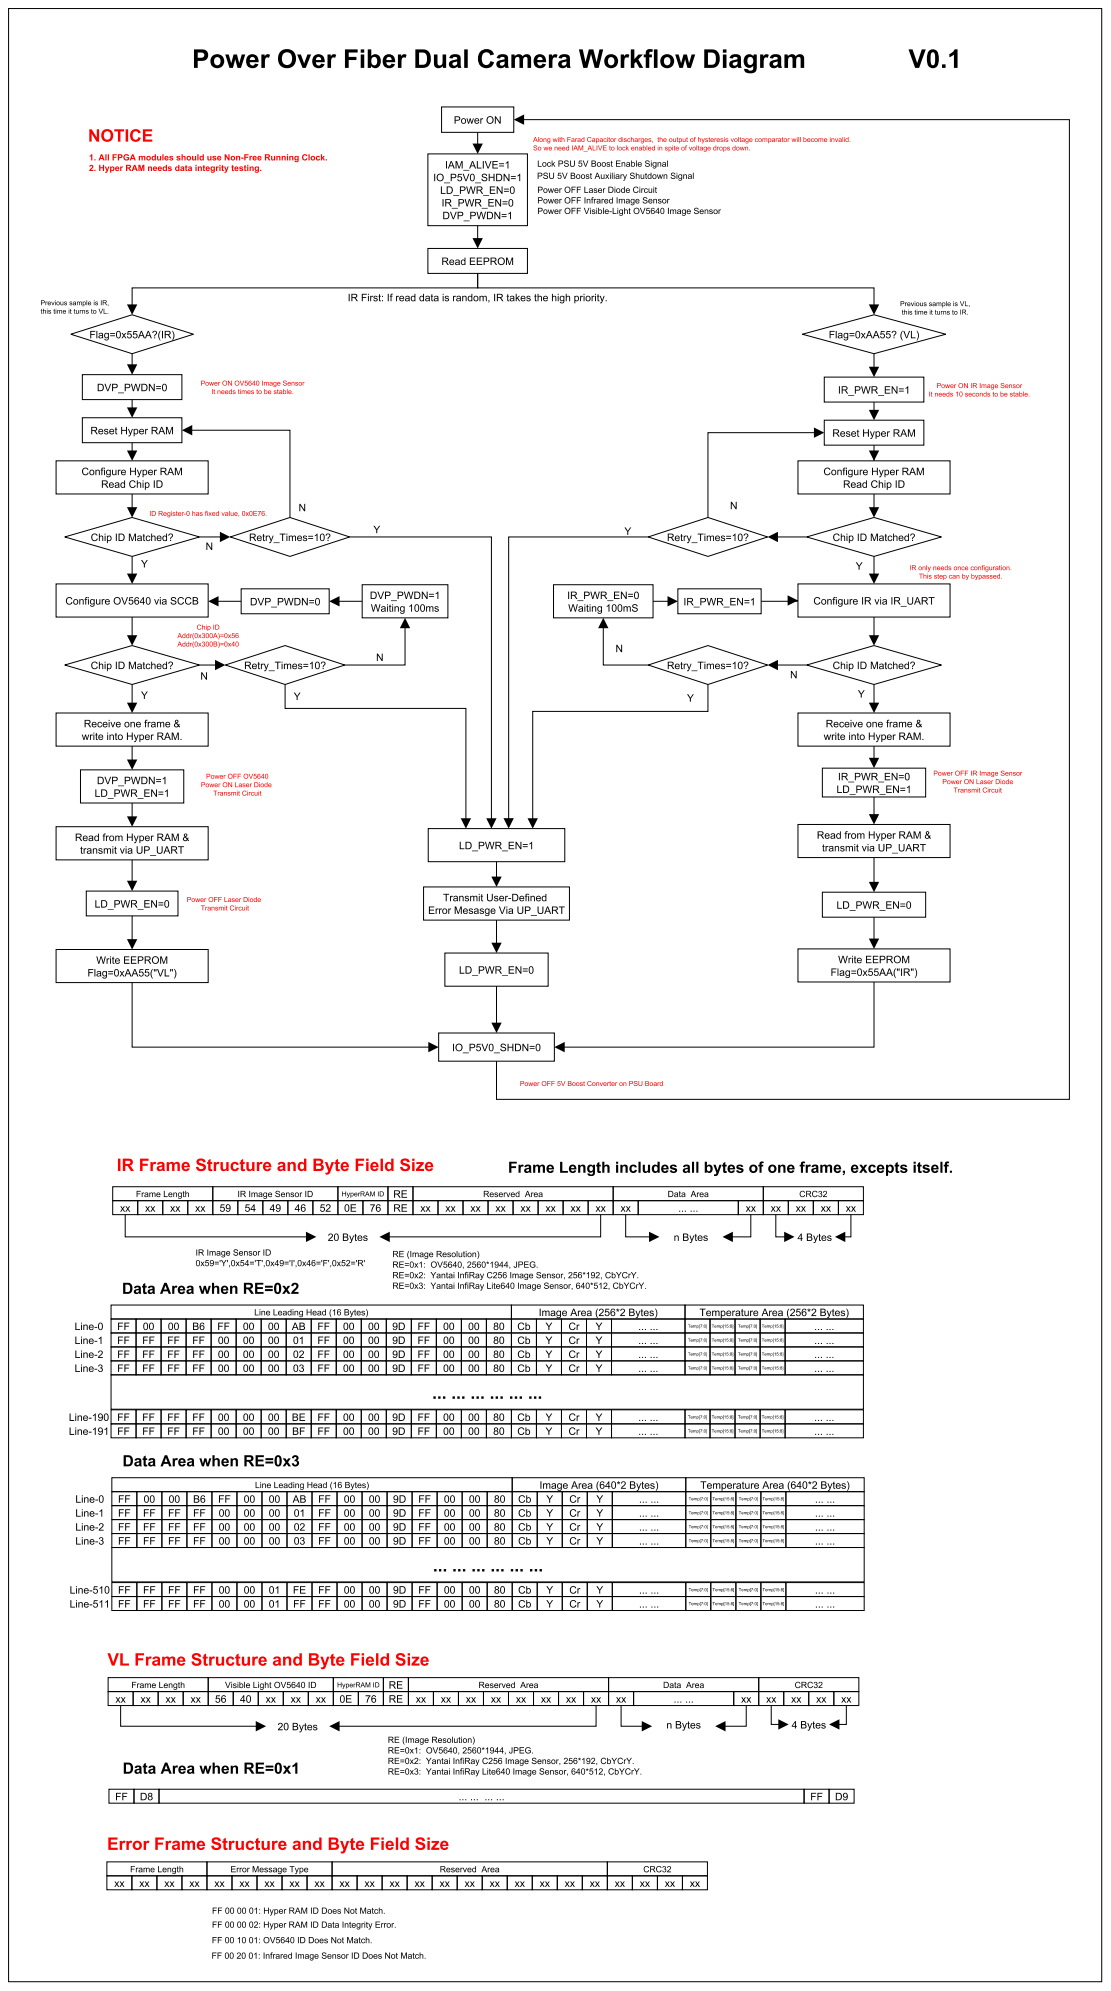
[picture p104: page 1]
