ShellAlbert/PoFDualCAM/(list of files, drawings)

Other design files:
1-POF-PSU-C2/Schematic/LIBRARY1.OLB
1-POF-PSU-C2/Schematic/PSU.DSN
1-POF-PSU-C2/Schematic/PSU.opj
1-PSU/Schematic/PSU.DSN
1-PSU/Schematic/PSU.opj
2-DPU/LATTICEPLDS.opj
2-DPU/Schematic/DPU.DSN
2-DPU/Schematic/DPU.opj
2-DPU/Schematic/LIBRARY1.OLB
2-DPU_HyperRAM_Version/Schematic/DPU.DSN
2-DPU_HyperRAM_Version/Schematic/DPU.opj
2-DPU_HyperRAM_Version/Schematic/LATTICEPLDS.OLB
2-DPU_HyperRAM_Version/Schematic/LIBRARY1.OLB
5-PGAdapter/LIBRARY1.OLB
5-PGAdapter/PGADAPTER.DSN
5-PGAdapter/PGAdapter.opj
LIFCL-40-7BG256I_REF_Documents/Datasheets/CrossLink-NX PCIe Bridge Board/CROSSLINK-NX_PCIE_V2 (1).DSN
LIFCL-40-7BG256I_REF_Documents/Datasheets/CrossLink-NX PCIe Bridge Board/CROSSLINK-NX_PCIE_V2.DSN
