ShellAlbert/PoFDualCAM/2-DPU_HyperRAM_Version/Radiant_Project/POF_DPU_FW/source/impl_1/IPCore/ZPLL/testbench/dut_params.v

localparam INTFBKDEL_SEL = "DISABLED";
localparam PMU_WAITFORLOCK = "ENABLED";
localparam REF_OSC_CTRL = "3P2";
localparam REF_COUNTS = "0000";
localparam EN_REFCLK_MON = 0;
localparam FVCO = 1600.000000;
localparam CLKI_FREQ = 25.000000;
localparam CLKI_DIVIDER_ACTUAL_STR = "1";
localparam FRAC_N_EN = 0;
localparam FBK_MODE = "INTCLKOP";
localparam FBCLK_DIVIDER_ACTUAL_STR = "4";
localparam SSC_N_CODE_STR = "0b000000100";
localparam SSC_F_CODE_STR = "0b000000000000000";
localparam SS_EN = 0;
localparam SSC_PROFILE = "DOWN";
localparam SSC_TBASE_STR = "0b000000000000";
localparam SSC_STEP_IN_STR = "0b0000000";
localparam SSC_REG_WEIGHTING_SEL_STR = "0b000";
localparam CLKOP_BYPASS = 0;
localparam ENCLKOP_EN = 0;
localparam CLKOP_FREQ_ACTUAL = 100.000000;
localparam CLKOP_PHASE_ACTUAL = 0.000000;
localparam DIVOP_ACTUAL_STR = "15";
localparam DELA = "15";
localparam PHIA = "0";
localparam TRIM_EN_P = 0;
localparam CLKOP_TRIM_MODE = "Falling";
localparam CLKOP_TRIM = "0b0000";
localparam CLKOS_EN = 0;
localparam CLKOS_BYPASS = 0;
localparam ENCLKOS_EN = 0;
localparam CLKOS_FREQ_ACTUAL = 100.000000;
localparam CLKOS_PHASE_ACTUAL = 0.000000;
localparam DIVOS_ACTUAL_STR = "7";
localparam DELB = "7";
localparam PHIB = "0";
localparam TRIM_EN_S = 0;
localparam CLKOS_TRIM_MODE = "Falling";
localparam CLKOS_TRIM = "0b0000";
localparam CLKOS2_EN = 0;
localparam CLKOS2_BYPASS = 0;
localparam ENCLKOS2_EN = 0;
localparam CLKOS2_FREQ_ACTUAL = 100.000000;
localparam CLKOS2_PHASE_ACTUAL = 0.000000;
localparam DIVOS2_ACTUAL_STR = "7";
localparam DELC = "7";
localparam PHIC = "0";
localparam CLKOS3_EN = 0;
localparam CLKOS3_BYPASS = 0;
localparam ENCLKOS3_EN = 0;
localparam CLKOS3_FREQ_ACTUAL = 100.000000;
localparam CLKOS3_PHASE_ACTUAL = 0.000000;
localparam DIVOS3_ACTUAL_STR = "7";
localparam DELD = "7";
localparam PHID = "0";
localparam CLKOS4_EN = 0;
localparam CLKOS4_BYPASS = 0;
localparam ENCLKOS4_EN = 0;
localparam CLKOS4_FREQ_ACTUAL = 100.000000;
localparam CLKOS4_PHASE_ACTUAL = 0.000000;
localparam DIVOS4_ACTUAL_STR = "7";
localparam DELE = "7";
localparam PHIE = "0";
localparam CLKOS5_EN = 0;
localparam CLKOS5_BYPASS = 0;
localparam ENCLKOS5_EN = 0;
localparam CLKOS5_FREQ_ACTUAL = 100.000000;
localparam CLKOS5_PHASE_ACTUAL = 0.000000;
localparam DIVOS5_ACTUAL_STR = "7";
localparam DELF = "7";
localparam PHIF = "0";
localparam PLL_REFCLK_FROM_PIN = 0;
localparam IO_TYPE = "LVDS";
localparam DYN_PORTS_EN = 0;
localparam PLL_RST = 0;
localparam LOCK_EN = 1;
localparam PLL_LOCK_STICKY = 0;
localparam LMMI_EN = 0;
localparam APB_EN = 0;
localparam APB_SOFT_REG_EN = 0;
localparam LEGACY_EN = 0;
localparam POWERDOWN_EN = 0;
localparam IPI_CMP = "0b1100";
localparam CSET = "8P";
localparam CRIPPLE = "1P";
localparam IPP_CTRL = "0b0110";
localparam IPP_SEL = "0b1111";
localparam BW_CTL_BIAS = "0b1111";
localparam V2I_PP_RES = "9K";
localparam KP_VCO = "0b00011";
localparam V2I_KVCO_SEL = "60";
localparam V2I_1V_EN = "ENABLED";
`define je5d00
`define LIFCL
`define LIFCL_40
