ShellAlbert/PoFDualCAM/2-DPU_HyperRAM_Version/Radiant_Project/POF_DPU_FW/source/impl_1/IPCore/ZPLL/misc/ZPLL_tmpl.vhd

component ZPLL is
    port(
        clki_i: in std_logic;
        clkop_o: out std_logic;
        lock_o: out std_logic
    );
end component;

__: ZPLL port map(
    clki_i=>,
    clkop_o=>,
    lock_o=>
);
