ShellAlbert/PoFDualCAM/2-DPU_HyperRAM_Version/Radiant_Project/POF_DPU_FW/source/impl_1/ZPortableDefine.v

`timescale 1ps/1ps

//Enable following line in ModelSim.
//Disable it in Lattice Radiant.
//`define USING_MODELSIM 1
//`define USING_MODELSIM 1

//Using fixed test data replace real pixel and temperature data.
//`define USING_TEST_DATA 1
//`define USING_TEST_DATA 1

//for external loop.
`define STEP_00  (0)
`define STEP_01  (1)
`define STEP_02  (2)
`define STEP_03  (3)
`define STEP_04  (4)
`define STEP_05  (5)
`define STEP_06  (6)
`define STEP_07  (7)
`define STEP_08  (8)
`define STEP_09  (9)
`define STEP_10  (10)
`define STEP_11  (11)
`define STEP_12  (12)
`define STEP_13  (13)
`define STEP_14  (14)
`define STEP_15  (15)
`define STEP_16  (16)
`define STEP_17  (17)
`define STEP_18  (18)
`define STEP_19  (19)
`define STEP_20  (20)
`define STEP_21  (21)
`define STEP_22  (22)
`define STEP_23  (23)
`define STEP_24  (24)
`define STEP_25  (25)

//for internal loop.
`define STEP_00_00  (0)
`define STEP_00_01  (1)
`define STEP_00_02  (2)
`define STEP_00_03  (3)
`define STEP_00_04  (4)
`define STEP_00_05  (5)
`define STEP_00_06  (6)
`define STEP_00_07  (7)
`define STEP_00_08  (8)
`define STEP_00_09  (9)
`define STEP_00_10  (10)
`define STEP_00_11  (11)
`define STEP_00_12  (12)
`define STEP_00_13  (13)
`define STEP_00_14  (14)
`define STEP_00_15  (15)
`define STEP_00_16  (16)
`define STEP_00_17  (17)
`define STEP_00_18  (18)
`define STEP_00_19  (19)
`define STEP_00_20  (20)
`define STEP_00_21  (21)
`define STEP_00_22  (22)
`define STEP_00_23  (23)
`define STEP_00_24  (24)
`define STEP_00_25  (25)
`define STEP_00_26  (26)
`define STEP_00_27  (27)
`define STEP_00_28  (28)
`define STEP_00_29  (29)
`define STEP_00_30  (30)
