ShellAlbert/PoFDualCAM/(commit log)

2024-12-30 PSU 3.3V LaserDiode with 1.8V to 3.3V Level Translator
    [DPU-REVC1-1.brd, DPU.DSN, DPU.opj, LATTICEPLDS.opj, LIBRARY1.OLB, Lattice_library_contents.xls, MyADC.cfg, MyOSC.cfg]
2025-02-25 1st Fabrication PCB
    [LIBRARY1.OLB, PSU-C1-6Layers.brd, PSU-C1.brd, PSU.DSN, PSU.opj]
2025-03-17 March 17, 2025
    [DPU-C1-1.brd, DPU-C2.brd, DPU-REVC1-1.brd, DPU.DSN, DPU.opj, LIBRARY1.OLB, PG-ADAPTER-1.brd, PGADAPTER.DSN]
2025-04-01 Update PSU
    [PSU-C1-6Layers.brd, PSU.opj, ZPLL.cfg]
2025-05-25 Integrated Lattice LIFCL-40 Relevant Documents
    [FPGA-SC-02014-1-0_LIFCL_caBGA256_Pin_Migration.csv, FPGA-SC-02018-1-21_LIFCL40_Pinout.csv]
2025-06-12 PSU Add External LED Indicator Connector
    [BOM_OF_PSU_C2.xlsx, LIBRARY1.OLB, PSU-C2-6Layers - Copy.brd, PSU-C2-6Layers.brd, PSU.DSN, PSU.opj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]
